Normansrule/seedforge/docs/modules/README.md

# Modules

| module | name | phase | status |
|---|---|---|---|
| [M1](M1-feed-tension.md) | Feed + tension | 1 | core - designed, CAD-checked, not built |
| [M2](M2-winding.md) | Synchronized winding | 1 | core - designed, CAD-checked; firmware compile-tested + unit-tested |
| [M3](M3-clamp-cut-demold.md) | Clamp + cut + demold | 2 | core - sequence SOFTWARE-TESTED (host tests + simulator); mounting to the core cell open |
| [M4](M4-tail-forming.md) | Auxiliary tail forming | 3 | experimental - R3 fixture parts, not built |
| [M5](M5-free-drying.md) | Free drying | 4 | experimental |
| [M6](M6-assembly.md) | Seed + tip + three-tail assembly | 5 | experimental development tooling |
| [M7](M7-vision-qa.md) | Computer-vision QA | 6 | core camera in Phase 1; software tested on synthetic images only |
| [M8](M8-output.md) | Output storage | 5 | experimental |
| [M9](M9-xy-transfer.md) | XY transfer (optional) | 7 | upcoming - start manually |
| [M10](M10-drone-cassette.md) | Drone cassette (optional, downstream) | 8 | concept only - not flight-validated |
