Normansrule/seedforge/archive/seedforge-r3-package/cad/paper_reference/reference_manifest.csv

name | bbox_mm | step | stl | 3mf
MR01_0p8mm_x100mm_FORMING_MANDREL_REFERENCE | 0.80 x 0.80 x 100.00 | MR01_0p8mm_x100mm_FORMING_MANDREL_REFERENCE.step | MR01_0p8mm_x100mm_FORMING_MANDREL_REFERENCE.stl | MR01_0p8mm_x100mm_FORMING_MANDREL_REFERENCE.3mf
MR02_0p8mm_to_5mm_split_collet_INSERT | 5.00 x 5.00 x 12.00 | MR02_0p8mm_to_5mm_split_collet_INSERT.step | MR02_0p8mm_to_5mm_split_collet_INSERT.stl | MR02_0p8mm_to_5mm_split_collet_INSERT.3mf
MR03_mandrel_depth_stop_M2 | 8.00 x 8.00 x 5.00 | MR03_mandrel_depth_stop_M2.step | MR03_mandrel_depth_stop_M2.stl | MR03_mandrel_depth_stop_M2.3mf
MR04_0p8mm_guide_bushing | 8.00 x 8.00 x 10.00 | MR04_0p8mm_guide_bushing.step | MR04_0p8mm_guide_bushing.stl | MR04_0p8mm_guide_bushing.3mf
MR05_3mm_x140mm_LARGE_PINE_MANDREL_REFERENCE | 3.00 x 3.00 x 140.00 | MR05_3mm_x140mm_LARGE_PINE_MANDREL_REFERENCE.step | MR05_3mm_x140mm_LARGE_PINE_MANDREL_REFERENCE.stl | MR05_3mm_x140mm_LARGE_PINE_MANDREL_REFERENCE.3mf
MR06_COMPLETE_0p8mm_MANDREL_SUBASSEMBLY_REFERENCE | 12.00 x 12.00 x 124.00 | MR06_COMPLETE_0p8mm_MANDREL_SUBASSEMBLY_REFERENCE.step | MR06_COMPLETE_0p8mm_MANDREL_SUBASSEMBLY_REFERENCE.stl | MR06_COMPLETE_0p8mm_MANDREL_SUBASSEMBLY_REFERENCE.3mf
MR07_0p8mm_MANDREL_WITH_STANDARD_7COIL_BODY_REFERENCE | 2.64 x 2.64 x 100.79 | MR07_0p8mm_MANDREL_WITH_STANDARD_7COIL_BODY_REFERENCE.step | MR07_0p8mm_MANDREL_WITH_STANDARD_7COIL_BODY_REFERENCE.stl | MR07_0p8mm_MANDREL_WITH_STANDARD_7COIL_BODY_REFERENCE.3mf
PR01_standard_7coil_body_2p5x0p5_on_0p8 | 2.64 x 2.64 x 36.58 | PR01_standard_7coil_body_2p5x0p5_on_0p8.step | PR01_standard_7coil_body_2p5x0p5_on_0p8.stl | PR01_standard_7coil_body_2p5x0p5_on_0p8.3mf
PR02_standard_tail1_27mm | 12.18 x 10.48 x 13.21 | PR02_standard_tail1_27mm.step | PR02_standard_tail1_27mm.stl | PR02_standard_tail1_27mm.3mf
PR03_standard_tail2_29p5mm | 14.77 x 11.61 x 13.27 | PR03_standard_tail2_29p5mm.step | PR03_standard_tail2_29p5mm.stl | PR03_standard_tail2_29p5mm.3mf
PR04_standard_tail3_32p5mm | 11.02 x 17.51 x 13.34 | PR04_standard_tail3_32p5mm.step | PR04_standard_tail3_32p5mm.stl | PR04_standard_tail3_32p5mm.3mf
PR05_standard_tip_outer_reference | 5.51 x 5.53 x 14.50 | PR05_standard_tip_outer_reference.step | PR05_standard_tip_outer_reference.stl | PR05_standard_tip_outer_reference.3mf
PR06_standard_seed_payload_envelope | 3.60 x 2.50 x 4.80 | PR06_standard_seed_payload_envelope.step | PR06_standard_seed_payload_envelope.stl | PR06_standard_seed_payload_envelope.3mf
PR07_tip_hair_clearance_envelope | 9.28 x 9.26 x 16.70 | PR07_tip_hair_clearance_envelope.step | PR07_tip_hair_clearance_envelope.stl | PR07_tip_hair_clearance_envelope.3mf
PR08_STANDARD_FINISHED_3TAIL_SEED_CARRIER_1TO1 | 18.67 x 22.02 x 54.48 | PR08_STANDARD_FINISHED_3TAIL_SEED_CARRIER_1TO1.step | PR08_STANDARD_FINISHED_3TAIL_SEED_CARRIER_1TO1.stl | PR08_STANDARD_FINISHED_3TAIL_SEED_CARRIER_1TO1.3mf
PR09_STANDARD_SEED_CARRIER_EXPLODED_1TO1 | 48.28 x 55.10 x 84.48 | PR09_STANDARD_SEED_CARRIER_EXPLODED_1TO1.step | PR09_STANDARD_SEED_CARRIER_EXPLODED_1TO1.stl | PR09_STANDARD_SEED_CARRIER_EXPLODED_1TO1.3mf
PR10_primary_blank_48x2p5x0p5_reference | 48.00 x 2.50 x 0.50 | PR10_primary_blank_48x2p5x0p5_reference.step | PR10_primary_blank_48x2p5x0p5_reference.stl | PR10_primary_blank_48x2p5x0p5_reference.3mf
PR11_aux_tail_blank_29p5x2p5x0p5_reference | 29.50 x 2.50 x 0.50 | PR11_aux_tail_blank_29p5x2p5x0p5_reference.step | PR11_aux_tail_blank_29p5x2p5x0p5_reference.stl | PR11_aux_tail_blank_29p5x2p5x0p5_reference.3mf
PR12_aux_tail_blank_32p5x2p5x0p5_reference | 32.50 x 2.50 x 0.50 | PR12_aux_tail_blank_32p5x2p5x0p5_reference.step | PR12_aux_tail_blank_32p5x2p5x0p5_reference.stl | PR12_aux_tail_blank_32p5x2p5x0p5_reference.3mf
PR20_LARGE_PINE_7COIL_BODY_12x0p8_on_3mm | 9.72 x 9.72 x 93.41 | PR20_LARGE_PINE_7COIL_BODY_12x0p8_on_3mm.step | PR20_LARGE_PINE_7COIL_BODY_12x0p8_on_3mm.stl | PR20_LARGE_PINE_7COIL_BODY_12x0p8_on_3mm.3mf
PR21_whitebark_pine_seed_11mm_ENVELOPE | 9.00 x 5.51 x 11.00 | PR21_whitebark_pine_seed_11mm_ENVELOPE.step | PR21_whitebark_pine_seed_11mm_ENVELOPE.stl | PR21_whitebark_pine_seed_11mm_ENVELOPE.3mf
PR22_large_pine_tip_outer_ENVELOPE | 14.26 x 14.25 x 29.00 | PR22_large_pine_tip_outer_ENVELOPE.step | PR22_large_pine_tip_outer_ENVELOPE.stl | PR22_large_pine_tip_outer_ENVELOPE.3mf
PR23_LARGE_PINE_BODY_TIP_SEED_REFERENCE_NO_TAILS | 14.26 x 14.25 x 117.21 | PR23_LARGE_PINE_BODY_TIP_SEED_REFERENCE_NO_TAILS.step | PR23_LARGE_PINE_BODY_TIP_SEED_REFERENCE_NO_TAILS.stl | PR23_LARGE_PINE_BODY_TIP_SEED_REFERENCE_NO_TAILS.3mf
PR24_STANDARD_FINISHED_CARRIER_3X_DEMO_PRINT | 56.00 x 66.03 x 163.44 | PR24_STANDARD_FINISHED_CARRIER_3X_DEMO_PRINT.step | PR24_STANDARD_FINISHED_CARRIER_3X_DEMO_PRINT.stl | PR24_STANDARD_FINISHED_CARRIER_3X_DEMO_PRINT.3mf
