Normansrule/seedforge/docs/diagrams/B_electronics_hierarchy.png

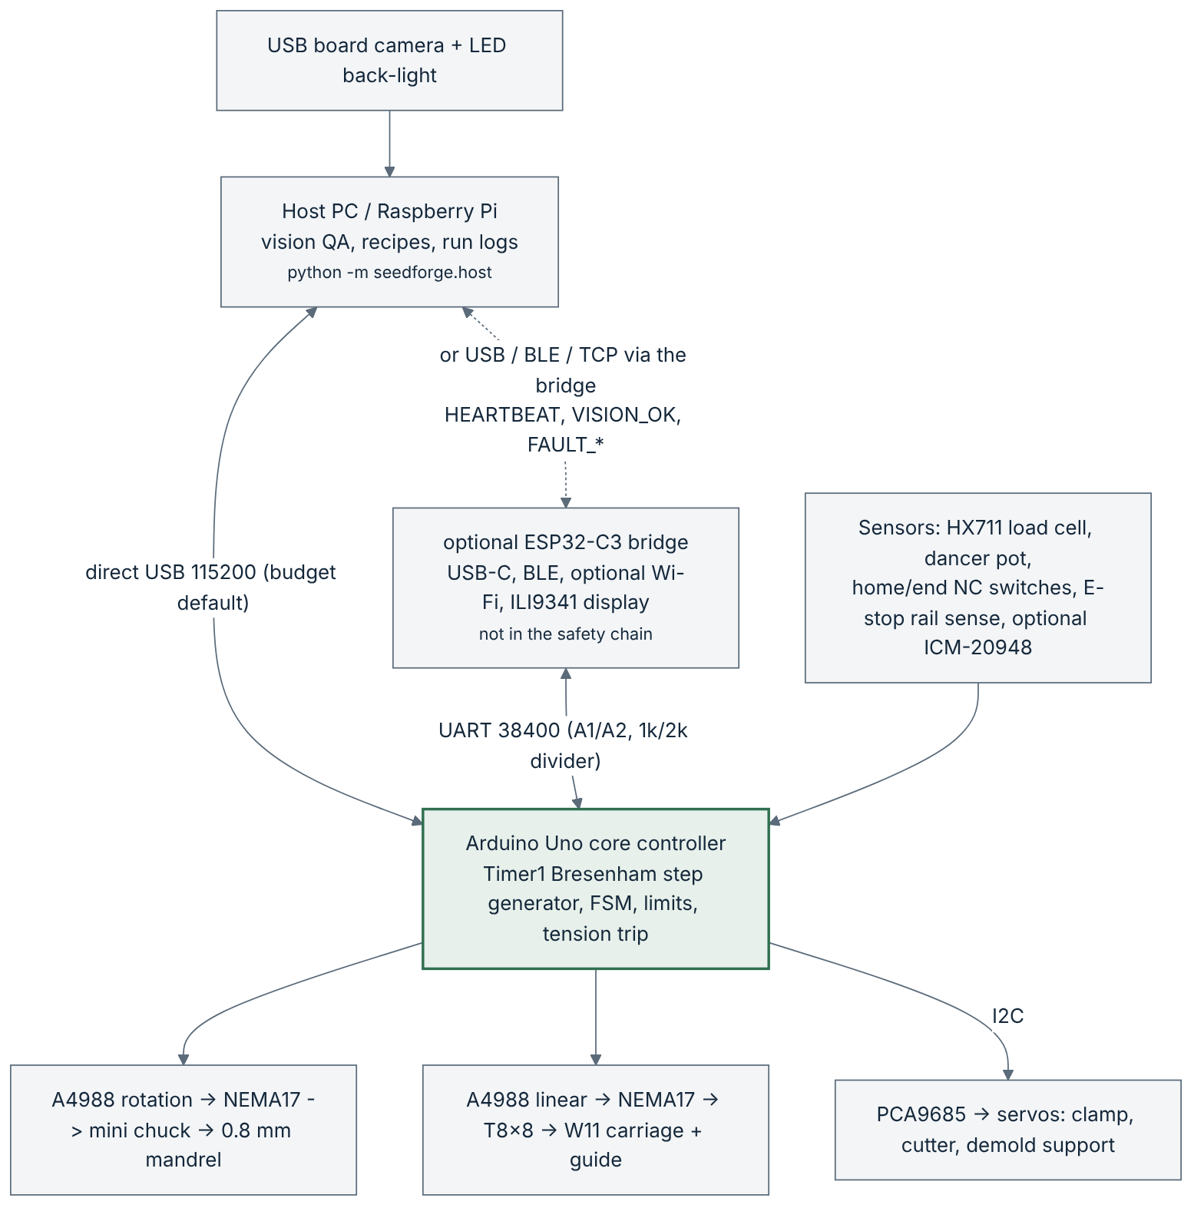
docs/diagrams/B_electronics_hierarchy.png
