Normansrule/seedforge/docs/diagrams/C_power_tree.png

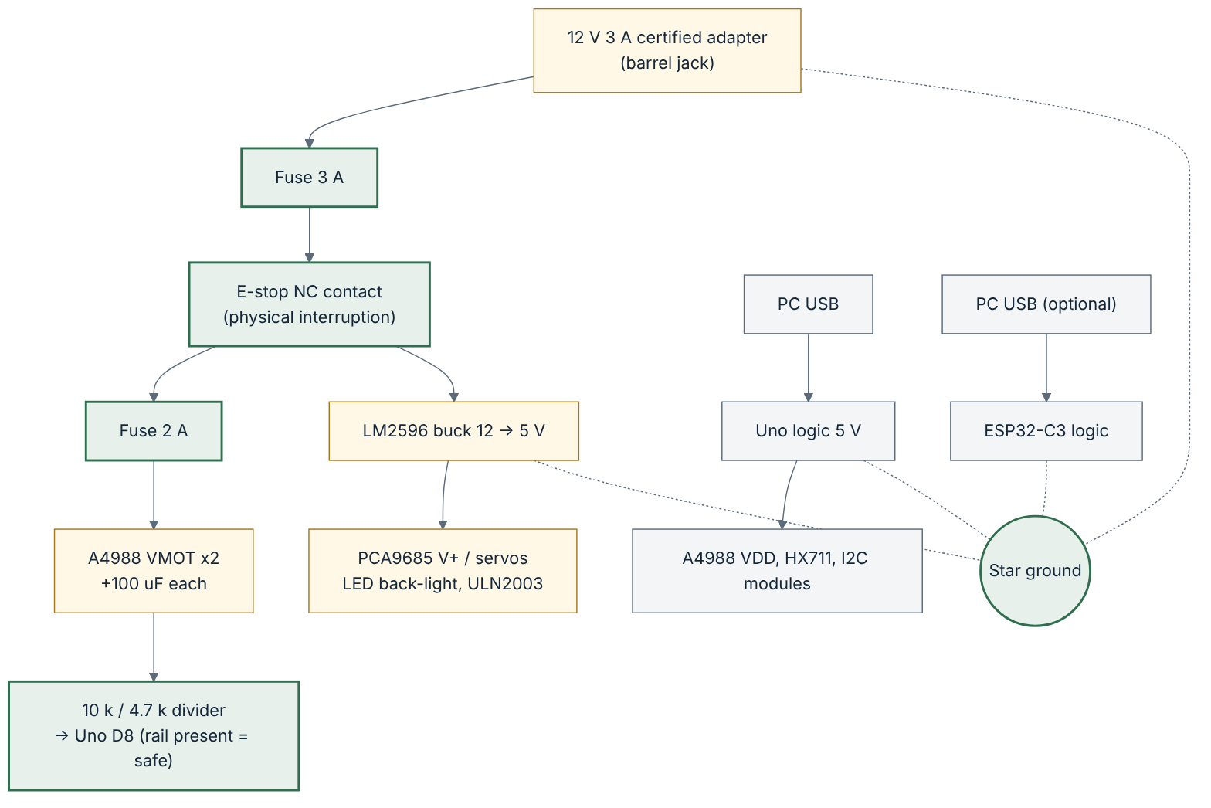
docs/diagrams/C_power_tree.png
