Normansrule/seedforge/docs/diagrams/D_arduino_pin_map.png

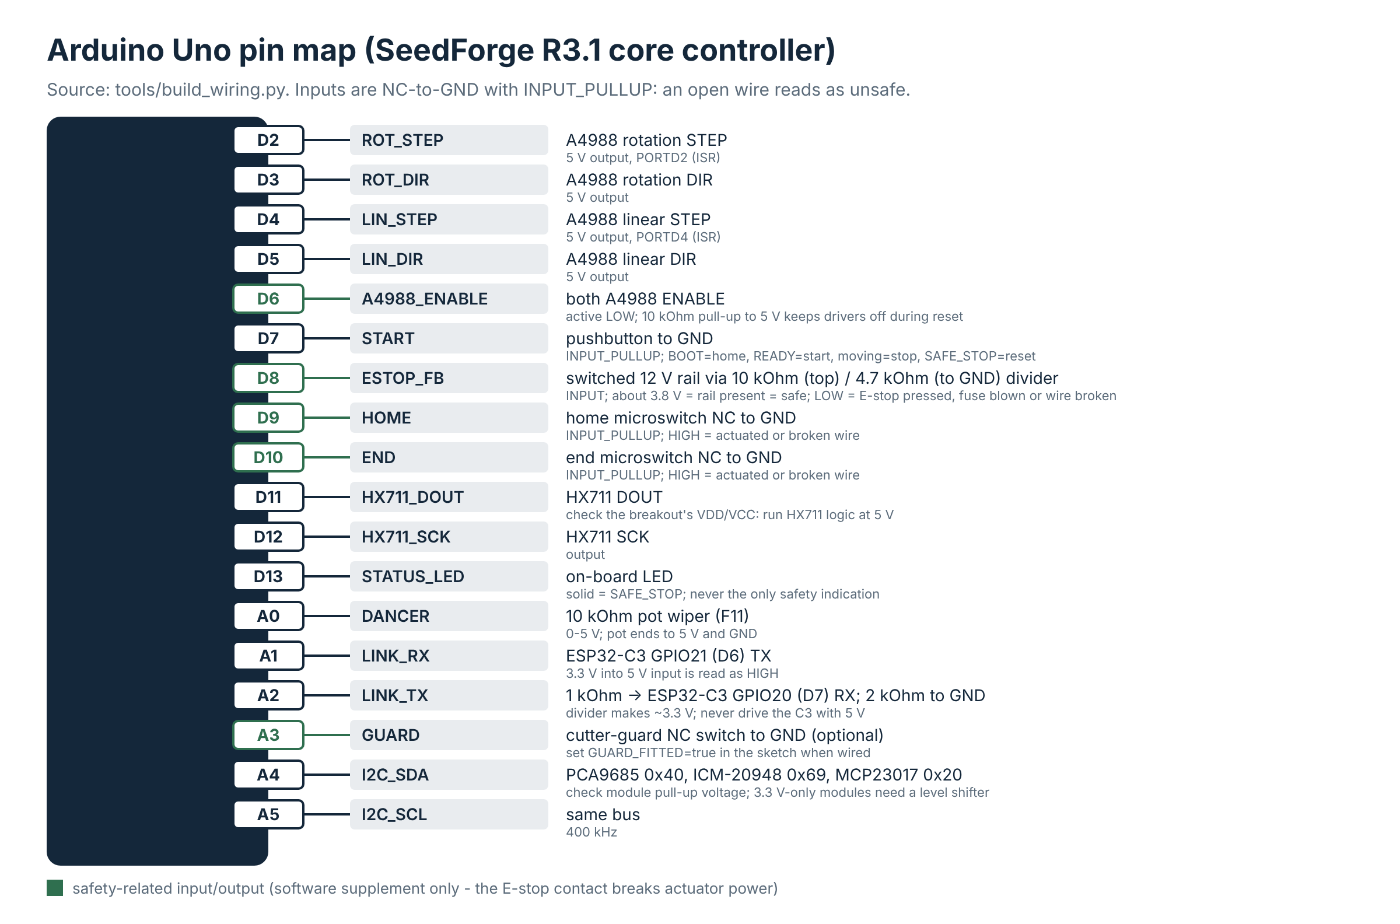
docs/diagrams/D_arduino_pin_map.png
