Normansrule/seedforge/docs/diagrams/E_state_machine.png

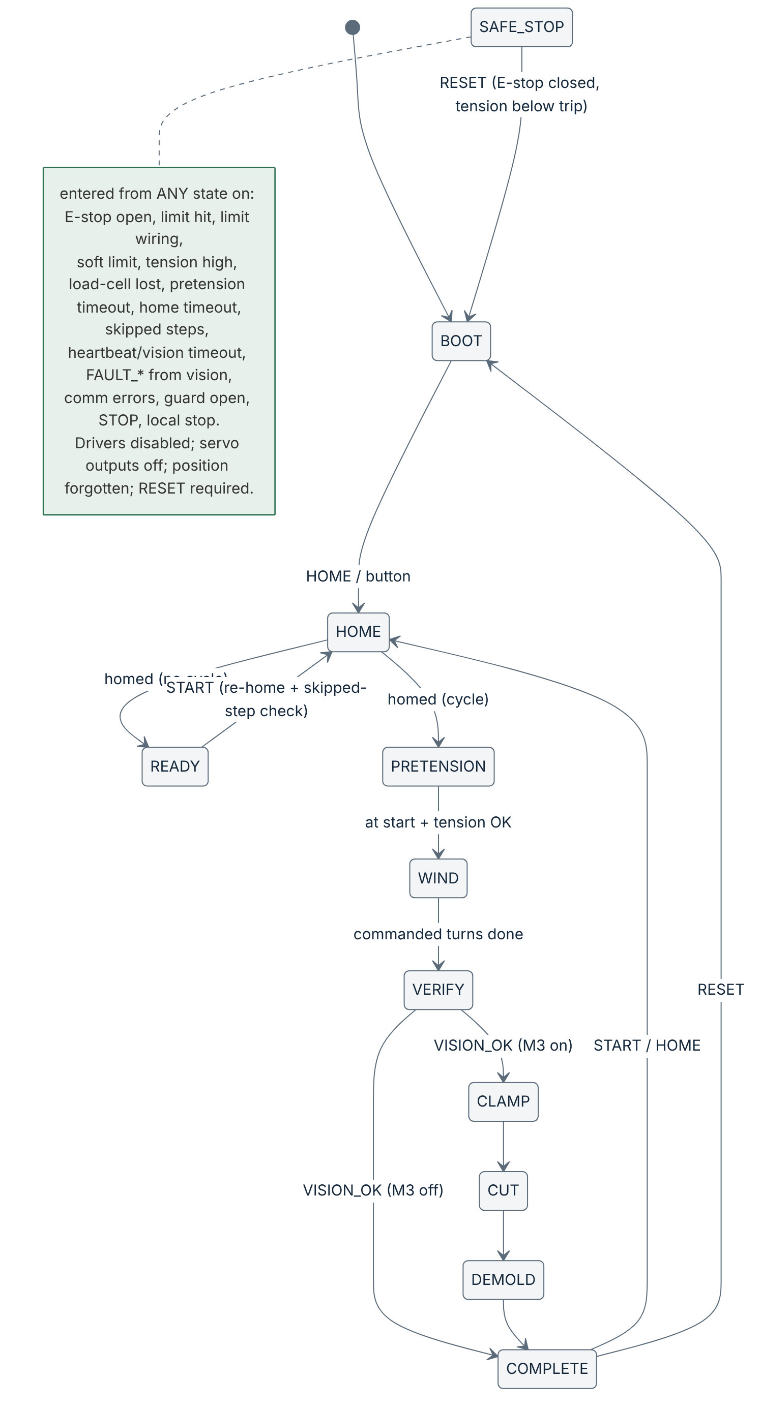
docs/diagrams/E_state_machine.png
