Normansrule/seedforge/docs/diagrams/F_protocol_sequence.png

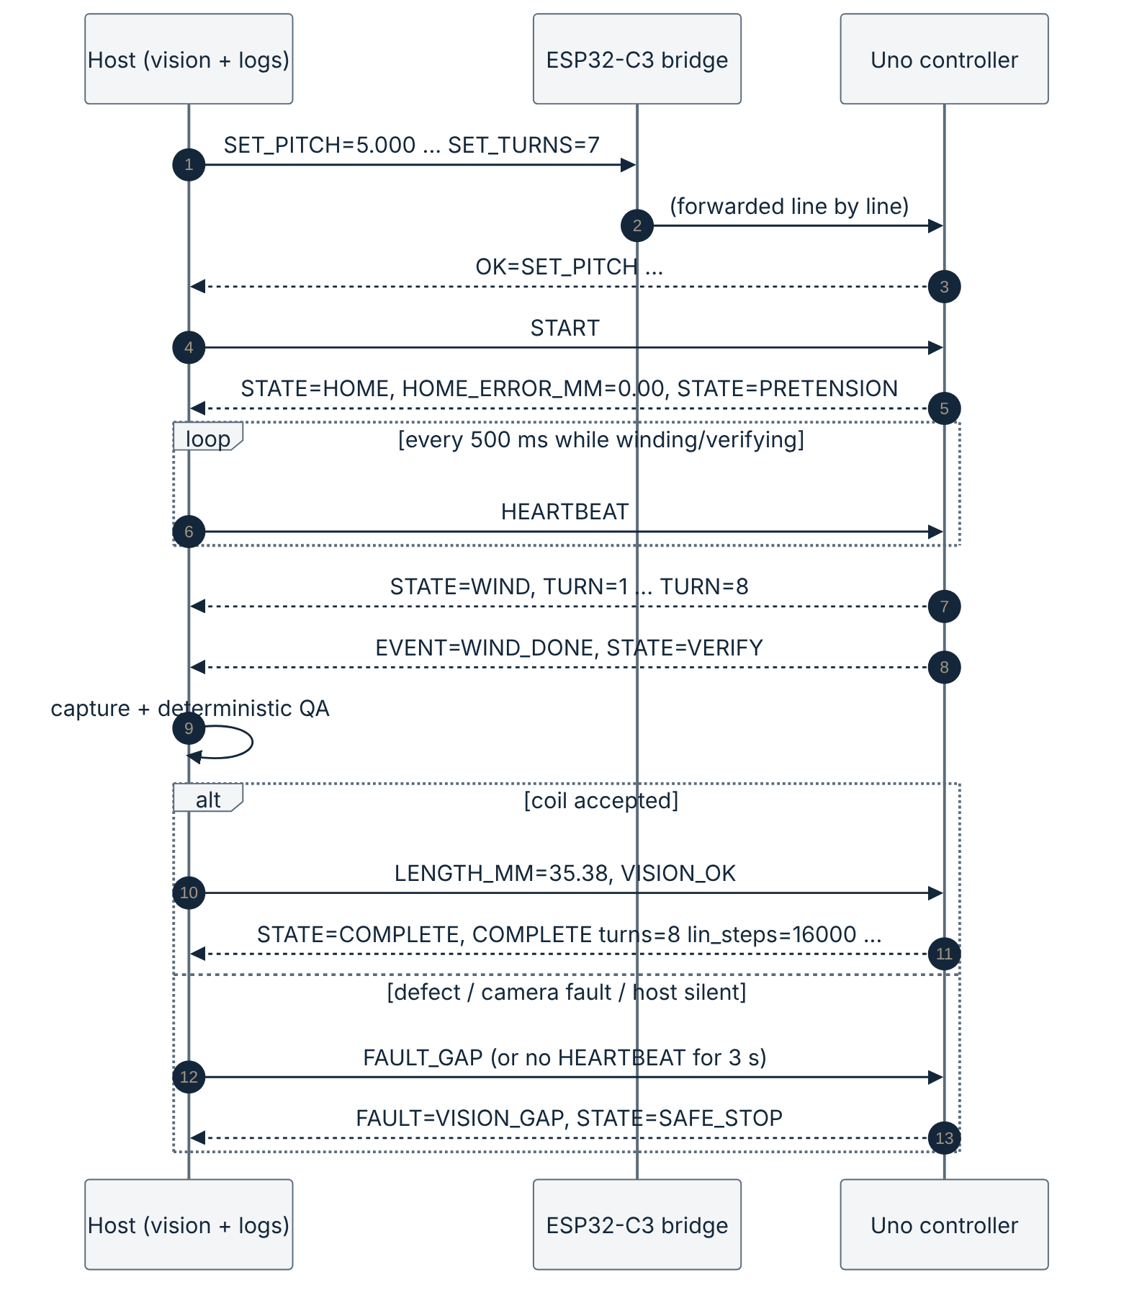
docs/diagrams/F_protocol_sequence.png
