Normansrule/seedforge/docs/diagrams/G_safety_chain.png

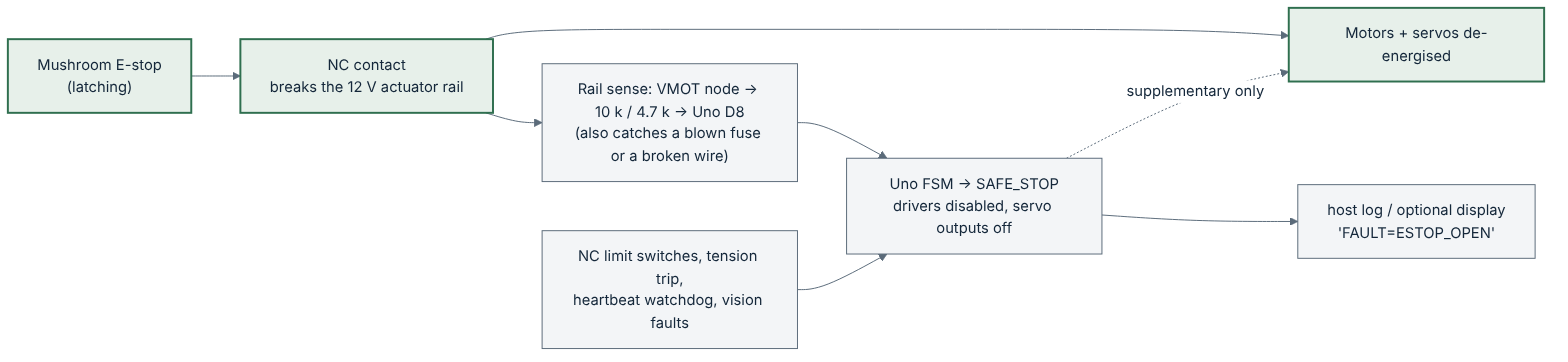
docs/diagrams/G_safety_chain.png
