Normansrule/seedforge/docs/diagrams/H_data_flow.png

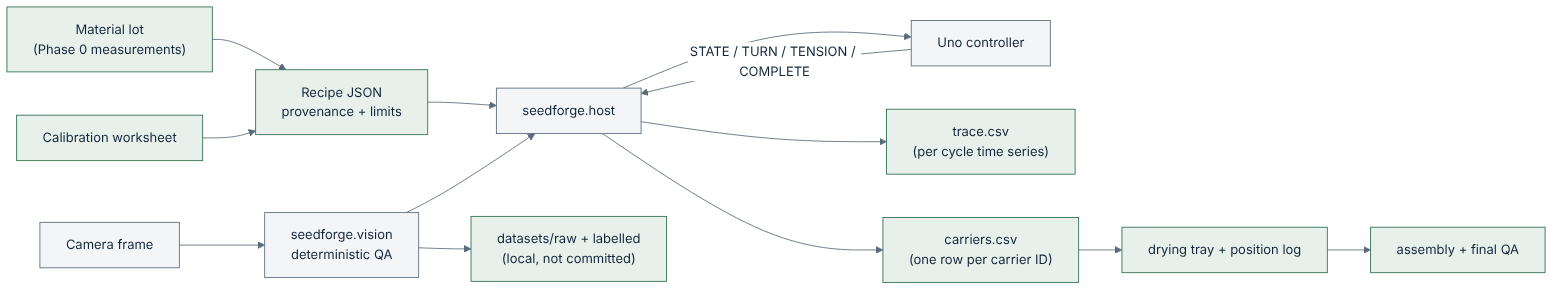
docs/diagrams/H_data_flow.png
