Normansrule/seedforge/docs/diagrams/I_drone_payload.png

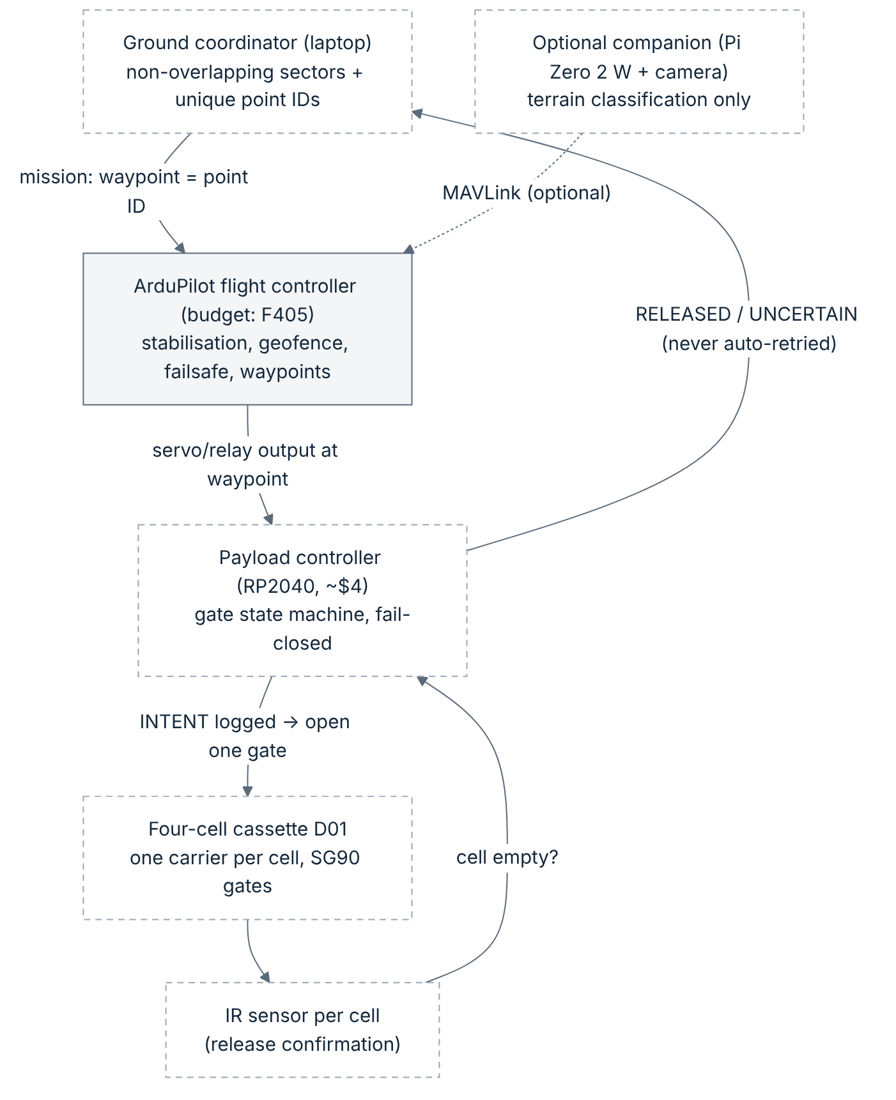
docs/diagrams/I_drone_payload.png
