Normansrule/seedforge/docs/images/mandrel_closeup.png

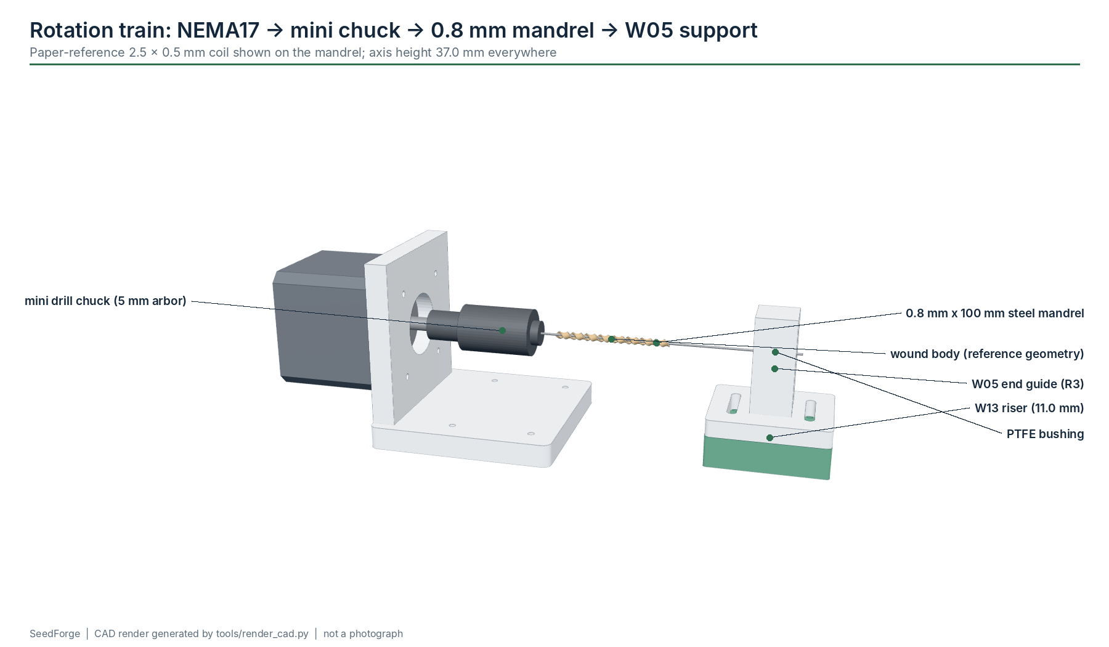
docs/images/mandrel_closeup.png
