Normansrule/seedforge/docs/images/seed_carrier_exploded.png

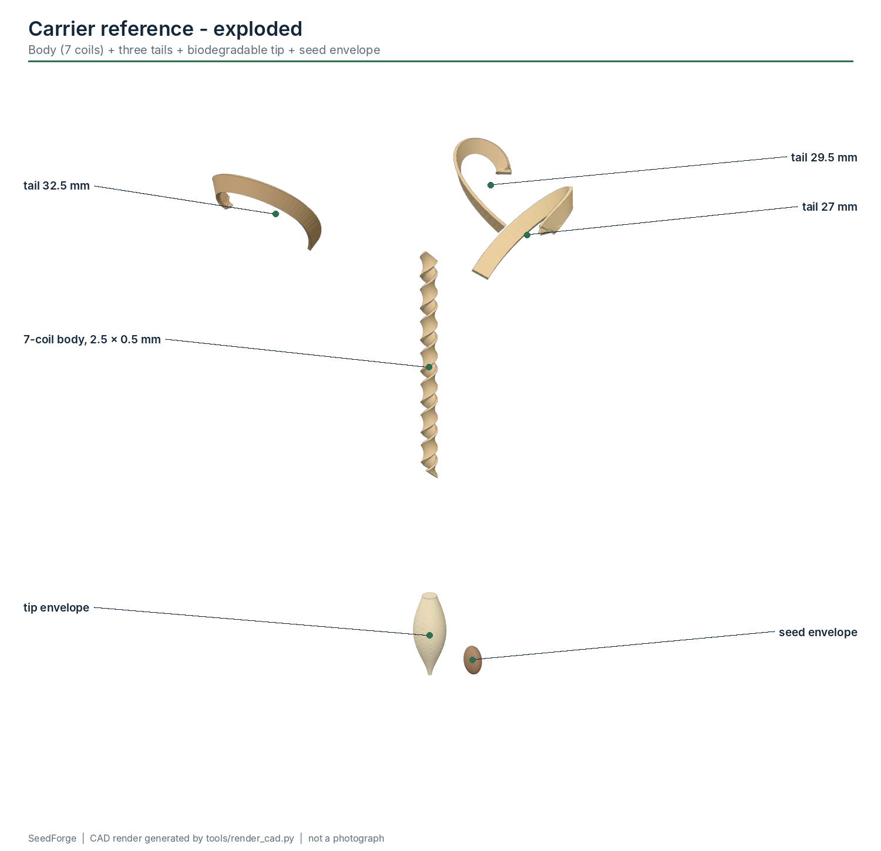
docs/images/seed_carrier_exploded.png
