Normansrule/seedforge/hardware/electronics/seedforge_core_schematic.png

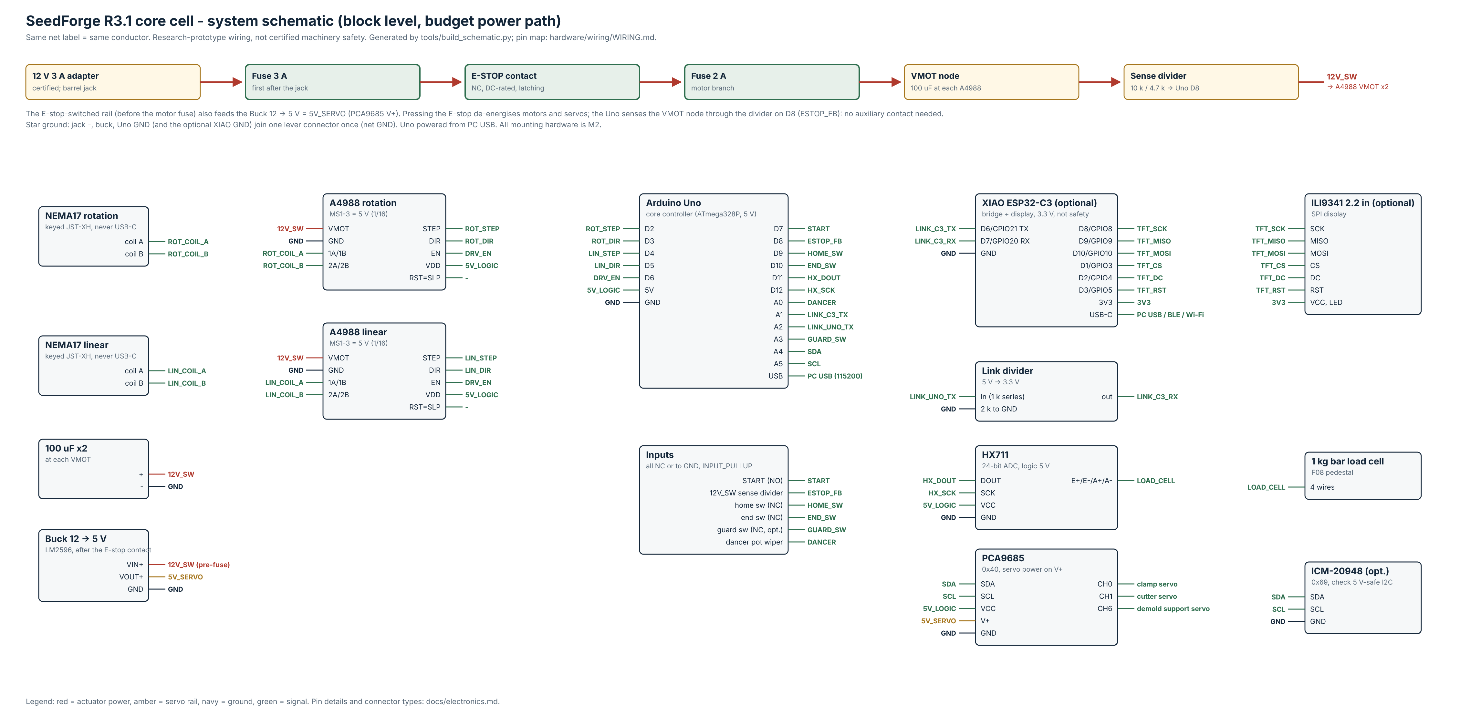
hardware/electronics/seedforge_core_schematic.png
