Normansrule/seedforge/docs/project/r3-inventory.md

# R3 package inventory

Every file in `SeedForge_R3_RealWorld_COMPLETE.zip` (316 files, 80 MB unpacked) and where it went.
Generated once from the supplied archive on 2026-10-11. Nothing was silently overwritten: original documents, BOMs, wiring,
firmware and generator are preserved under `archive/`; meshes are regenerated from the editable sources.

| top-level folder | files |
|---|---|
| (root) | 1 |
| bom | 4 |
| cad | 246 |
| docs | 5 |
| previews | 12 |
| r3_docs | 11 |
| r3_quick_prints | 23 |
| r3_validation | 2 |
| software | 10 |
| wiring | 2 |

| file | bytes | disposition in this repository |
|---|---|---|
| `START_HERE.md` | 5,851 | archive/seedforge-r3-package/START_HERE.md |
| `bom/SeedForge_R1_BOM.csv` | 7,921 | archive/seedforge-r3-package/bom/SeedForge_R1_BOM.csv |
| `bom/SeedForge_R2_BOM.csv` | 8,744 | archive/seedforge-r3-package/bom/SeedForge_R2_BOM.csv |
| `bom/SeedForge_R3_MINIMUM_CORE_BOM.csv` | 2,289 | archive/seedforge-r3-package/bom/SeedForge_R3_MINIMUM_CORE_BOM.csv |
| `bom/SeedForge_R3_PHASED_PURCHASE_PLAN.csv` | 9,613 | archive/seedforge-r3-package/bom/SeedForge_R3_PHASED_PURCHASE_PLAN.csv |
| `cad/3mf/C01_module_base_160x120.3mf` | 61,232 | regenerated from STEP into hardware/cad/stl|3mf/machine/ |
| `cad/3mf/C02_cable_clip_dual.3mf` | 8,263 | regenerated from STEP into hardware/cad/stl|3mf/machine/ |
| `cad/3mf/C03_electronics_box.3mf` | 14,032 | regenerated from STEP into hardware/cad/stl|3mf/machine/ |
| `cad/3mf/C04_electronics_vented_lid.3mf` | 27,159 | regenerated from STEP into hardware/cad/stl|3mf/machine/ |
| `cad/3mf/C05_ili9341_bezel.3mf` | 7,681 | regenerated from STEP into hardware/cad/stl|3mf/machine/ |
| `cad/3mf/D01_four_cell_payload_cassette.3mf` | 4,148 | regenerated from STEP into hardware/cad/stl|3mf/machine/ |
| `cad/3mf/D02_single_drop_door.3mf` | 10,445 | regenerated from STEP into hardware/cad/stl|3mf/machine/ |
| `cad/3mf/D03_payload_servo_mount.3mf` | 13,404 | regenerated from STEP into hardware/cad/stl|3mf/machine/ |
| `cad/3mf/D04_payload_rail_adapter.3mf` | 12,381 | regenerated from STEP into hardware/cad/stl|3mf/machine/ |
| `cad/3mf/D05_pi_zero2w_companion_plate.3mf` | 17,422 | regenerated from STEP into hardware/cad/stl|3mf/machine/ |
| `cad/3mf/D06_downward_camera_mount.3mf` | 8,142 | regenerated from STEP into hardware/cad/stl|3mf/machine/ |
| `cad/3mf/F01_spool_stand_left.3mf` | 12,476 | regenerated from STEP into hardware/cad/stl|3mf/machine/ |
| `cad/3mf/F02_spool_stand_right.3mf` | 15,235 | regenerated from STEP into hardware/cad/stl|3mf/machine/ |
| `cad/3mf/F03_spool_hub.3mf` | 14,946 | regenerated from STEP into hardware/cad/stl|3mf/machine/ |
| `cad/3mf/F04_dancer_arm.3mf` | 10,421 | regenerated from STEP into hardware/cad/stl|3mf/machine/ |
| `cad/3mf/F05_dancer_roller.3mf` | 10,404 | regenerated from STEP into hardware/cad/stl|3mf/machine/ |
| `cad/3mf/F06_veneer_guide_45deg_lower.3mf` | 5,909 | regenerated from STEP into hardware/cad/stl|3mf/machine/ |
| `cad/3mf/F07_veneer_guide_lid.3mf` | 12,566 | regenerated from STEP into hardware/cad/stl|3mf/machine/ |
| `cad/3mf/O01_finished_seedpod_tray_12.3mf` | 3,221 | regenerated from STEP into hardware/cad/stl|3mf/machine/ |
| `cad/3mf/Q01_free_dry_tray.3mf` | 18,586 | regenerated from STEP into hardware/cad/stl|3mf/machine/ |
| `cad/3mf/Q02_120mm_usb_fan_bracket.3mf` | 14,020 | regenerated from STEP into hardware/cad/stl|3mf/machine/ |
| `cad/3mf/Q03_camera_led_ring_plate.3mf` | 17,789 | regenerated from STEP into hardware/cad/stl|3mf/machine/ |
| `cad/3mf/R01_gantry_tool_plate.3mf` | 17,337 | regenerated from STEP into hardware/cad/stl|3mf/machine/ |
| `cad/3mf/R02_sg90_gripper_body.3mf` | 12,502 | regenerated from STEP into hardware/cad/stl|3mf/machine/ |
| `cad/3mf/R03_soft_gripper_finger.3mf` | 7,870 | regenerated from STEP into hardware/cad/stl|3mf/machine/ |
| `cad/3mf/R04_vwheel_or_mgn12_carriage_adapter.3mf` | 17,369 | regenerated from STEP into hardware/cad/stl|3mf/machine/ |
| `cad/3mf/R05_gt2_nema17_corner_mount.3mf` | 15,342 | regenerated from STEP into hardware/cad/stl|3mf/machine/ |
| `cad/3mf/R06_gt2_idler_corner_mount.3mf` | 8,436 | regenerated from STEP into hardware/cad/stl|3mf/machine/ |
| `cad/3mf/R07_xy_tool_carriage.3mf` | 17,464 | regenerated from STEP into hardware/cad/stl|3mf/machine/ |
| `cad/3mf/R08_z_lift_servo_mount.3mf` | 5,892 | regenerated from STEP into hardware/cad/stl|3mf/machine/ |
| `cad/3mf/S01_seed_hopper.3mf` | 8,849 | regenerated from STEP into hardware/cad/stl|3mf/machine/ |
| `cad/3mf/S02_seed_singulator_disk_6mm.3mf` | 32,350 | regenerated from STEP into hardware/cad/stl|3mf/machine/ |
| `cad/3mf/S03_28byj_seed_indexer_mount.3mf` | 12,515 | regenerated from STEP into hardware/cad/stl|3mf/machine/ |
| `cad/3mf/S04_three_tail_assembly_nest.3mf` | 14,213 | regenerated from STEP into hardware/cad/stl|3mf/machine/ |
| `cad/3mf/S05_10ml_syringe_holder.3mf` | 14,150 | regenerated from STEP into hardware/cad/stl|3mf/machine/ |
| `cad/3mf/S06_syringe_plunger_carriage.3mf` | 17,736 | regenerated from STEP into hardware/cad/stl|3mf/machine/ |
| `cad/3mf/S07_tip_mold_half_A.3mf` | 17,829 | regenerated from STEP into hardware/cad/stl|3mf/machine/ |
| `cad/3mf/S08_tip_mold_half_B.3mf` | 17,830 | regenerated from STEP into hardware/cad/stl|3mf/machine/ |
| `cad/3mf/T01_tail_former_left.3mf` | 8,527 | regenerated from STEP into hardware/cad/stl|3mf/machine/ |
| `cad/3mf/T02_tail_former_right.3mf` | 8,493 | regenerated from STEP into hardware/cad/stl|3mf/machine/ |
| `cad/3mf/T03_tail_sweep_shoe.3mf` | 5,686 | regenerated from STEP into hardware/cad/stl|3mf/machine/ |
| `cad/3mf/T04_tail_blank_clamp.3mf` | 13,211 | regenerated from STEP into hardware/cad/stl|3mf/machine/ |
| `cad/3mf/W01_nema17_rotation_mount.3mf` | 26,511 | regenerated from STEP into hardware/cad/stl|3mf/machine/ |
| `cad/3mf/W02_608_mandrel_support.3mf` | 14,161 | regenerated from STEP into hardware/cad/stl|3mf/machine/ |
| `cad/3mf/W03_lm8uu_linear_carriage.3mf` | 7,744 | regenerated from STEP into hardware/cad/stl|3mf/machine/ |
| `cad/3mf/W04_t8_nut_carrier.3mf` | 25,442 | regenerated from STEP into hardware/cad/stl|3mf/machine/ |
| `cad/3mf/W05_mandrel_end_guide.3mf` | 10,248 | regenerated from STEP into hardware/cad/stl|3mf/machine/ |
| `cad/3mf/W06_camera_tilt_mount.3mf` | 15,702 | regenerated from STEP into hardware/cad/stl|3mf/machine/ |
| `cad/3mf/W07_micro_release_clamp_lower.3mf` | 8,818 | regenerated from STEP into hardware/cad/stl|3mf/machine/ |
| `cad/3mf/W08_micro_release_clamp_upper.3mf` | 8,750 | regenerated from STEP into hardware/cad/stl|3mf/machine/ |
| `cad/3mf/X01_sg90_clamp_mount.3mf` | 13,816 | regenerated from STEP into hardware/cad/stl|3mf/machine/ |
| `cad/3mf/X02_soft_clamp_jaw.3mf` | 8,216 | regenerated from STEP into hardware/cad/stl|3mf/machine/ |
| `cad/3mf/X03_guarded_shear_mount.3mf` | 10,037 | regenerated from STEP into hardware/cad/stl|3mf/machine/ |
| `cad/3mf/X04_cutter_guard.3mf` | 8,954 | regenerated from STEP into hardware/cad/stl|3mf/machine/ |
| `cad/3mf/Z01_fit_calibration_coupon.3mf` | 27,580 | regenerated from STEP into hardware/cad/stl|3mf/machine/ |
| `cad/SeedForge_R1_parts_catalog.step` | 4,785,579 | not carried (spaced catalogue of the same parts; regenerable) |
| `cad/paper_reference/3mf/MR01_0p8mm_x100mm_FORMING_MANDREL_REFERENCE.3mf` | 7,381 | regenerated by hardware/cad/source/paper_reference.py |
| `cad/paper_reference/3mf/MR02_0p8mm_to_5mm_split_collet_INSERT.3mf` | 15,152 | regenerated by hardware/cad/source/paper_reference.py |
| `cad/paper_reference/3mf/MR03_mandrel_depth_stop_M2.3mf` | 55,011 | regenerated by hardware/cad/source/paper_reference.py |
| `cad/paper_reference/3mf/MR04_0p8mm_guide_bushing.3mf` | 13,910 | regenerated by hardware/cad/source/paper_reference.py |
| `cad/paper_reference/3mf/MR05_3mm_x140mm_LARGE_PINE_MANDREL_REFERENCE.3mf` | 7,299 | regenerated by hardware/cad/source/paper_reference.py |
| `cad/paper_reference/3mf/MR06_COMPLETE_0p8mm_MANDREL_SUBASSEMBLY_REFERENCE.3mf` | 71,153 | regenerated by hardware/cad/source/paper_reference.py |
| `cad/paper_reference/3mf/MR07_0p8mm_MANDREL_WITH_STANDARD_7COIL_BODY_REFERENCE.3mf` | 1,930,585 | regenerated by hardware/cad/source/paper_reference.py |
| `cad/paper_reference/3mf/PR01_standard_7coil_body_2p5x0p5_on_0p8.3mf` | 1,923,865 | regenerated by hardware/cad/source/paper_reference.py |
| `cad/paper_reference/3mf/PR02_standard_tail1_27mm.3mf` | 800,322 | regenerated by hardware/cad/source/paper_reference.py |
| `cad/paper_reference/3mf/PR03_standard_tail2_29p5mm.3mf` | 695,689 | regenerated by hardware/cad/source/paper_reference.py |
| `cad/paper_reference/3mf/PR04_standard_tail3_32p5mm.3mf` | 667,130 | regenerated by hardware/cad/source/paper_reference.py |
| `cad/paper_reference/3mf/PR05_standard_tip_outer_reference.3mf` | 136,559 | regenerated by hardware/cad/source/paper_reference.py |
| `cad/paper_reference/3mf/PR06_standard_seed_payload_envelope.3mf` | 107,483 | regenerated by hardware/cad/source/paper_reference.py |
| `cad/paper_reference/3mf/PR07_tip_hair_clearance_envelope.3mf` | 111,347 | regenerated by hardware/cad/source/paper_reference.py |
| `cad/paper_reference/3mf/PR08_STANDARD_FINISHED_3TAIL_SEED_CARRIER_1TO1.3mf` | 4,329,578 | regenerated by hardware/cad/source/paper_reference.py |
| `cad/paper_reference/3mf/PR09_STANDARD_SEED_CARRIER_EXPLODED_1TO1.3mf` | 4,208,820 | regenerated by hardware/cad/source/paper_reference.py |
| `cad/paper_reference/3mf/PR10_primary_blank_48x2p5x0p5_reference.3mf` | 1,417 | regenerated by hardware/cad/source/paper_reference.py |
| `cad/paper_reference/3mf/PR11_aux_tail_blank_29p5x2p5x0p5_reference.3mf` | 1,416 | regenerated by hardware/cad/source/paper_reference.py |
| `cad/paper_reference/3mf/PR12_aux_tail_blank_32p5x2p5x0p5_reference.3mf` | 1,418 | regenerated by hardware/cad/source/paper_reference.py |
| `cad/paper_reference/3mf/PR20_LARGE_PINE_7COIL_BODY_12x0p8_on_3mm.3mf` | 3,774,506 | regenerated by hardware/cad/source/paper_reference.py |
| `cad/paper_reference/3mf/PR21_whitebark_pine_seed_11mm_ENVELOPE.3mf` | 121,951 | regenerated by hardware/cad/source/paper_reference.py |
| `cad/paper_reference/3mf/PR22_large_pine_tip_outer_ENVELOPE.3mf` | 464,432 | regenerated by hardware/cad/source/paper_reference.py |
| `cad/paper_reference/3mf/PR23_LARGE_PINE_BODY_TIP_SEED_REFERENCE_NO_TAILS.3mf` | 4,359,686 | regenerated by hardware/cad/source/paper_reference.py |
| `cad/paper_reference/3mf/PR24_STANDARD_FINISHED_CARRIER_3X_DEMO_PRINT.3mf` | 2,255,915 | regenerated by hardware/cad/source/paper_reference.py |
| `cad/paper_reference/QA_reference_models.txt` | 2,354 | archive/seedforge-r3-package/cad/paper_reference/ (superseded by manifest + QA report) |
| `cad/paper_reference/README_PAPER_REFERENCE_MODELS.md` | 2,898 | archive/seedforge-r3-package/cad/paper_reference/ (superseded by manifest + QA report) |
| `cad/paper_reference/paper_reference_parameters.json` | 1,305 | archive/seedforge-r3-package/cad/paper_reference/ (superseded by manifest + QA report) |
| `cad/paper_reference/reference_manifest.csv` | 4,577 | archive/seedforge-r3-package/cad/paper_reference/ (superseded by manifest + QA report) |
| `cad/paper_reference/source/generate_paper_reference_models.py` | 22,594 | refactored -> hardware/cad/source/paper_reference.py; original archived |
| `cad/paper_reference/step/MR01_0p8mm_x100mm_FORMING_MANDREL_REFERENCE.step` | 5,758 | regenerated by hardware/cad/source/paper_reference.py |
| `cad/paper_reference/step/MR02_0p8mm_to_5mm_split_collet_INSERT.step` | 39,871 | regenerated by hardware/cad/source/paper_reference.py |
| `cad/paper_reference/step/MR03_mandrel_depth_stop_M2.step` | 86,720 | regenerated by hardware/cad/source/paper_reference.py |
| `cad/paper_reference/step/MR04_0p8mm_guide_bushing.step` | 9,564 | regenerated by hardware/cad/source/paper_reference.py |
| `cad/paper_reference/step/MR05_3mm_x140mm_LARGE_PINE_MANDREL_REFERENCE.step` | 5,763 | regenerated by hardware/cad/source/paper_reference.py |
| `cad/paper_reference/step/MR06_COMPLETE_0p8mm_MANDREL_SUBASSEMBLY_REFERENCE.step` | 106,100 | regenerated by hardware/cad/source/paper_reference.py |
| `cad/paper_reference/step/MR07_0p8mm_MANDREL_WITH_STANDARD_7COIL_BODY_REFERENCE.step` | 104,083 | regenerated by hardware/cad/source/paper_reference.py |
| `cad/paper_reference/step/PR01_standard_7coil_body_2p5x0p5_on_0p8.step` | 95,446 | regenerated by hardware/cad/source/paper_reference.py |
| `cad/paper_reference/step/PR02_standard_tail1_27mm.step` | 238,272 | regenerated by hardware/cad/source/paper_reference.py |
| `cad/paper_reference/step/PR03_standard_tail2_29p5mm.step` | 221,326 | regenerated by hardware/cad/source/paper_reference.py |
| `cad/paper_reference/step/PR04_standard_tail3_32p5mm.step` | 222,042 | regenerated by hardware/cad/source/paper_reference.py |
| `cad/paper_reference/step/PR05_standard_tip_outer_reference.step` | 15,777 | regenerated by hardware/cad/source/paper_reference.py |
| `cad/paper_reference/step/PR06_standard_seed_payload_envelope.step` | 16,121 | regenerated by hardware/cad/source/paper_reference.py |
| `cad/paper_reference/step/PR07_tip_hair_clearance_envelope.step` | 16,491 | regenerated by hardware/cad/source/paper_reference.py |
| `cad/paper_reference/step/PR08_STANDARD_FINISHED_3TAIL_SEED_CARRIER_1TO1.step` | 821,405 | regenerated by hardware/cad/source/paper_reference.py |
| `cad/paper_reference/step/PR09_STANDARD_SEED_CARRIER_EXPLODED_1TO1.step` | 824,601 | regenerated by hardware/cad/source/paper_reference.py |
| `cad/paper_reference/step/PR10_primary_blank_48x2p5x0p5_reference.step` | 15,462 | regenerated by hardware/cad/source/paper_reference.py |
| `cad/paper_reference/step/PR11_aux_tail_blank_29p5x2p5x0p5_reference.step` | 15,475 | regenerated by hardware/cad/source/paper_reference.py |
| `cad/paper_reference/step/PR12_aux_tail_blank_32p5x2p5x0p5_reference.step` | 15,475 | regenerated by hardware/cad/source/paper_reference.py |
| `cad/paper_reference/step/PR20_LARGE_PINE_7COIL_BODY_12x0p8_on_3mm.step` | 104,128 | regenerated by hardware/cad/source/paper_reference.py |
| `cad/paper_reference/step/PR21_whitebark_pine_seed_11mm_ENVELOPE.step` | 16,488 | regenerated by hardware/cad/source/paper_reference.py |
| `cad/paper_reference/step/PR22_large_pine_tip_outer_ENVELOPE.step` | 16,483 | regenerated by hardware/cad/source/paper_reference.py |
| `cad/paper_reference/step/PR23_LARGE_PINE_BODY_TIP_SEED_REFERENCE_NO_TAILS.step` | 141,195 | regenerated by hardware/cad/source/paper_reference.py |
| `cad/paper_reference/step/PR24_STANDARD_FINISHED_CARRIER_3X_DEMO_PRINT.step` | 821,766 | regenerated by hardware/cad/source/paper_reference.py |
| `cad/paper_reference/stl/MR01_0p8mm_x100mm_FORMING_MANDREL_REFERENCE.stl` | 16,684 | regenerated by hardware/cad/source/paper_reference.py |
| `cad/paper_reference/stl/MR02_0p8mm_to_5mm_split_collet_INSERT.stl` | 35,184 | regenerated by hardware/cad/source/paper_reference.py |
| `cad/paper_reference/stl/MR03_mandrel_depth_stop_M2.stl` | 82,084 | regenerated by hardware/cad/source/paper_reference.py |
| `cad/paper_reference/stl/MR04_0p8mm_guide_bushing.stl` | 33,684 | regenerated by hardware/cad/source/paper_reference.py |
| `cad/paper_reference/stl/MR05_3mm_x140mm_LARGE_PINE_MANDREL_REFERENCE.stl` | 16,684 | regenerated by hardware/cad/source/paper_reference.py |
| `cad/paper_reference/stl/MR06_COMPLETE_0p8mm_MANDREL_SUBASSEMBLY_REFERENCE.stl` | 132,984 | regenerated by hardware/cad/source/paper_reference.py |
| `cad/paper_reference/stl/MR07_0p8mm_MANDREL_WITH_STANDARD_7COIL_BODY_REFERENCE.stl` | 1,248,584 | regenerated by hardware/cad/source/paper_reference.py |
| `cad/paper_reference/stl/PR01_standard_7coil_body_2p5x0p5_on_0p8.stl` | 2,777,984 | regenerated by hardware/cad/source/paper_reference.py |
| `cad/paper_reference/stl/PR02_standard_tail1_27mm.stl` | 1,045,784 | regenerated by hardware/cad/source/paper_reference.py |
| `cad/paper_reference/stl/PR03_standard_tail2_29p5mm.stl` | 901,184 | regenerated by hardware/cad/source/paper_reference.py |
| `cad/paper_reference/stl/PR04_standard_tail3_32p5mm.stl` | 863,684 | regenerated by hardware/cad/source/paper_reference.py |
| `cad/paper_reference/stl/PR05_standard_tip_outer_reference.stl` | 184,684 | regenerated by hardware/cad/source/paper_reference.py |
| `cad/paper_reference/stl/PR06_standard_seed_payload_envelope.stl` | 160,484 | regenerated by hardware/cad/source/paper_reference.py |
| `cad/paper_reference/stl/PR07_tip_hair_clearance_envelope.stl` | 165,784 | regenerated by hardware/cad/source/paper_reference.py |
| `cad/paper_reference/stl/PR08_STANDARD_FINISHED_3TAIL_SEED_CARRIER_1TO1.stl` | 5,933,384 | regenerated by hardware/cad/source/paper_reference.py |
| `cad/paper_reference/stl/PR09_STANDARD_SEED_CARRIER_EXPLODED_1TO1.stl` | 5,799,084 | regenerated by hardware/cad/source/paper_reference.py |
| `cad/paper_reference/stl/PR10_primary_blank_48x2p5x0p5_reference.stl` | 684 | regenerated by hardware/cad/source/paper_reference.py |
| `cad/paper_reference/stl/PR11_aux_tail_blank_29p5x2p5x0p5_reference.stl` | 684 | regenerated by hardware/cad/source/paper_reference.py |
| `cad/paper_reference/stl/PR12_aux_tail_blank_32p5x2p5x0p5_reference.stl` | 684 | regenerated by hardware/cad/source/paper_reference.py |
| `cad/paper_reference/stl/PR20_LARGE_PINE_7COIL_BODY_12x0p8_on_3mm.stl` | 5,351,784 | regenerated by hardware/cad/source/paper_reference.py |
| `cad/paper_reference/stl/PR21_whitebark_pine_seed_11mm_ENVELOPE.stl` | 186,584 | regenerated by hardware/cad/source/paper_reference.py |
| `cad/paper_reference/stl/PR22_large_pine_tip_outer_ENVELOPE.stl` | 553,884 | regenerated by hardware/cad/source/paper_reference.py |
| `cad/paper_reference/stl/PR23_LARGE_PINE_BODY_TIP_SEED_REFERENCE_NO_TAILS.stl` | 6,092,084 | regenerated by hardware/cad/source/paper_reference.py |
| `cad/paper_reference/stl/PR24_STANDARD_FINISHED_CARRIER_3X_DEMO_PRINT.stl` | 3,014,884 | regenerated by hardware/cad/source/paper_reference.py |
| `cad/parameters.json` | 254 | archive/seedforge-r3-package/cad/ (metadata merged into part_catalog.py) |
| `cad/print_manifest.csv` | 9,515 | archive/seedforge-r3-package/cad/ (metadata merged into part_catalog.py) |
| `cad/print_manifest.json` | 19,267 | archive/seedforge-r3-package/cad/ (metadata merged into part_catalog.py) |
| `cad/step/C01_module_base_160x120.step` | 199,214 | hardware/cad/step/machine/ (source of truth) |
| `cad/step/C02_cable_clip_dual.step` | 83,221 | hardware/cad/step/machine/ (source of truth) |
| `cad/step/C03_electronics_box.step` | 96,662 | hardware/cad/step/machine/ (source of truth) |
| `cad/step/C04_electronics_vented_lid.step` | 154,264 | hardware/cad/step/machine/ (source of truth) |
| `cad/step/C05_ili9341_bezel.step` | 79,418 | hardware/cad/step/machine/ (source of truth) |
| `cad/step/D01_four_cell_payload_cassette.step` | 144,098 | hardware/cad/step/machine/ (source of truth) |
| `cad/step/D02_single_drop_door.step` | 46,007 | hardware/cad/step/machine/ (source of truth) |
| `cad/step/D03_payload_servo_mount.step` | 92,720 | hardware/cad/step/machine/ (source of truth) |
| `cad/step/D04_payload_rail_adapter.step` | 99,411 | hardware/cad/step/machine/ (source of truth) |
| `cad/step/D05_pi_zero2w_companion_plate.step` | 85,086 | hardware/cad/step/machine/ (source of truth) |
| `cad/step/D06_downward_camera_mount.step` | 67,076 | hardware/cad/step/machine/ (source of truth) |
| `cad/step/F01_spool_stand_left.step` | 64,592 | hardware/cad/step/machine/ (source of truth) |
| `cad/step/F02_spool_stand_right.step` | 69,527 | hardware/cad/step/machine/ (source of truth) |
| `cad/step/F03_spool_hub.step` | 28,583 | hardware/cad/step/machine/ (source of truth) |
| `cad/step/F04_dancer_arm.step` | 57,786 | hardware/cad/step/machine/ (source of truth) |
| `cad/step/F05_dancer_roller.step` | 19,587 | hardware/cad/step/machine/ (source of truth) |
| `cad/step/F06_veneer_guide_45deg_lower.step` | 90,768 | hardware/cad/step/machine/ (source of truth) |
| `cad/step/F07_veneer_guide_lid.step` | 50,995 | hardware/cad/step/machine/ (source of truth) |
| `cad/step/O01_finished_seedpod_tray_12.step` | 45,541 | hardware/cad/step/machine/ (source of truth) |
| `cad/step/Q01_free_dry_tray.step` | 159,439 | hardware/cad/step/machine/ (source of truth) |
| `cad/step/Q02_120mm_usb_fan_bracket.step` | 103,479 | hardware/cad/step/machine/ (source of truth) |
| `cad/step/Q03_camera_led_ring_plate.step` | 72,599 | hardware/cad/step/machine/ (source of truth) |
| `cad/step/R01_gantry_tool_plate.step` | 85,104 | hardware/cad/step/machine/ (source of truth) |
| `cad/step/R02_sg90_gripper_body.step` | 63,995 | hardware/cad/step/machine/ (source of truth) |
| `cad/step/R03_soft_gripper_finger.step` | 54,892 | hardware/cad/step/machine/ (source of truth) |
| `cad/step/R04_vwheel_or_mgn12_carriage_adapter.step` | 85,106 | hardware/cad/step/machine/ (source of truth) |
| `cad/step/R05_gt2_nema17_corner_mount.step` | 70,297 | hardware/cad/step/machine/ (source of truth) |
| `cad/step/R06_gt2_idler_corner_mount.step` | 67,233 | hardware/cad/step/machine/ (source of truth) |
| `cad/step/R07_xy_tool_carriage.step` | 85,114 | hardware/cad/step/machine/ (source of truth) |
| `cad/step/R08_z_lift_servo_mount.step` | 76,575 | hardware/cad/step/machine/ (source of truth) |
| `cad/step/S01_seed_hopper.step` | 56,079 | hardware/cad/step/machine/ (source of truth) |
| `cad/step/S02_seed_singulator_disk_6mm.step` | 59,577 | hardware/cad/step/machine/ (source of truth) |
| `cad/step/S03_28byj_seed_indexer_mount.step` | 64,215 | hardware/cad/step/machine/ (source of truth) |
| `cad/step/S04_three_tail_assembly_nest.step` | 92,784 | hardware/cad/step/machine/ (source of truth) |
| `cad/step/S05_10ml_syringe_holder.step` | 133,916 | hardware/cad/step/machine/ (source of truth) |
| `cad/step/S06_syringe_plunger_carriage.step` | 82,791 | hardware/cad/step/machine/ (source of truth) |
| `cad/step/S07_tip_mold_half_A.step` | 58,705 | hardware/cad/step/machine/ (source of truth) |
| `cad/step/S08_tip_mold_half_B.step` | 58,705 | hardware/cad/step/machine/ (source of truth) |
| `cad/step/T01_tail_former_left.step` | 49,965 | hardware/cad/step/machine/ (source of truth) |
| `cad/step/T02_tail_former_right.step` | 50,292 | hardware/cad/step/machine/ (source of truth) |
| `cad/step/T03_tail_sweep_shoe.step` | 39,260 | hardware/cad/step/machine/ (source of truth) |
| `cad/step/T04_tail_blank_clamp.step` | 90,422 | hardware/cad/step/machine/ (source of truth) |
| `cad/step/W01_nema17_rotation_mount.step` | 89,880 | hardware/cad/step/machine/ (source of truth) |
| `cad/step/W02_608_mandrel_support.step` | 80,041 | hardware/cad/step/machine/ (source of truth) |
| `cad/step/W03_lm8uu_linear_carriage.step` | 79,179 | hardware/cad/step/machine/ (source of truth) |
| `cad/step/W04_t8_nut_carrier.step` | 91,434 | hardware/cad/step/machine/ (source of truth) |
| `cad/step/W05_mandrel_end_guide.step` | 84,493 | hardware/cad/step/machine/ (source of truth) |
| `cad/step/W06_camera_tilt_mount.step` | 84,803 | hardware/cad/step/machine/ (source of truth) |
| `cad/step/W07_micro_release_clamp_lower.step` | 57,757 | hardware/cad/step/machine/ (source of truth) |
| `cad/step/W08_micro_release_clamp_upper.step` | 58,344 | hardware/cad/step/machine/ (source of truth) |
| `cad/step/X01_sg90_clamp_mount.step` | 122,856 | hardware/cad/step/machine/ (source of truth) |
| `cad/step/X02_soft_clamp_jaw.step` | 62,907 | hardware/cad/step/machine/ (source of truth) |
| `cad/step/X03_guarded_shear_mount.step` | 96,886 | hardware/cad/step/machine/ (source of truth) |
| `cad/step/X04_cutter_guard.step` | 84,508 | hardware/cad/step/machine/ (source of truth) |
| `cad/step/Z01_fit_calibration_coupon.step` | 147,510 | hardware/cad/step/machine/ (source of truth) |
| `cad/stl/C01_module_base_160x120.stl` | 323,084 | regenerated from STEP into hardware/cad/stl|3mf/machine/ |
| `cad/stl/C02_cable_clip_dual.stl` | 41,484 | regenerated from STEP into hardware/cad/stl|3mf/machine/ |
| `cad/stl/C03_electronics_box.stl` | 73,484 | regenerated from STEP into hardware/cad/stl|3mf/machine/ |
| `cad/stl/C04_electronics_vented_lid.stl` | 145,084 | regenerated from STEP into hardware/cad/stl|3mf/machine/ |
| `cad/stl/C05_ili9341_bezel.stl` | 41,284 | regenerated from STEP into hardware/cad/stl|3mf/machine/ |
| `cad/stl/D01_four_cell_payload_cassette.stl` | 20,684 | regenerated from STEP into hardware/cad/stl|3mf/machine/ |
| `cad/stl/D02_single_drop_door.stl` | 51,884 | regenerated from STEP into hardware/cad/stl|3mf/machine/ |
| `cad/stl/D03_payload_servo_mount.stl` | 66,884 | regenerated from STEP into hardware/cad/stl|3mf/machine/ |
| `cad/stl/D04_payload_rail_adapter.stl` | 67,084 | regenerated from STEP into hardware/cad/stl|3mf/machine/ |
| `cad/stl/D05_pi_zero2w_companion_plate.stl` | 91,484 | regenerated from STEP into hardware/cad/stl|3mf/machine/ |
| `cad/stl/D06_downward_camera_mount.stl` | 40,484 | regenerated from STEP into hardware/cad/stl|3mf/machine/ |
| `cad/stl/F01_spool_stand_left.stl` | 65,084 | regenerated from STEP into hardware/cad/stl|3mf/machine/ |
| `cad/stl/F02_spool_stand_right.stl` | 77,884 | regenerated from STEP into hardware/cad/stl|3mf/machine/ |
| `cad/stl/F03_spool_hub.stl` | 75,684 | regenerated from STEP into hardware/cad/stl|3mf/machine/ |
| `cad/stl/F04_dancer_arm.stl` | 52,484 | regenerated from STEP into hardware/cad/stl|3mf/machine/ |
| `cad/stl/F05_dancer_roller.stl` | 50,484 | regenerated from STEP into hardware/cad/stl|3mf/machine/ |
| `cad/stl/F06_veneer_guide_45deg_lower.stl` | 29,084 | regenerated from STEP into hardware/cad/stl|3mf/machine/ |
| `cad/stl/F07_veneer_guide_lid.stl` | 64,684 | regenerated from STEP into hardware/cad/stl|3mf/machine/ |
| `cad/stl/O01_finished_seedpod_tray_12.stl` | 14,284 | regenerated from STEP into hardware/cad/stl|3mf/machine/ |
| `cad/stl/Q01_free_dry_tray.stl` | 106,684 | regenerated from STEP into hardware/cad/stl|3mf/machine/ |
| `cad/stl/Q02_120mm_usb_fan_bracket.stl` | 67,484 | regenerated from STEP into hardware/cad/stl|3mf/machine/ |
| `cad/stl/Q03_camera_led_ring_plate.stl` | 90,884 | regenerated from STEP into hardware/cad/stl|3mf/machine/ |
| `cad/stl/R01_gantry_tool_plate.stl` | 91,484 | regenerated from STEP into hardware/cad/stl|3mf/machine/ |
| `cad/stl/R02_sg90_gripper_body.stl` | 64,684 | regenerated from STEP into hardware/cad/stl|3mf/machine/ |
| `cad/stl/R03_soft_gripper_finger.stl` | 39,884 | regenerated from STEP into hardware/cad/stl|3mf/machine/ |
| `cad/stl/R04_vwheel_or_mgn12_carriage_adapter.stl` | 91,484 | regenerated from STEP into hardware/cad/stl|3mf/machine/ |
| `cad/stl/R05_gt2_nema17_corner_mount.stl` | 78,284 | regenerated from STEP into hardware/cad/stl|3mf/machine/ |
| `cad/stl/R06_gt2_idler_corner_mount.stl` | 40,484 | regenerated from STEP into hardware/cad/stl|3mf/machine/ |
| `cad/stl/R07_xy_tool_carriage.stl` | 91,484 | regenerated from STEP into hardware/cad/stl|3mf/machine/ |
| `cad/stl/R08_z_lift_servo_mount.stl` | 28,484 | regenerated from STEP into hardware/cad/stl|3mf/machine/ |
| `cad/stl/S01_seed_hopper.stl` | 42,584 | regenerated from STEP into hardware/cad/stl|3mf/machine/ |
| `cad/stl/S02_seed_singulator_disk_6mm.stl` | 153,284 | regenerated from STEP into hardware/cad/stl|3mf/machine/ |
| `cad/stl/S03_28byj_seed_indexer_mount.stl` | 65,084 | regenerated from STEP into hardware/cad/stl|3mf/machine/ |
| `cad/stl/S04_three_tail_assembly_nest.stl` | 67,584 | regenerated from STEP into hardware/cad/stl|3mf/machine/ |
| `cad/stl/S05_10ml_syringe_holder.stl` | 67,484 | regenerated from STEP into hardware/cad/stl|3mf/machine/ |
| `cad/stl/S06_syringe_plunger_carriage.stl` | 88,484 | regenerated from STEP into hardware/cad/stl|3mf/machine/ |
| `cad/stl/S07_tip_mold_half_A.stl` | 90,084 | regenerated from STEP into hardware/cad/stl|3mf/machine/ |
| `cad/stl/S08_tip_mold_half_B.stl` | 90,084 | regenerated from STEP into hardware/cad/stl|3mf/machine/ |
| `cad/stl/T01_tail_former_left.stl` | 38,484 | regenerated from STEP into hardware/cad/stl|3mf/machine/ |
| `cad/stl/T02_tail_former_right.stl` | 38,484 | regenerated from STEP into hardware/cad/stl|3mf/machine/ |
| `cad/stl/T03_tail_sweep_shoe.stl` | 25,084 | regenerated from STEP into hardware/cad/stl|3mf/machine/ |
| `cad/stl/T04_tail_blank_clamp.stl` | 66,884 | regenerated from STEP into hardware/cad/stl|3mf/machine/ |
| `cad/stl/W01_nema17_rotation_mount.stl` | 129,484 | regenerated from STEP into hardware/cad/stl|3mf/machine/ |
| `cad/stl/W02_608_mandrel_support.stl` | 73,684 | regenerated from STEP into hardware/cad/stl|3mf/machine/ |
| `cad/stl/W03_lm8uu_linear_carriage.stl` | 41,084 | regenerated from STEP into hardware/cad/stl|3mf/machine/ |
| `cad/stl/W04_t8_nut_carrier.stl` | 129,484 | regenerated from STEP into hardware/cad/stl|3mf/machine/ |
| `cad/stl/W05_mandrel_end_guide.stl` | 53,884 | regenerated from STEP into hardware/cad/stl|3mf/machine/ |
| `cad/stl/W06_camera_tilt_mount.stl` | 78,884 | regenerated from STEP into hardware/cad/stl|3mf/machine/ |
| `cad/stl/W07_micro_release_clamp_lower.stl` | 40,184 | regenerated from STEP into hardware/cad/stl|3mf/machine/ |
| `cad/stl/W08_micro_release_clamp_upper.stl` | 40,184 | regenerated from STEP into hardware/cad/stl|3mf/machine/ |
| `cad/stl/X01_sg90_clamp_mount.stl` | 68,684 | regenerated from STEP into hardware/cad/stl|3mf/machine/ |
| `cad/stl/X02_soft_clamp_jaw.stl` | 40,184 | regenerated from STEP into hardware/cad/stl|3mf/machine/ |
| `cad/stl/X03_guarded_shear_mount.stl` | 54,484 | regenerated from STEP into hardware/cad/stl|3mf/machine/ |
| `cad/stl/X04_cutter_guard.stl` | 41,484 | regenerated from STEP into hardware/cad/stl|3mf/machine/ |
| `cad/stl/Z01_fit_calibration_coupon.stl` | 129,484 | regenerated from STEP into hardware/cad/stl|3mf/machine/ |
| `docs/BUILD_GUIDE.md` | 10,909 | archive/seedforge-r3-package/docs/BUILD_GUIDE.md |
| `docs/C01_plywood_drilling_template.svg` | 2,339 | hardware/drawings/ |
| `docs/PRINTABLE_PARTS_CHECKLIST.md` | 9,458 | archive/seedforge-r3-package/docs/PRINTABLE_PARTS_CHECKLIST.md |
| `docs/QA.txt` | 97 | archive/seedforge-r3-package/docs/QA.txt |
| `docs/summary.json` | 221 | archive/seedforge-r3-package/docs/summary.json |
| `previews/ALL_PRINTED_PARTS_actual_CAD.png` | 1,579,492 | archive/seedforge-r3-package/previews/ALL_PRINTED_PARTS_actual_CAD.png |
| `previews/DRONE_PAYLOAD_WIRING.png` | 213,757 | archive/seedforge-r3-package/previews/DRONE_PAYLOAD_WIRING.png |
| `previews/ELECTRONICS_ARCHITECTURE.png` | 175,804 | archive/seedforge-r3-package/previews/ELECTRONICS_ARCHITECTURE.png |
| `previews/FACTORY_PIN_WIRING.png` | 323,438 | archive/seedforge-r3-package/previews/FACTORY_PIN_WIRING.png |
| `previews/LARGE_PINE_BODY_REFERENCE_ACTUAL_CAD.png` | 73,102 | archive/seedforge-r3-package/previews/LARGE_PINE_BODY_REFERENCE_ACTUAL_CAD.png |
| `previews/LOW_COST_BENCH_LAYOUT.png` | 132,153 | archive/seedforge-r3-package/previews/LOW_COST_BENCH_LAYOUT.png |
| `previews/MANDREL_SUBASSEMBLY_ACTUAL_CAD.png` | 38,594 | archive/seedforge-r3-package/previews/MANDREL_SUBASSEMBLY_ACTUAL_CAD.png |
| `previews/MANDREL_WITH_COIL_ACTUAL_CAD.png` | 33,401 | archive/seedforge-r3-package/previews/MANDREL_WITH_COIL_ACTUAL_CAD.png |
| `previews/MANDREL_WITH_COIL_RENDER.png` | 21,408 | archive/seedforge-r3-package/previews/MANDREL_WITH_COIL_RENDER.png |
| `previews/PAPER_STANDARD_EXPLODED_ACTUAL_CAD.png` | 48,773 | archive/seedforge-r3-package/previews/PAPER_STANDARD_EXPLODED_ACTUAL_CAD.png |
| `previews/PAPER_STANDARD_FINISHED_SEED_ACTUAL_CAD.png` | 63,716 | archive/seedforge-r3-package/previews/PAPER_STANDARD_FINISHED_SEED_ACTUAL_CAD.png |
| `previews/PAPER_STANDARD_FINISHED_SEED_RENDER.png` | 70,291 | archive/seedforge-r3-package/previews/PAPER_STANDARD_FINISHED_SEED_RENDER.png |
| `r3_docs/R3_BUILD_PLAN.md` | 6,286 | archive/seedforge-r3-package/r3_docs/R3_BUILD_PLAN.md |
| `r3_docs/R3_CORE_PIN_MAP.csv` | 1,546 | archive/seedforge-r3-package/r3_docs/R3_CORE_PIN_MAP.csv |
| `r3_docs/R3_CORE_WIRING.png` | 516,497 | archive/seedforge-r3-package/r3_docs/R3_CORE_WIRING.png |
| `r3_docs/R3_CORE_WIRING.svg` | 5,424 | archive/seedforge-r3-package/r3_docs/R3_CORE_WIRING.svg |
| `r3_docs/R3_FILE_MAP.md` | 2,699 | archive/seedforge-r3-package/r3_docs/R3_FILE_MAP.md |
| `r3_docs/R3_MODULE_MAP.csv` | 2,602 | archive/seedforge-r3-package/r3_docs/R3_MODULE_MAP.csv |
| `r3_docs/R3_REAL_WORLD_FEASIBILITY.md` | 4,741 | archive/seedforge-r3-package/r3_docs/R3_REAL_WORLD_FEASIBILITY.md |
| `r3_docs/R3_SOURCES.md` | 1,178 | archive/seedforge-r3-package/r3_docs/R3_SOURCES.md |
| `r3_docs/R3_SYSTEM_ARCHITECTURE.png` | 463,186 | archive/seedforge-r3-package/r3_docs/R3_SYSTEM_ARCHITECTURE.png |
| `r3_docs/R3_SYSTEM_ARCHITECTURE.svg` | 5,081 | archive/seedforge-r3-package/r3_docs/R3_SYSTEM_ARCHITECTURE.svg |
| `r3_docs/R3_WIRING_QUICK_REFERENCE.md` | 3,102 | archive/seedforge-r3-package/r3_docs/R3_WIRING_QUICK_REFERENCE.md |
| `r3_quick_prints/phase1_core/F01_spool_stand_left.3mf` | 12,476 | not carried (duplicate of cad/3mf; release script builds the Phase-1 pack) |
| `r3_quick_prints/phase1_core/F02_spool_stand_right.3mf` | 15,235 | not carried (duplicate of cad/3mf; release script builds the Phase-1 pack) |
| `r3_quick_prints/phase1_core/F03_spool_hub.3mf` | 14,946 | not carried (duplicate of cad/3mf; release script builds the Phase-1 pack) |
| `r3_quick_prints/phase1_core/F04_dancer_arm.3mf` | 10,421 | not carried (duplicate of cad/3mf; release script builds the Phase-1 pack) |
| `r3_quick_prints/phase1_core/F05_dancer_roller.3mf` | 10,404 | not carried (duplicate of cad/3mf; release script builds the Phase-1 pack) |
| `r3_quick_prints/phase1_core/F06_veneer_guide_45deg_lower.3mf` | 5,909 | not carried (duplicate of cad/3mf; release script builds the Phase-1 pack) |
| `r3_quick_prints/phase1_core/F07_veneer_guide_lid.3mf` | 12,566 | not carried (duplicate of cad/3mf; release script builds the Phase-1 pack) |
| `r3_quick_prints/phase1_core/MR03_mandrel_depth_stop_M2.3mf` | 55,011 | not carried (duplicate of cad/3mf; release script builds the Phase-1 pack) |
| `r3_quick_prints/phase1_core/MR04_0p8mm_guide_bushing.3mf` | 13,910 | not carried (duplicate of cad/3mf; release script builds the Phase-1 pack) |
| `r3_quick_prints/phase1_core/PRINT_ORDER.txt` | 467 | not carried (duplicate of cad/3mf; release script builds the Phase-1 pack) |
| `r3_quick_prints/phase1_core/W01_nema17_rotation_mount.3mf` | 26,511 | not carried (duplicate of cad/3mf; release script builds the Phase-1 pack) |
| `r3_quick_prints/phase1_core/W02_608_mandrel_support.3mf` | 14,161 | not carried (duplicate of cad/3mf; release script builds the Phase-1 pack) |
| `r3_quick_prints/phase1_core/W03_lm8uu_linear_carriage.3mf` | 7,744 | not carried (duplicate of cad/3mf; release script builds the Phase-1 pack) |
| `r3_quick_prints/phase1_core/W04_t8_nut_carrier.3mf` | 25,442 | not carried (duplicate of cad/3mf; release script builds the Phase-1 pack) |
| `r3_quick_prints/phase1_core/W05_mandrel_end_guide.3mf` | 10,248 | not carried (duplicate of cad/3mf; release script builds the Phase-1 pack) |
| `r3_quick_prints/phase1_core/W06_camera_tilt_mount.3mf` | 15,702 | not carried (duplicate of cad/3mf; release script builds the Phase-1 pack) |
| `r3_quick_prints/phase1_core/W07_micro_release_clamp_lower.3mf` | 8,818 | not carried (duplicate of cad/3mf; release script builds the Phase-1 pack) |
| `r3_quick_prints/phase1_core/W08_micro_release_clamp_upper.3mf` | 8,750 | not carried (duplicate of cad/3mf; release script builds the Phase-1 pack) |
| `r3_quick_prints/phase1_core/X01_sg90_clamp_mount.3mf` | 13,816 | not carried (duplicate of cad/3mf; release script builds the Phase-1 pack) |
| `r3_quick_prints/phase1_core/X02_soft_clamp_jaw.3mf` | 8,216 | not carried (duplicate of cad/3mf; release script builds the Phase-1 pack) |
| `r3_quick_prints/phase1_core/X03_guarded_shear_mount.3mf` | 10,037 | not carried (duplicate of cad/3mf; release script builds the Phase-1 pack) |
| `r3_quick_prints/phase1_core/X04_cutter_guard.3mf` | 8,954 | not carried (duplicate of cad/3mf; release script builds the Phase-1 pack) |
| `r3_quick_prints/phase1_core/Z01_fit_calibration_coupon.3mf` | 27,580 | not carried (duplicate of cad/3mf; release script builds the Phase-1 pack) |
| `r3_validation/CALIBRATION_WORKSHEET.csv` | 804 | archive/seedforge-r3-package/r3_validation/CALIBRATION_WORKSHEET.csv |
| `r3_validation/RUN_LOG_TEMPLATE.csv` | 135 | archive/seedforge-r3-package/r3_validation/RUN_LOG_TEMPLATE.csv |
| `software/original_eecs149_repo/README.md` | 194 | archive/eecs149-original/ |
| `software/original_eecs149_repo/Stepper.ino` | 536 | archive/eecs149-original/ |
| `software/original_eecs149_repo/ble_uart_connection_script.py` | 2,126 | archive/eecs149-original/ |
| `software/original_eecs149_repo/esp32_bluetooth_low_energy.ino` | 6,014 | archive/eecs149-original/ |
| `software/original_eecs149_repo/ultrasonic.ino` | 423 | archive/eecs149-original/ |
| `software/original_eecs149_repo/winder_automation.ino` | 13,897 | archive/eecs149-original/ |
| `software/r3_controller/PROTOCOL.md` | 1,896 | archive/seedforge-r3-package/software/ (superseded by firmware/ and software/) |
| `software/r3_controller/__pycache__/host_command_example.cpython-313.pyc` | 2,005 | dropped (compiled Python cache) |
| `software/r3_controller/host_command_example.py` | 1,348 | archive/seedforge-r3-package/software/ (superseded by firmware/ and software/) |
| `software/r3_controller/seedforge_r3_core_controller.ino` | 9,635 | archive/seedforge-r3-package/software/ (superseded by firmware/ and software/) |
| `wiring/connection_table.csv` | 7,843 | archive/seedforge-r3-package/wiring/connection_table.csv |
| `wiring/pin_map.csv` | 576 | archive/seedforge-r3-package/wiring/pin_map.csv |
