Normansrule/seedforge/hardware/bom/printed_parts.csv

part_id | file_stem | module | status | qty | material | bbox_x_mm | bbox_y_mm | bbox_z_mm | volume_cm3 | solid_mass_petg_g | cad_valid | source | notes
C01 | C01_module_base_160x120 | C | optional | 7 | PETG | 160.0 | 120.0 | 6.0 | 112.391 | 142.7 | True | R3 STEP + M2 conversion | Seven removable station tiles. Screwing parts straight to plywood is cheaper; use the drilling template. Its M5 slots take an M2 screw with an M2 washer. Common 25 mm M3 grid and four M5 slots. Bolt modules to plywood or 2020 rails.
C02 | C02_cable_clip_dual | C | core | 10 | PETG | 28.0 | 16.0 | 12.0 | 4.29 | 5.4 | True | R3 STEP + M2 conversion | Two small cable channels; use zip ties for strain relief.
C03 | C03_electronics_box | C | core | 1 | PETG | 170.0 | 110.0 | 42.0 | 149.664 | 190.1 | True | R3 STEP + M2 conversion | Holds Uno, ESP32 bridge, A4988s, DC modules, terminal blocks. Keep motor power and logic wiring separated.
C04 | C04_electronics_vented_lid | C | core | 1 | PETG | 170.0 | 110.0 | 3.0 | 52.195 | 66.3 | True | R3 STEP + M2 conversion | Ventilated lid; use M3 screws.
C05 | C05_ili9341_bezel | C | core | 1 | PETG | 84.0 | 64.0 | 5.0 | 14.358 | 18.2 | True | R3 STEP + M2 conversion | Generic 2.2 inch ILI9341 bezel. Verify your PCB outline before final print.
D01 | D01_four_cell_payload_cassette | M10 | upcoming | 1 | PETG | 150.0 | 150.0 | 78.0 | 276.893 | 351.7 | True | R3 STEP + M2 conversion | Four isolated cells prevent tail entanglement. Payload only: use a purchased, flight-tested quadcopter frame.
D02 | D02_single_drop_door | M10 | upcoming | 4 | PETG | 66.0 | 66.0 | 5.0 | 21.64 | 27.5 | True | R3 STEP + M2 conversion | One door per cell. Use 3 mm metal hinge pin and retained metal servo linkage; bench-test fail-closed latch.
D03 | D03_payload_servo_mount | M10 | upcoming | 4 | PETG | 44.0 | 32.0 | 32.0 | 14.679 | 18.6 | True | R3 STEP + M2 conversion | SG90/MG90S mount outside cassette walls.
D04 | D04_payload_rail_adapter | M10 | upcoming | 1 | PETG prototype | 150.0 | 100.0 | 4.0 | 53.693 | 68.2 | True | R3 STEP + M2 conversion | Universal slotted payload plate. Do not use as motor/arm structure. Verify CG and landing gear clearance.
D05 | D05_pi_zero2w_companion_plate | M10 | upcoming | 1 | PETG | 80.0 | 52.0 | 3.0 | 11.962 | 15.2 | True | R3 STEP + M2 conversion | Pi Zero 2 W / small companion plate. Use Pi 5 only if heavier onboard vision is needed.
D06 | D06_downward_camera_mount | M10 | upcoming | 1 | PETG | 52.0 | 40.0 | 32.0 | 19.381 | 24.6 | True | R3 STEP + M2 conversion | Downward camera mount with lens opening; angle/height must be calibrated to ground sampling distance.
F01 | F01_spool_stand_left | M1 | superseded | 1 | PETG | 70.0 | 36.0 | 86.0 | 46.071 | 58.5 | True | R3 STEP + M2 conversion | No 608 bearing bore in the R3 file (its partner F02 has one at z = 65 mm). Use F09. Pair supports a 5 mm axle with 608 bearings; 120 mm maximum spool diameter.
F02 | F02_spool_stand_right | M1 | core | 1 | PETG | 70.0 | 36.0 | 86.0 | 41.43 | 52.6 | True | R3 STEP + M2 conversion | Pair supports a 5 mm axle with 608 bearings; 120 mm maximum spool diameter.
F03 | F03_spool_hub | M1 | superseded | 2 | PETG | 62.0 | 62.0 | 18.0 | 28.774 | 36.5 | True | R3 STEP + M2 conversion | 5.2 mm bore cannot run in 608ZZ bearings (8 mm bore). Use F10 on an 8 mm axle. Two hubs clamp the veneer reel on 5 mm axle. Add felt washers for passive drag.
F04 | F04_dancer_arm | M1 | core | 1 | PETG | 82.0 | 14.0 | 6.0 | 6.03 | 7.7 | True | R3 STEP + M2 conversion | Spring-loaded dancer arm; potentiometer or hall sensor may track position.
F05 | F05_dancer_roller | M1 | core | 2 | PETG | 30.0 | 30.0 | 10.0 | 5.237 | 6.7 | True | R3 STEP + M2 conversion | Use M3 shoulder screw or smooth axle; optionally sleeve with silicone tube.
F06 | F06_veneer_guide_45deg_lower | M1 | core | 1 | PETG+PTFE | 55.0 | 28.0 | 8.0 | 11.263 | 14.3 | True | R3 STEP + M2 conversion | 4.6 x 1.2 mm smooth guide channel. Rotate entire bracket to calibrated winding angle.
F07 | F07_veneer_guide_lid | M1 | core | 1 | PETG | 55.0 | 28.0 | 2.5 | 3.8 | 4.8 | True | R3 STEP + M2 conversion | Light lid for F06; M2 screws, do not pinch strip.
F08 | F08_load_cell_mount | M1 | core | 1 | PETG | 50.0 | 44.0 | 24.4 | 21.366 | 27.1 | True | R3.1 core_cell.py | Channel cradle for the fixed end of a 1 kg bar load cell; clamped by F13 with 4 x M2.
F09 | F09_spool_stand_left_608_bore | M1 | core | 1 | PETG | 70.0 | 36.0 | 86.0 | 42.744 | 54.3 | True | derived from R3 STEP in core_cell.py | Supersedes R3 F01 (which had no bearing bore). Derived from the R3 F01 STEP.
F10 | F10_spool_hub_8mm_bore | M1 | core | 2 | PETG | 62.0 | 62.0 | 18.0 | 28.584 | 36.3 | True | derived from R3 STEP in core_cell.py | Supersedes R3 F03 (5.2 mm bore) for an 8 mm axle in 608ZZ bearings. Derived from the R3 F03 STEP.
F11 | F11_dancer_pivot_post | M1 | core | 1 | PETG | 50.0 | 40.0 | 70.0 | 15.7 | 19.9 | True | R3.1 core_cell.py | Pivot post for F04: 10k pot bushing is the pivot (A0 dancer angle). MEASURE pot bushing.
F12 | F12_sensing_roller_yoke | M1 | core | 1 | PETG | 14.0 | 19.0 | 28.7 | 3.18 | 4.0 | True | R3.1 core_cell.py | Slides over the load-cell free end; 2 x MR62ZZ on an M2 axle form the tension-sensing roller.
F13 | F13_load_cell_clamp_cap | M1 | core | 1 | PETG | 30.0 | 24.0 | 4.0 | 2.804 | 3.6 | True | R3.1 core_cell.py | Cap that clamps the load cell into F08 (0.3 mm preload) with 4 x M2.
O01 | O01_finished_seedpod_tray_12 | M8 | upcoming | 2 | PETG | 160.0 | 120.0 | 14.0 | 120.191 | 152.6 | True | R3 STEP + M2 conversion | Twelve isolated finished-carrier nests. Increase pocket diameter after measuring dry carrier envelope.
Q01 | Q01_free_dry_tray | M5 | upcoming | 4 | PETG+PTFE liner | 160.0 | 120.0 | 10.0 | 88.211 | 112.0 | True | R3 STEP + M2 conversion | Free-dry tray: no clamps on wet wood. Use PTFE/silicone mesh liner and room-temperature airflow.
Q02 | Q02_120mm_usb_fan_bracket | M5 | upcoming | 1 | PETG | 130.0 | 28.0 | 30.0 | 35.524 | 45.1 | True | R3 STEP + M2 conversion | Holds a standard 120 mm USB fan above/beside trays. No heater required for R1.
Q03 | Q03_camera_led_ring_plate | M7 | superseded | 1 | PETG | 78.0 | 62.0 | 6.0 | 19.108 | 24.3 | True | R3 STEP + M2 conversion | LED ring plate; silhouette QA uses the back-light under the mandrel instead. Camera/LED ring plate for consistent defect-imaging illumination. Adapt center aperture to camera lens.
R01 | R01_gantry_tool_plate | M9 | upcoming | 1 | PETG | 80.0 | 60.0 | 6.0 | 27.696 | 35.2 | True | R3 STEP + M2 conversion | Universal plate for low-cost XY gantry or recycled 3D-printer carriage.
R02 | R02_sg90_gripper_body | M9 | upcoming | 1 | PETG | 64.0 | 42.0 | 24.0 | 57.521 | 73.1 | True | R3 STEP + M2 conversion | SG90/MG90S body for transfer gripper. Grip only inactive tab/fixture, never squeeze active coil.
R03 | R03_soft_gripper_finger | M9 | upcoming | 2 | PETG+silicone | 58.0 | 12.0 | 18.0 | 6.914 | 8.8 | True | R3 STEP + M2 conversion | Pair of padded fingers for inactive handling tab or transfer fixture.
R04 | R04_vwheel_or_mgn12_carriage_adapter | M9 | upcoming | 1 | PETG | 72.0 | 56.0 | 8.0 | 30.383 | 38.6 | True | R3 STEP + M2 conversion | Generic adapter to a recycled Ender-style V-wheel carriage or MGN12 block.
R05 | R05_gt2_nema17_corner_mount | M9 | upcoming | 2 | PETG | 70.0 | 46.0 | 64.0 | 39.538 | 50.2 | True | R3 STEP + M2 conversion | Corner motor mount for optional XY transfer gantry. Use 2020 extrusion and GT2 belt; two motors if no donor printer.
R06 | R06_gt2_idler_corner_mount | M9 | upcoming | 2 | PETG | 58.0 | 44.0 | 38.0 | 29.938 | 38.0 | True | R3 STEP + M2 conversion | Adjustable idler mount for 5 mm bore GT2 idler. Tighten only enough to remove belt slack.
R07 | R07_xy_tool_carriage | M9 | upcoming | 1 | PETG | 86.0 | 64.0 | 8.0 | 42.342 | 53.8 | True | R3 STEP + M2 conversion | Tool carriage accepts R01. Adapt to V-wheel or MGN12 donor hardware.
R08 | R08_z_lift_servo_mount | M9 | upcoming | 1 | PETG | 54.0 | 36.0 | 40.0 | 24.222 | 30.8 | True | R3 STEP + M2 conversion | SG90/MG90S Z-lift mount for approximately 15-20 mm pickup travel. Keep end effector light.
S01 | S01_seed_hopper | M6 | needs repair | 1 | PETG | 95.0 | 95.0 | 98.0 | 180.159 | 228.8 | True | R3 STEP + M2 conversion | R3 STEP has two disconnected bodies (funnel not fused to the housing): repair in CAD before printing. Species-specific low-cost gravity hopper. Use only dry seeds; pocket disk below throat meters one seed.
S02 | S02_seed_singulator_disk_6mm | M6 | upcoming | 1 | PETG | 72.0 | 72.0 | 5.0 | 19.023 | 24.2 | True | R3 STEP + M2 conversion | Six 6.8 mm pockets over 180 degrees for a 28BYJ-48 indexing mechanism. Regenerate pocket size per seed species.
S03 | S03_28byj_seed_indexer_mount | M6 | upcoming | 1 | PETG | 68.0 | 56.0 | 42.0 | 42.482 | 54.0 | True | R3 STEP + M2 conversion | Mounts 28BYJ-48 below singulator disk; use metal M3 standoffs if needed.
S04 | S04_three_tail_assembly_nest | M6 | upcoming | 1 | PETG+silicone | 116.0 | 116.0 | 8.0 | 80.576 | 102.3 | True | R3 STEP + M2 conversion | Three 120 degree tail channels around central tip cavity. Use soft inserts where body contacts fixture.
S05 | S05_10ml_syringe_holder | M6 | upcoming | 1 | PETG | 72.0 | 52.0 | 28.0 | 76.471 | 97.1 | True | R3 STEP + M2 conversion | Nominal 20-21 mm syringe barrel. Measure syringe before final print.
S06 | S06_syringe_plunger_carriage | M6 | upcoming | 1 | PETG | 48.0 | 30.0 | 16.0 | 20.714 | 26.3 | True | R3 STEP + M2 conversion | M5 threaded-rod plunger carriage driven by 28BYJ-48. Add current/time limit to prevent overpressure.
S07 | S07_tip_mold_half_A | M6 | experimental | 2 | PETG mold master / silicone working insert | 72.0 | 48.0 | 14.0 | 43.651 | 55.4 | True | R3 STEP + M2 conversion | Mold MASTER for a compliant working insert; validate paste, release and seed viability. Two identical mold masters; clamp face-to-face around the seed/tail junction. Validate paste, release and seed viability; do not heat live seed.
S08 | S08_tip_mold_half_B | M6 | experimental | 2 | PETG mold master / silicone working insert | 72.0 | 48.0 | 14.0 | 43.651 | 55.4 | True | R3 STEP + M2 conversion | Mold MASTER for a compliant working insert. Two identical mold masters; clamp face-to-face around the seed/tail junction. Validate paste, release and seed viability; do not heat live seed.
T01 | T01_tail_former_left | M4 | upcoming | 2 | PETG | 23.8 | 44.0 | 8.8 | 4.253 | 5.4 | True | R3 STEP + M2 conversion | Split wet-forming mandrel, 14 mm radius, 4.8 mm channel. Experimental geometry.
T02 | T02_tail_former_right | M4 | upcoming | 2 | PETG | 23.8 | 44.0 | 8.8 | 4.253 | 5.4 | True | R3 STEP + M2 conversion | Mate with T01. Split enables wet release without dragging over an undercut.
T03 | T03_tail_sweep_shoe | M4 | needs repair | 1 | PETG+PTFE | 43.59 | 31.0 | 5.0 | 2.657 | 3.4 | True | R3 STEP + M2 conversion | R3 STEP has two disconnected bodies (servo tab 2 mm away from the arc shoe): add a bridge before printing. Servo-driven smooth sweep shoe. Line strip-contact surface with PTFE tape.
T04 | T04_tail_blank_clamp | M4 | upcoming | 2 | PETG+silicone | 46.0 | 22.0 | 24.0 | 9.279 | 11.8 | True | R3 STEP + M2 conversion | Light clamp for auxiliary tail blank during forming.
W01 | W01_nema17_rotation_mount | M2 | core | 1 | PETG | 66.0 | 66.0 | 66.0 | 58.088 | 73.8 | True | R3 STEP + M2 conversion | NEMA17 face mount; use purchased flexible coupler + small collet/pin vise for 0.8 mm mandrel.
W02 | W02_608_mandrel_support | M2 | optional | 1 | PETG | 56.0 | 32.0 | 42.0 | 32.698 | 41.5 | True | R3 STEP + M2 conversion | 608 bore at 25.0 mm vs the 37.0 mm W01 axis: needs a 12 mm riser. Not used in the R3.1 core cell (mini chuck mounts on the motor shaft). 608 bearing support for driven chuck/shaft; mandrel itself is metal, not printed.
W03 | W03_lm8uu_linear_carriage | M2 | superseded | 1 | PETG | 90.0 | 70.0 | 30.0 | 75.803 | 96.3 | True | R3 STEP + M2 conversion | R3 note says two LM8UU bores 56 mm apart, but the solid has none. Use W11. Two 15.4 mm LM8UU bores, 56 mm apart. Clamp bearings with zip ties through slots.
W04 | W04_t8_nut_carrier | M2 | superseded | 1 | PETG | 50.0 | 42.0 | 28.0 | 29.138 | 37.0 | True | R3 STEP + M2 conversion | T8 flange-nut mount is integrated in W11. Kept for reference. Fits common flange T8 anti-backlash nut. Confirm your nut hole pattern; ream if needed.
W05 | W05_mandrel_end_guide | M2 | core | 1 | PETG | 42.0 | 36.0 | 40.0 | 15.828 | 20.1 | True | R3 STEP + M2 conversion | 2.2 mm bore accepts a short brass/PTFE guide tube around the steel mandrel.
W06 | W06_camera_tilt_mount | M7 | superseded | 1 | PETG | 58.0 | 42.0 | 40.0 | 25.926 | 32.9 | True | R3 STEP + M2 conversion | Camera tilt mount for the R3 camera; the budget USB board camera mounts on W18. Adjustable RealSense/USB camera adapter mount; add camera-specific plate with M3 slots.
W07 | W07_micro_release_clamp_lower | M3 | experimental | 1 | PETG+silicone | 34.0 | 12.0 | 26.0 | 5.046 | 6.4 | True | R3 STEP + M2 conversion | Split demold support. Pocket axis at 17 mm: needs a 20 mm riser or a carriage mount (Phase 2). Split demold collar. Tune the silicone-lined opening to the measured wet coil OD; closes lightly while mandrel retracts.
W08 | W08_micro_release_clamp_upper | M3 | experimental | 1 | PETG+silicone | 34.0 | 12.0 | 26.0 | 5.046 | 6.4 | True | R3 STEP + M2 conversion | Mate of W07 (Phase 2). Mate W07. This is a fit-test mechanism; wet demolding must be validated before unattended operation.
W09 | W09_linear_motor_end_block | M2 | core | 1 | PETG | 28.0 | 78.0 | 48.0 | 56.82 | 72.2 | True | R3.1 core_cell.py | Rod sockets + NEMA17 boss register for the traverse axis (motor held by W16). Print on its base, 40% infill, 4 walls.
W10 | W10_linear_idler_end_block | M2 | core | 1 | PETG | 28.0 | 78.0 | 48.0 | 59.645 | 75.7 | True | R3.1 core_cell.py | Rod sockets + 608ZZ pocket supporting the free end of the T8x8 screw.
W11 | W11_lm8uu_traverse_carriage | M2 | core | 1 | PETG | 40.0 | 77.2 | 22.6 | 51.529 | 65.4 | True | R3.1 core_cell.py | Two LM8UU bores (15.2 mm, tune with Z01) + T8 flange-nut mount (16 mm PCD). Print standing on the -x face.
W12 | W12_angle_adjustable_guide_arm | M1/M2 | core | 1 | PETG | 157.13 | 76.6 | 14.25 | 30.17 | 38.3 | True | R3.1 core_cell.py | Carries F06/F07. Concentric arc slots centred on the mandrel contact point give +/-60 deg of guide angle with 5 deg index marks.
W13 | W13_w05_axis_riser_11mm | M2 | core | 1 | PETG | 42.0 | 36.0 | 11.0 | 16.225 | 20.6 | True | R3.1 core_cell.py | Lifts retained W05 end guide to the 37.0 mm mandrel axis.
W14 | W14_limit_switch_rod_clamp | M2 | core | 2 | PETG | 10.0 | 40.5 | 21.5 | 3.549 | 4.5 | True | R3.1 core_cell.py | Home and end microswitch clamp on the outer 8 mm rod; slide to set trip points (home: carriage x 45 mm).
W15 | W15_nema17_body_clamp_rotation | M2 | core | 1 | PETG | 28.0 | 70.6 | 69.3 | 41.941 | 53.3 | True | R3.1 core_cell.py | Split collar holding the rotation NEMA17 body (axis 37 mm); 2 x M2 pinch, 4 x M2 wood screws. Print on the -x face, 4 walls.
W16 | W16_nema17_body_clamp_linear | M2 | core | 1 | PETG | 28.0 | 70.6 | 54.3 | 20.689 | 26.3 | True | R3.1 core_cell.py | Split collar holding the traverse NEMA17 body (axis 22 mm, 0.7 mm floor rests on the plywood). Print on the -x face, 4 walls.
W17 | W17_camera_mast_foot | M7 | core | 1 | PETG | 40.0 | 24.0 | 40.0 | 9.451 | 12.0 | True | R3.1 core_cell.py | Foot bracket for the 30 x 18 mm plywood camera mast; M2 wood screws.
W18 | W18_camera_arm | M7 | core | 1 | PETG | 42.0 | 83.0 | 62.0 | 19.836 | 25.2 | True | R3.1 core_cell.py | Arm from the mast top holding a 38 x 38 mm USB board camera (4 x M2, 34 mm pattern - MEASURE) over the coil. Print on the mast-side face.
X01 | X01_sg90_clamp_mount | M3 | core | 1 | PETG | 68.0 | 44.0 | 32.0 | 32.705 | 41.5 | True | R3 STEP + M2 conversion | SG90/MG90S-class clamp bracket; verify exact servo body dimensions.
X02 | X02_soft_clamp_jaw | M3 | core | 2 | PETG+silicone | 34.0 | 13.0 | 12.0 | 3.781 | 4.8 | True | R3 STEP + M2 conversion | Bond 1 mm silicone pad to jaw. Clamp sacrificial tail/handling tab, not active coils.
X03 | X03_guarded_shear_mount | M3 | core | 1 | PETG | 88.0 | 58.0 | 41.0 | 53.168 | 67.5 | True | R3 STEP + M2 conversion | Universal mount for purchased spring-return micro shear. Do not print the blade.
X04 | X04_cutter_guard | M3 | core | 1 | PETG prototype / polycarbonate final | 96.0 | 66.0 | 44.0 | 73.921 | 93.9 | True | R3 STEP + M2 conversion | Bench guard shell. Production guard should be transparent impact-rated polycarbonate with interlock.
Z01 | Z01_fit_calibration_coupon | Z | core | 1 | PETG | 110.0 | 55.0 | 5.0 | 28.142 | 35.7 | True | R3 STEP + M2 conversion | Hole sizes for M2/M3/M4/M5, 8 mm rod and LM8UU; channel widths for wet veneer. Print before the rest of the system.
