Normansrule/seedforge/validation/CALIBRATION_WORKSHEET.csv

section | id | quantity | unit | target_or_expected | measured_1 | measured_2 | measured_3 | pass | date | operator | commit | notes
header | H1 | machine_id
header | H2 | firmware_version |  | 0.3.0-alpha
header | H3 | material_lot
printer | C1 | Z01 M3 clearance hole fit |  | M3 screw passes freely
printer | C1 | Z01 8 mm rod socket fit |  | light press
printer | C1 | Z01 LM8UU bore fit |  | slip fit
printer | C1 | Z01 608 pocket fit |  | press fit
drivers | C2 | A4988 rotation Rs | ohm | read resistor
drivers | C2 | A4988 rotation Vref | V | I x 8 x Rs
drivers | C2 | A4988 linear Rs | ohm | read resistor
drivers | C2 | A4988 linear Vref | V | I x 8 x Rs
motion | C3 | rotation direction correct |  | yes |  |  |  |  |  |  |  | SET_DIR bit 0 if inverted
motion | C3 | linear direction correct (JOG + moves away from home) |  | yes |  |  |  |  |  |  |  | SET_DIR bit 1 if inverted
motion | C4 | home repeatability spread (10 homes) | mm | <= 0.05
motion | C5 | translation JOG=50 forward | mm | 50.00 +- 0.05
motion | C5 | translation JOG=-50 return | mm | 0.00 +- 0.05
motion | C6 | rotation 10-turn count | turns | 10 exactly
motion | C6 | rotation stop angle error | deg | < 2
motion | C6 | rotation at 2x recipe rate | turns | 10 exactly
mandrel | C7 | mandrel diameter | mm | 0.80
mandrel | C7 | mandrel straightness (roll on glass) |  | no visible gap
mandrel | C7 | runout at free end | mm | record
mandrel | C7 | deflection at winding position 10 g | mm | record
mandrel | C7 | deflection at winding position 25 g | mm | record
mandrel | C7 | deflection at winding position 50 g | mm | record
tension | C8 | calibration mass 1 | g
tension | C8 | reading with mass 1 | N | mass x 9.81e-3
tension | C8 | reading with mass 2 | N | mass x 9.81e-3
tension | C8 | reading with mass 3 | N | mass x 9.81e-3
tension | C8 | tare/cal repeatability (3 cycles) | % | < 5
tension | C9 | spool drag setting |  | record
tension | C9 | dancer raw at working tension | counts | record
guide | C10 | W12 scale vs protractor at 0 deg | deg | +-1
guide | C10 | W12 scale vs protractor at 45 deg | deg | +-1
guide | C10 | W12 scale vs protractor at 50.8 deg | deg | +-1
camera | C11 | px_per_mm centre | px/mm | >= 40
camera | C11 | px_per_mm left vs right difference | % | < 1
camera | C12 | background level / threshold separation |  | clean Otsu split
material | P0 | wet width | mm
material | P0 | wet thickness | mm
material | P0 | dry width | mm
material | P0 | dry thickness | mm
material | P0 | damage tension | N |  |  |  |  |  |  |  |  | first visible crack/split/permanent set
material | P0 | break tension | N
material | P0 | chosen SET_TENSION_MAX | N | well below damage tension
material | P0 | chosen SET_TENSION_MIN | N
pitch | C13 | commanded pitch | mm/rev
pitch | C13 | guide angle set | deg
pitch | C13 | measured pitch (coil length / turns) | mm/rev | within recipe tolerance
pitch | C13 | measured max gap | mm
pitch | C13 | measured max overlap | mm
vibration | C14 | RMS at 10 rev/min | mg | record
vibration | C14 | RMS at 30 rev/min | mg | record
vibration | C14 | RMS at 60 rev/min | mg | record
