Normansrule/seedforge/hardware/cad/manifest.csv

part_id | file_stem | family | module | status | source | qty | material | bbox_x_mm | bbox_y_mm | bbox_z_mm | volume_cm3 | watertight | winding_consistent | bodies | fits_a1_mini | solid_mass_petg_g | step | stl | 3mf | cad_valid | print_successful | physically_fits | mechanism_works | process_validated | notes
C01 | C01_module_base_160x120 | machine | C | optional | R3 STEP + M2 conversion | 7 | PETG | 160.0 | 120.0 | 6.0 | 112.391 | True | True | 1 | True | 142.7 | step/machine/C01_module_base_160x120.step | stl/machine/C01_module_base_160x120.stl | 3mf/machine/C01_module_base_160x120.3mf | True | not recorded | not tested | not tested | no | Seven removable station tiles. Screwing parts straight to plywood is cheaper; use the drilling template. Its M5 slots take an M2 screw with an M2 washer. Common 25 mm M3 grid and four M5 slots. Bolt modules to plywood or 2020 rails.
C02 | C02_cable_clip_dual | machine | C | core | R3 STEP + M2 conversion | 10 | PETG | 28.0 | 16.0 | 12.0 | 4.29 | True | True | 1 | True | 5.4 | step/machine/C02_cable_clip_dual.step | stl/machine/C02_cable_clip_dual.stl | 3mf/machine/C02_cable_clip_dual.3mf | True | not recorded | not tested | not tested | no | Two small cable channels; use zip ties for strain relief.
C03 | C03_electronics_box | machine | C | core | R3 STEP + M2 conversion | 1 | PETG | 170.0 | 110.0 | 42.0 | 149.664 | True | True | 1 | True | 190.1 | step/machine/C03_electronics_box.step | stl/machine/C03_electronics_box.stl | 3mf/machine/C03_electronics_box.3mf | True | not recorded | not tested | not tested | no | Holds Uno, ESP32 bridge, A4988s, DC modules, terminal blocks. Keep motor power and logic wiring separated.
C04 | C04_electronics_vented_lid | machine | C | core | R3 STEP + M2 conversion | 1 | PETG | 170.0 | 110.0 | 3.0 | 52.195 | True | True | 1 | True | 66.3 | step/machine/C04_electronics_vented_lid.step | stl/machine/C04_electronics_vented_lid.stl | 3mf/machine/C04_electronics_vented_lid.3mf | True | not recorded | not tested | not tested | no | Ventilated lid; use M3 screws.
C05 | C05_ili9341_bezel | machine | C | core | R3 STEP + M2 conversion | 1 | PETG | 84.0 | 64.0 | 5.0 | 14.358 | True | True | 1 | True | 18.2 | step/machine/C05_ili9341_bezel.step | stl/machine/C05_ili9341_bezel.stl | 3mf/machine/C05_ili9341_bezel.3mf | True | not recorded | not tested | not tested | no | Generic 2.2 inch ILI9341 bezel. Verify your PCB outline before final print.
D01 | D01_four_cell_payload_cassette | machine | M10 | upcoming | R3 STEP + M2 conversion | 1 | PETG | 150.0 | 150.0 | 78.0 | 276.893 | True | True | 1 | True | 351.7 | step/machine/D01_four_cell_payload_cassette.step | stl/machine/D01_four_cell_payload_cassette.stl | 3mf/machine/D01_four_cell_payload_cassette.3mf | True | not recorded | not tested | not tested | no | Four isolated cells prevent tail entanglement. Payload only: use a purchased, flight-tested quadcopter frame.
D02 | D02_single_drop_door | machine | M10 | upcoming | R3 STEP + M2 conversion | 4 | PETG | 66.0 | 66.0 | 5.0 | 21.64 | True | True | 1 | True | 27.5 | step/machine/D02_single_drop_door.step | stl/machine/D02_single_drop_door.stl | 3mf/machine/D02_single_drop_door.3mf | True | not recorded | not tested | not tested | no | One door per cell. Use 3 mm metal hinge pin and retained metal servo linkage; bench-test fail-closed latch.
D03 | D03_payload_servo_mount | machine | M10 | upcoming | R3 STEP + M2 conversion | 4 | PETG | 44.0 | 32.0 | 32.0 | 14.679 | True | True | 1 | True | 18.6 | step/machine/D03_payload_servo_mount.step | stl/machine/D03_payload_servo_mount.stl | 3mf/machine/D03_payload_servo_mount.3mf | True | not recorded | not tested | not tested | no | SG90/MG90S mount outside cassette walls.
D04 | D04_payload_rail_adapter | machine | M10 | upcoming | R3 STEP + M2 conversion | 1 | PETG prototype | 150.0 | 100.0 | 4.0 | 53.693 | True | True | 1 | True | 68.2 | step/machine/D04_payload_rail_adapter.step | stl/machine/D04_payload_rail_adapter.stl | 3mf/machine/D04_payload_rail_adapter.3mf | True | not recorded | not tested | not tested | no | Universal slotted payload plate. Do not use as motor/arm structure. Verify CG and landing gear clearance.
D05 | D05_pi_zero2w_companion_plate | machine | M10 | upcoming | R3 STEP + M2 conversion | 1 | PETG | 80.0 | 52.0 | 3.0 | 11.962 | True | True | 1 | True | 15.2 | step/machine/D05_pi_zero2w_companion_plate.step | stl/machine/D05_pi_zero2w_companion_plate.stl | 3mf/machine/D05_pi_zero2w_companion_plate.3mf | True | not recorded | not tested | not tested | no | Pi Zero 2 W / small companion plate. Use Pi 5 only if heavier onboard vision is needed.
D06 | D06_downward_camera_mount | machine | M10 | upcoming | R3 STEP + M2 conversion | 1 | PETG | 52.0 | 40.0 | 32.0 | 19.381 | True | True | 1 | True | 24.6 | step/machine/D06_downward_camera_mount.step | stl/machine/D06_downward_camera_mount.stl | 3mf/machine/D06_downward_camera_mount.3mf | True | not recorded | not tested | not tested | no | Downward camera mount with lens opening; angle/height must be calibrated to ground sampling distance.
F01 | F01_spool_stand_left | machine | M1 | superseded | R3 STEP + M2 conversion | 1 | PETG | 70.0 | 36.0 | 86.0 | 46.071 | True | True | 1 | True | 58.5 | step/machine/F01_spool_stand_left.step | stl/machine/F01_spool_stand_left.stl | 3mf/machine/F01_spool_stand_left.3mf | True | not recorded | not tested | not tested | no | No 608 bearing bore in the R3 file (its partner F02 has one at z = 65 mm). Use F09. Pair supports a 5 mm axle with 608 bearings; 120 mm maximum spool diameter.
F02 | F02_spool_stand_right | machine | M1 | core | R3 STEP + M2 conversion | 1 | PETG | 70.0 | 36.0 | 86.0 | 41.43 | True | True | 1 | True | 52.6 | step/machine/F02_spool_stand_right.step | stl/machine/F02_spool_stand_right.stl | 3mf/machine/F02_spool_stand_right.3mf | True | not recorded | not tested | not tested | no | Pair supports a 5 mm axle with 608 bearings; 120 mm maximum spool diameter.
F03 | F03_spool_hub | machine | M1 | superseded | R3 STEP + M2 conversion | 2 | PETG | 62.0 | 62.0 | 18.0 | 28.774 | True | True | 1 | True | 36.5 | step/machine/F03_spool_hub.step | stl/machine/F03_spool_hub.stl | 3mf/machine/F03_spool_hub.3mf | True | not recorded | not tested | not tested | no | 5.2 mm bore cannot run in 608ZZ bearings (8 mm bore). Use F10 on an 8 mm axle. Two hubs clamp the veneer reel on 5 mm axle. Add felt washers for passive drag.
F04 | F04_dancer_arm | machine | M1 | core | R3 STEP + M2 conversion | 1 | PETG | 82.0 | 14.0 | 6.0 | 6.03 | True | True | 1 | True | 7.7 | step/machine/F04_dancer_arm.step | stl/machine/F04_dancer_arm.stl | 3mf/machine/F04_dancer_arm.3mf | True | not recorded | not tested | not tested | no | Spring-loaded dancer arm; potentiometer or hall sensor may track position.
F05 | F05_dancer_roller | machine | M1 | core | R3 STEP + M2 conversion | 2 | PETG | 30.0 | 30.0 | 10.0 | 5.237 | True | True | 1 | True | 6.7 | step/machine/F05_dancer_roller.step | stl/machine/F05_dancer_roller.stl | 3mf/machine/F05_dancer_roller.3mf | True | not recorded | not tested | not tested | no | Use M3 shoulder screw or smooth axle; optionally sleeve with silicone tube.
F06 | F06_veneer_guide_45deg_lower | machine | M1 | core | R3 STEP + M2 conversion | 1 | PETG+PTFE | 55.0 | 28.0 | 8.0 | 11.263 | True | True | 1 | True | 14.3 | step/machine/F06_veneer_guide_45deg_lower.step | stl/machine/F06_veneer_guide_45deg_lower.stl | 3mf/machine/F06_veneer_guide_45deg_lower.3mf | True | not recorded | not tested | not tested | no | 4.6 x 1.2 mm smooth guide channel. Rotate entire bracket to calibrated winding angle.
F07 | F07_veneer_guide_lid | machine | M1 | core | R3 STEP + M2 conversion | 1 | PETG | 55.0 | 28.0 | 2.5 | 3.8 | True | True | 1 | True | 4.8 | step/machine/F07_veneer_guide_lid.step | stl/machine/F07_veneer_guide_lid.stl | 3mf/machine/F07_veneer_guide_lid.3mf | True | not recorded | not tested | not tested | no | Light lid for F06; M2 screws, do not pinch strip.
F08 | F08_load_cell_mount | machine | M1 | core | R3.1 core_cell.py | 1 | PETG | 50.0 | 44.0 | 24.4 | 21.366 | True | True | 1 | True | 27.1 | step/machine/F08_load_cell_mount.step | stl/machine/F08_load_cell_mount.stl | 3mf/machine/F08_load_cell_mount.3mf | True | not recorded | not tested | not tested | no | Channel cradle for the fixed end of a 1 kg bar load cell; clamped by F13 with 4 x M2.
F09 | F09_spool_stand_left_608_bore | machine | M1 | core | derived from R3 STEP in core_cell.py | 1 | PETG | 70.0 | 36.0 | 86.0 | 42.744 | True | True | 1 | True | 54.3 | step/machine/F09_spool_stand_left_608_bore.step | stl/machine/F09_spool_stand_left_608_bore.stl | 3mf/machine/F09_spool_stand_left_608_bore.3mf | True | not recorded | not tested | not tested | no | Supersedes R3 F01 (which had no bearing bore). Derived from the R3 F01 STEP.
F10 | F10_spool_hub_8mm_bore | machine | M1 | core | derived from R3 STEP in core_cell.py | 2 | PETG | 62.0 | 62.0 | 18.0 | 28.584 | True | True | 1 | True | 36.3 | step/machine/F10_spool_hub_8mm_bore.step | stl/machine/F10_spool_hub_8mm_bore.stl | 3mf/machine/F10_spool_hub_8mm_bore.3mf | True | not recorded | not tested | not tested | no | Supersedes R3 F03 (5.2 mm bore) for an 8 mm axle in 608ZZ bearings. Derived from the R3 F03 STEP.
F11 | F11_dancer_pivot_post | machine | M1 | core | R3.1 core_cell.py | 1 | PETG | 50.0 | 40.0 | 70.0 | 15.7 | True | True | 1 | True | 19.9 | step/machine/F11_dancer_pivot_post.step | stl/machine/F11_dancer_pivot_post.stl | 3mf/machine/F11_dancer_pivot_post.3mf | True | not recorded | not tested | not tested | no | Pivot post for F04: 10k pot bushing is the pivot (A0 dancer angle). MEASURE pot bushing.
F12 | F12_sensing_roller_yoke | machine | M1 | core | R3.1 core_cell.py | 1 | PETG | 14.0 | 19.0 | 28.7 | 3.18 | True | True | 1 | True | 4.0 | step/machine/F12_sensing_roller_yoke.step | stl/machine/F12_sensing_roller_yoke.stl | 3mf/machine/F12_sensing_roller_yoke.3mf | True | not recorded | not tested | not tested | no | Slides over the load-cell free end; 2 x MR62ZZ on an M2 axle form the tension-sensing roller.
F13 | F13_load_cell_clamp_cap | machine | M1 | core | R3.1 core_cell.py | 1 | PETG | 30.0 | 24.0 | 4.0 | 2.804 | True | True | 1 | True | 3.6 | step/machine/F13_load_cell_clamp_cap.step | stl/machine/F13_load_cell_clamp_cap.stl | 3mf/machine/F13_load_cell_clamp_cap.3mf | True | not recorded | not tested | not tested | no | Cap that clamps the load cell into F08 (0.3 mm preload) with 4 x M2.
O01 | O01_finished_seedpod_tray_12 | machine | M8 | upcoming | R3 STEP + M2 conversion | 2 | PETG | 160.0 | 120.0 | 14.0 | 120.191 | True | True | 1 | True | 152.6 | step/machine/O01_finished_seedpod_tray_12.step | stl/machine/O01_finished_seedpod_tray_12.stl | 3mf/machine/O01_finished_seedpod_tray_12.3mf | True | not recorded | not tested | not tested | no | Twelve isolated finished-carrier nests. Increase pocket diameter after measuring dry carrier envelope.
Q01 | Q01_free_dry_tray | machine | M5 | upcoming | R3 STEP + M2 conversion | 4 | PETG+PTFE liner | 160.0 | 120.0 | 10.0 | 88.211 | True | True | 1 | True | 112.0 | step/machine/Q01_free_dry_tray.step | stl/machine/Q01_free_dry_tray.stl | 3mf/machine/Q01_free_dry_tray.3mf | True | not recorded | not tested | not tested | no | Free-dry tray: no clamps on wet wood. Use PTFE/silicone mesh liner and room-temperature airflow.
Q02 | Q02_120mm_usb_fan_bracket | machine | M5 | upcoming | R3 STEP + M2 conversion | 1 | PETG | 130.0 | 28.0 | 30.0 | 35.524 | True | True | 1 | True | 45.1 | step/machine/Q02_120mm_usb_fan_bracket.step | stl/machine/Q02_120mm_usb_fan_bracket.stl | 3mf/machine/Q02_120mm_usb_fan_bracket.3mf | True | not recorded | not tested | not tested | no | Holds a standard 120 mm USB fan above/beside trays. No heater required for R1.
Q03 | Q03_camera_led_ring_plate | machine | M7 | superseded | R3 STEP + M2 conversion | 1 | PETG | 78.0 | 62.0 | 6.0 | 19.108 | True | True | 1 | True | 24.3 | step/machine/Q03_camera_led_ring_plate.step | stl/machine/Q03_camera_led_ring_plate.stl | 3mf/machine/Q03_camera_led_ring_plate.3mf | True | not recorded | not tested | not tested | no | LED ring plate; silhouette QA uses the back-light under the mandrel instead. Camera/LED ring plate for consistent defect-imaging illumination. Adapt center aperture to camera lens.
R01 | R01_gantry_tool_plate | machine | M9 | upcoming | R3 STEP + M2 conversion | 1 | PETG | 80.0 | 60.0 | 6.0 | 27.696 | True | True | 1 | True | 35.2 | step/machine/R01_gantry_tool_plate.step | stl/machine/R01_gantry_tool_plate.stl | 3mf/machine/R01_gantry_tool_plate.3mf | True | not recorded | not tested | not tested | no | Universal plate for low-cost XY gantry or recycled 3D-printer carriage.
R02 | R02_sg90_gripper_body | machine | M9 | upcoming | R3 STEP + M2 conversion | 1 | PETG | 64.0 | 42.0 | 24.0 | 57.521 | True | True | 1 | True | 73.1 | step/machine/R02_sg90_gripper_body.step | stl/machine/R02_sg90_gripper_body.stl | 3mf/machine/R02_sg90_gripper_body.3mf | True | not recorded | not tested | not tested | no | SG90/MG90S body for transfer gripper. Grip only inactive tab/fixture, never squeeze active coil.
R03 | R03_soft_gripper_finger | machine | M9 | upcoming | R3 STEP + M2 conversion | 2 | PETG+silicone | 58.0 | 12.0 | 18.0 | 6.914 | True | True | 1 | True | 8.8 | step/machine/R03_soft_gripper_finger.step | stl/machine/R03_soft_gripper_finger.stl | 3mf/machine/R03_soft_gripper_finger.3mf | True | not recorded | not tested | not tested | no | Pair of padded fingers for inactive handling tab or transfer fixture.
R04 | R04_vwheel_or_mgn12_carriage_adapter | machine | M9 | upcoming | R3 STEP + M2 conversion | 1 | PETG | 72.0 | 56.0 | 8.0 | 30.383 | True | True | 1 | True | 38.6 | step/machine/R04_vwheel_or_mgn12_carriage_adapter.step | stl/machine/R04_vwheel_or_mgn12_carriage_adapter.stl | 3mf/machine/R04_vwheel_or_mgn12_carriage_adapter.3mf | True | not recorded | not tested | not tested | no | Generic adapter to a recycled Ender-style V-wheel carriage or MGN12 block.
R05 | R05_gt2_nema17_corner_mount | machine | M9 | upcoming | R3 STEP + M2 conversion | 2 | PETG | 70.0 | 46.0 | 64.0 | 39.538 | True | True | 1 | True | 50.2 | step/machine/R05_gt2_nema17_corner_mount.step | stl/machine/R05_gt2_nema17_corner_mount.stl | 3mf/machine/R05_gt2_nema17_corner_mount.3mf | True | not recorded | not tested | not tested | no | Corner motor mount for optional XY transfer gantry. Use 2020 extrusion and GT2 belt; two motors if no donor printer.
R06 | R06_gt2_idler_corner_mount | machine | M9 | upcoming | R3 STEP + M2 conversion | 2 | PETG | 58.0 | 44.0 | 38.0 | 29.938 | True | True | 1 | True | 38.0 | step/machine/R06_gt2_idler_corner_mount.step | stl/machine/R06_gt2_idler_corner_mount.stl | 3mf/machine/R06_gt2_idler_corner_mount.3mf | True | not recorded | not tested | not tested | no | Adjustable idler mount for 5 mm bore GT2 idler. Tighten only enough to remove belt slack.
R07 | R07_xy_tool_carriage | machine | M9 | upcoming | R3 STEP + M2 conversion | 1 | PETG | 86.0 | 64.0 | 8.0 | 42.342 | True | True | 1 | True | 53.8 | step/machine/R07_xy_tool_carriage.step | stl/machine/R07_xy_tool_carriage.stl | 3mf/machine/R07_xy_tool_carriage.3mf | True | not recorded | not tested | not tested | no | Tool carriage accepts R01. Adapt to V-wheel or MGN12 donor hardware.
R08 | R08_z_lift_servo_mount | machine | M9 | upcoming | R3 STEP + M2 conversion | 1 | PETG | 54.0 | 36.0 | 40.0 | 24.222 | True | True | 1 | True | 30.8 | step/machine/R08_z_lift_servo_mount.step | stl/machine/R08_z_lift_servo_mount.stl | 3mf/machine/R08_z_lift_servo_mount.3mf | True | not recorded | not tested | not tested | no | SG90/MG90S Z-lift mount for approximately 15-20 mm pickup travel. Keep end effector light.
S01 | S01_seed_hopper | machine | M6 | needs repair | R3 STEP + M2 conversion | 1 | PETG | 95.0 | 95.0 | 98.0 | 180.159 | True | True | 2 | True | 228.8 | step/machine/S01_seed_hopper.step | stl/machine/S01_seed_hopper.stl | 3mf/machine/S01_seed_hopper.3mf | True | not recorded | not tested | not tested | no | R3 STEP has two disconnected bodies (funnel not fused to the housing): repair in CAD before printing. Species-specific low-cost gravity hopper. Use only dry seeds; pocket disk below throat meters one seed.
S02 | S02_seed_singulator_disk_6mm | machine | M6 | upcoming | R3 STEP + M2 conversion | 1 | PETG | 72.0 | 72.0 | 5.0 | 19.023 | True | True | 1 | True | 24.2 | step/machine/S02_seed_singulator_disk_6mm.step | stl/machine/S02_seed_singulator_disk_6mm.stl | 3mf/machine/S02_seed_singulator_disk_6mm.3mf | True | not recorded | not tested | not tested | no | Six 6.8 mm pockets over 180 degrees for a 28BYJ-48 indexing mechanism. Regenerate pocket size per seed species.
S03 | S03_28byj_seed_indexer_mount | machine | M6 | upcoming | R3 STEP + M2 conversion | 1 | PETG | 68.0 | 56.0 | 42.0 | 42.482 | True | True | 1 | True | 54.0 | step/machine/S03_28byj_seed_indexer_mount.step | stl/machine/S03_28byj_seed_indexer_mount.stl | 3mf/machine/S03_28byj_seed_indexer_mount.3mf | True | not recorded | not tested | not tested | no | Mounts 28BYJ-48 below singulator disk; use metal M3 standoffs if needed.
S04 | S04_three_tail_assembly_nest | machine | M6 | upcoming | R3 STEP + M2 conversion | 1 | PETG+silicone | 116.0 | 116.0 | 8.0 | 80.576 | True | True | 1 | True | 102.3 | step/machine/S04_three_tail_assembly_nest.step | stl/machine/S04_three_tail_assembly_nest.stl | 3mf/machine/S04_three_tail_assembly_nest.3mf | True | not recorded | not tested | not tested | no | Three 120 degree tail channels around central tip cavity. Use soft inserts where body contacts fixture.
S05 | S05_10ml_syringe_holder | machine | M6 | upcoming | R3 STEP + M2 conversion | 1 | PETG | 72.0 | 52.0 | 28.0 | 76.471 | True | True | 1 | True | 97.1 | step/machine/S05_10ml_syringe_holder.step | stl/machine/S05_10ml_syringe_holder.stl | 3mf/machine/S05_10ml_syringe_holder.3mf | True | not recorded | not tested | not tested | no | Nominal 20-21 mm syringe barrel. Measure syringe before final print.
S06 | S06_syringe_plunger_carriage | machine | M6 | upcoming | R3 STEP + M2 conversion | 1 | PETG | 48.0 | 30.0 | 16.0 | 20.714 | True | True | 1 | True | 26.3 | step/machine/S06_syringe_plunger_carriage.step | stl/machine/S06_syringe_plunger_carriage.stl | 3mf/machine/S06_syringe_plunger_carriage.3mf | True | not recorded | not tested | not tested | no | M5 threaded-rod plunger carriage driven by 28BYJ-48. Add current/time limit to prevent overpressure.
S07 | S07_tip_mold_half_A | machine | M6 | experimental | R3 STEP + M2 conversion | 2 | PETG mold master / silicone working insert | 72.0 | 48.0 | 14.0 | 43.651 | True | True | 1 | True | 55.4 | step/machine/S07_tip_mold_half_A.step | stl/machine/S07_tip_mold_half_A.stl | 3mf/machine/S07_tip_mold_half_A.3mf | True | not recorded | not tested | not tested | no | Mold MASTER for a compliant working insert; validate paste, release and seed viability. Two identical mold masters; clamp face-to-face around the seed/tail junction. Validate paste, release and seed viability; do not heat live seed.
S08 | S08_tip_mold_half_B | machine | M6 | experimental | R3 STEP + M2 conversion | 2 | PETG mold master / silicone working insert | 72.0 | 48.0 | 14.0 | 43.651 | True | True | 1 | True | 55.4 | step/machine/S08_tip_mold_half_B.step | stl/machine/S08_tip_mold_half_B.stl | 3mf/machine/S08_tip_mold_half_B.3mf | True | not recorded | not tested | not tested | no | Mold MASTER for a compliant working insert. Two identical mold masters; clamp face-to-face around the seed/tail junction. Validate paste, release and seed viability; do not heat live seed.
T01 | T01_tail_former_left | machine | M4 | upcoming | R3 STEP + M2 conversion | 2 | PETG | 23.8 | 44.0 | 8.8 | 4.253 | True | True | 1 | True | 5.4 | step/machine/T01_tail_former_left.step | stl/machine/T01_tail_former_left.stl | 3mf/machine/T01_tail_former_left.3mf | True | not recorded | not tested | not tested | no | Split wet-forming mandrel, 14 mm radius, 4.8 mm channel. Experimental geometry.
T02 | T02_tail_former_right | machine | M4 | upcoming | R3 STEP + M2 conversion | 2 | PETG | 23.8 | 44.0 | 8.8 | 4.253 | True | True | 1 | True | 5.4 | step/machine/T02_tail_former_right.step | stl/machine/T02_tail_former_right.stl | 3mf/machine/T02_tail_former_right.3mf | True | not recorded | not tested | not tested | no | Mate with T01. Split enables wet release without dragging over an undercut.
T03 | T03_tail_sweep_shoe | machine | M4 | needs repair | R3 STEP + M2 conversion | 1 | PETG+PTFE | 43.59 | 31.0 | 5.0 | 2.657 | True | True | 2 | True | 3.4 | step/machine/T03_tail_sweep_shoe.step | stl/machine/T03_tail_sweep_shoe.stl | 3mf/machine/T03_tail_sweep_shoe.3mf | True | not recorded | not tested | not tested | no | R3 STEP has two disconnected bodies (servo tab 2 mm away from the arc shoe): add a bridge before printing. Servo-driven smooth sweep shoe. Line strip-contact surface with PTFE tape.
T04 | T04_tail_blank_clamp | machine | M4 | upcoming | R3 STEP + M2 conversion | 2 | PETG+silicone | 46.0 | 22.0 | 24.0 | 9.279 | True | True | 1 | True | 11.8 | step/machine/T04_tail_blank_clamp.step | stl/machine/T04_tail_blank_clamp.stl | 3mf/machine/T04_tail_blank_clamp.3mf | True | not recorded | not tested | not tested | no | Light clamp for auxiliary tail blank during forming.
W01 | W01_nema17_rotation_mount | machine | M2 | core | R3 STEP + M2 conversion | 1 | PETG | 66.0 | 66.0 | 66.0 | 58.088 | True | True | 1 | True | 73.8 | step/machine/W01_nema17_rotation_mount.step | stl/machine/W01_nema17_rotation_mount.stl | 3mf/machine/W01_nema17_rotation_mount.3mf | True | not recorded | not tested | not tested | no | NEMA17 face mount; use purchased flexible coupler + small collet/pin vise for 0.8 mm mandrel.
W02 | W02_608_mandrel_support | machine | M2 | optional | R3 STEP + M2 conversion | 1 | PETG | 56.0 | 32.0 | 42.0 | 32.698 | True | True | 1 | True | 41.5 | step/machine/W02_608_mandrel_support.step | stl/machine/W02_608_mandrel_support.stl | 3mf/machine/W02_608_mandrel_support.3mf | True | not recorded | not tested | not tested | no | 608 bore at 25.0 mm vs the 37.0 mm W01 axis: needs a 12 mm riser. Not used in the R3.1 core cell (mini chuck mounts on the motor shaft). 608 bearing support for driven chuck/shaft; mandrel itself is metal, not printed.
W03 | W03_lm8uu_linear_carriage | machine | M2 | superseded | R3 STEP + M2 conversion | 1 | PETG | 90.0 | 70.0 | 30.0 | 75.803 | True | True | 1 | True | 96.3 | step/machine/W03_lm8uu_linear_carriage.step | stl/machine/W03_lm8uu_linear_carriage.stl | 3mf/machine/W03_lm8uu_linear_carriage.3mf | True | not recorded | not tested | not tested | no | R3 note says two LM8UU bores 56 mm apart, but the solid has none. Use W11. Two 15.4 mm LM8UU bores, 56 mm apart. Clamp bearings with zip ties through slots.
W04 | W04_t8_nut_carrier | machine | M2 | superseded | R3 STEP + M2 conversion | 1 | PETG | 50.0 | 42.0 | 28.0 | 29.138 | True | True | 1 | True | 37.0 | step/machine/W04_t8_nut_carrier.step | stl/machine/W04_t8_nut_carrier.stl | 3mf/machine/W04_t8_nut_carrier.3mf | True | not recorded | not tested | not tested | no | T8 flange-nut mount is integrated in W11. Kept for reference. Fits common flange T8 anti-backlash nut. Confirm your nut hole pattern; ream if needed.
W05 | W05_mandrel_end_guide | machine | M2 | core | R3 STEP + M2 conversion | 1 | PETG | 42.0 | 36.0 | 40.0 | 15.828 | True | True | 1 | True | 20.1 | step/machine/W05_mandrel_end_guide.step | stl/machine/W05_mandrel_end_guide.stl | 3mf/machine/W05_mandrel_end_guide.3mf | True | not recorded | not tested | not tested | no | 2.2 mm bore accepts a short brass/PTFE guide tube around the steel mandrel.
W06 | W06_camera_tilt_mount | machine | M7 | superseded | R3 STEP + M2 conversion | 1 | PETG | 58.0 | 42.0 | 40.0 | 25.926 | True | True | 1 | True | 32.9 | step/machine/W06_camera_tilt_mount.step | stl/machine/W06_camera_tilt_mount.stl | 3mf/machine/W06_camera_tilt_mount.3mf | True | not recorded | not tested | not tested | no | Camera tilt mount for the R3 camera; the budget USB board camera mounts on W18. Adjustable RealSense/USB camera adapter mount; add camera-specific plate with M3 slots.
W07 | W07_micro_release_clamp_lower | machine | M3 | experimental | R3 STEP + M2 conversion | 1 | PETG+silicone | 34.0 | 12.0 | 26.0 | 5.046 | True | True | 1 | True | 6.4 | step/machine/W07_micro_release_clamp_lower.step | stl/machine/W07_micro_release_clamp_lower.stl | 3mf/machine/W07_micro_release_clamp_lower.3mf | True | not recorded | not tested | not tested | no | Split demold support. Pocket axis at 17 mm: needs a 20 mm riser or a carriage mount (Phase 2). Split demold collar. Tune the silicone-lined opening to the measured wet coil OD; closes lightly while mandrel retracts.
W08 | W08_micro_release_clamp_upper | machine | M3 | experimental | R3 STEP + M2 conversion | 1 | PETG+silicone | 34.0 | 12.0 | 26.0 | 5.046 | True | True | 1 | True | 6.4 | step/machine/W08_micro_release_clamp_upper.step | stl/machine/W08_micro_release_clamp_upper.stl | 3mf/machine/W08_micro_release_clamp_upper.3mf | True | not recorded | not tested | not tested | no | Mate of W07 (Phase 2). Mate W07. This is a fit-test mechanism; wet demolding must be validated before unattended operation.
W09 | W09_linear_motor_end_block | machine | M2 | core | R3.1 core_cell.py | 1 | PETG | 28.0 | 78.0 | 48.0 | 56.82 | True | True | 1 | True | 72.2 | step/machine/W09_linear_motor_end_block.step | stl/machine/W09_linear_motor_end_block.stl | 3mf/machine/W09_linear_motor_end_block.3mf | True | not recorded | not tested | not tested | no | Rod sockets + NEMA17 boss register for the traverse axis (motor held by W16). Print on its base, 40% infill, 4 walls.
W10 | W10_linear_idler_end_block | machine | M2 | core | R3.1 core_cell.py | 1 | PETG | 28.0 | 78.0 | 48.0 | 59.645 | True | True | 1 | True | 75.7 | step/machine/W10_linear_idler_end_block.step | stl/machine/W10_linear_idler_end_block.stl | 3mf/machine/W10_linear_idler_end_block.3mf | True | not recorded | not tested | not tested | no | Rod sockets + 608ZZ pocket supporting the free end of the T8x8 screw.
W11 | W11_lm8uu_traverse_carriage | machine | M2 | core | R3.1 core_cell.py | 1 | PETG | 40.0 | 77.2 | 22.6 | 51.529 | True | True | 1 | True | 65.4 | step/machine/W11_lm8uu_traverse_carriage.step | stl/machine/W11_lm8uu_traverse_carriage.stl | 3mf/machine/W11_lm8uu_traverse_carriage.3mf | True | not recorded | not tested | not tested | no | Two LM8UU bores (15.2 mm, tune with Z01) + T8 flange-nut mount (16 mm PCD). Print standing on the -x face.
W12 | W12_angle_adjustable_guide_arm | machine | M1/M2 | core | R3.1 core_cell.py | 1 | PETG | 157.13 | 76.6 | 14.25 | 30.17 | True | True | 1 | True | 38.3 | step/machine/W12_angle_adjustable_guide_arm.step | stl/machine/W12_angle_adjustable_guide_arm.stl | 3mf/machine/W12_angle_adjustable_guide_arm.3mf | True | not recorded | not tested | not tested | no | Carries F06/F07. Concentric arc slots centred on the mandrel contact point give +/-60 deg of guide angle with 5 deg index marks.
W13 | W13_w05_axis_riser_11mm | machine | M2 | core | R3.1 core_cell.py | 1 | PETG | 42.0 | 36.0 | 11.0 | 16.225 | True | True | 1 | True | 20.6 | step/machine/W13_w05_axis_riser_11mm.step | stl/machine/W13_w05_axis_riser_11mm.stl | 3mf/machine/W13_w05_axis_riser_11mm.3mf | True | not recorded | not tested | not tested | no | Lifts retained W05 end guide to the 37.0 mm mandrel axis.
W14 | W14_limit_switch_rod_clamp | machine | M2 | core | R3.1 core_cell.py | 2 | PETG | 10.0 | 40.5 | 21.5 | 3.549 | True | True | 1 | True | 4.5 | step/machine/W14_limit_switch_rod_clamp.step | stl/machine/W14_limit_switch_rod_clamp.stl | 3mf/machine/W14_limit_switch_rod_clamp.3mf | True | not recorded | not tested | not tested | no | Home and end microswitch clamp on the outer 8 mm rod; slide to set trip points (home: carriage x 45 mm).
W15 | W15_nema17_body_clamp_rotation | machine | M2 | core | R3.1 core_cell.py | 1 | PETG | 28.0 | 70.6 | 69.3 | 41.941 | True | True | 1 | True | 53.3 | step/machine/W15_nema17_body_clamp_rotation.step | stl/machine/W15_nema17_body_clamp_rotation.stl | 3mf/machine/W15_nema17_body_clamp_rotation.3mf | True | not recorded | not tested | not tested | no | Split collar holding the rotation NEMA17 body (axis 37 mm); 2 x M2 pinch, 4 x M2 wood screws. Print on the -x face, 4 walls.
W16 | W16_nema17_body_clamp_linear | machine | M2 | core | R3.1 core_cell.py | 1 | PETG | 28.0 | 70.6 | 54.3 | 20.689 | True | True | 1 | True | 26.3 | step/machine/W16_nema17_body_clamp_linear.step | stl/machine/W16_nema17_body_clamp_linear.stl | 3mf/machine/W16_nema17_body_clamp_linear.3mf | True | not recorded | not tested | not tested | no | Split collar holding the traverse NEMA17 body (axis 22 mm, 0.7 mm floor rests on the plywood). Print on the -x face, 4 walls.
W17 | W17_camera_mast_foot | machine | M7 | core | R3.1 core_cell.py | 1 | PETG | 40.0 | 24.0 | 40.0 | 9.451 | True | True | 1 | True | 12.0 | step/machine/W17_camera_mast_foot.step | stl/machine/W17_camera_mast_foot.stl | 3mf/machine/W17_camera_mast_foot.3mf | True | not recorded | not tested | not tested | no | Foot bracket for the 30 x 18 mm plywood camera mast; M2 wood screws.
W18 | W18_camera_arm | machine | M7 | core | R3.1 core_cell.py | 1 | PETG | 42.0 | 83.0 | 62.0 | 19.836 | True | True | 1 | True | 25.2 | step/machine/W18_camera_arm.step | stl/machine/W18_camera_arm.stl | 3mf/machine/W18_camera_arm.3mf | True | not recorded | not tested | not tested | no | Arm from the mast top holding a 38 x 38 mm USB board camera (4 x M2, 34 mm pattern - MEASURE) over the coil. Print on the mast-side face.
X01 | X01_sg90_clamp_mount | machine | M3 | core | R3 STEP + M2 conversion | 1 | PETG | 68.0 | 44.0 | 32.0 | 32.705 | True | True | 1 | True | 41.5 | step/machine/X01_sg90_clamp_mount.step | stl/machine/X01_sg90_clamp_mount.stl | 3mf/machine/X01_sg90_clamp_mount.3mf | True | not recorded | not tested | not tested | no | SG90/MG90S-class clamp bracket; verify exact servo body dimensions.
X02 | X02_soft_clamp_jaw | machine | M3 | core | R3 STEP + M2 conversion | 2 | PETG+silicone | 34.0 | 13.0 | 12.0 | 3.781 | True | True | 1 | True | 4.8 | step/machine/X02_soft_clamp_jaw.step | stl/machine/X02_soft_clamp_jaw.stl | 3mf/machine/X02_soft_clamp_jaw.3mf | True | not recorded | not tested | not tested | no | Bond 1 mm silicone pad to jaw. Clamp sacrificial tail/handling tab, not active coils.
X03 | X03_guarded_shear_mount | machine | M3 | core | R3 STEP + M2 conversion | 1 | PETG | 88.0 | 58.0 | 41.0 | 53.168 | True | True | 1 | True | 67.5 | step/machine/X03_guarded_shear_mount.step | stl/machine/X03_guarded_shear_mount.stl | 3mf/machine/X03_guarded_shear_mount.3mf | True | not recorded | not tested | not tested | no | Universal mount for purchased spring-return micro shear. Do not print the blade.
X04 | X04_cutter_guard | machine | M3 | core | R3 STEP + M2 conversion | 1 | PETG prototype / polycarbonate final | 96.0 | 66.0 | 44.0 | 73.921 | True | True | 1 | True | 93.9 | step/machine/X04_cutter_guard.step | stl/machine/X04_cutter_guard.stl | 3mf/machine/X04_cutter_guard.3mf | True | not recorded | not tested | not tested | no | Bench guard shell. Production guard should be transparent impact-rated polycarbonate with interlock.
Z01 | Z01_fit_calibration_coupon | machine | Z | core | R3 STEP + M2 conversion | 1 | PETG | 110.0 | 55.0 | 5.0 | 28.142 | True | True | 1 | True | 35.7 | step/machine/Z01_fit_calibration_coupon.step | stl/machine/Z01_fit_calibration_coupon.stl | 3mf/machine/Z01_fit_calibration_coupon.3mf | True | not recorded | not tested | not tested | no | Hole sizes for M2/M3/M4/M5, 8 mm rod and LM8UU; channel widths for wet veneer. Print before the rest of the system.
MR01 | MR01_0p8mm_x100mm_FORMING_MANDREL_REFERENCE | reference | reference | reference | paper_reference.py |  | metal (buy) | 0.8 | 0.8 | 100.0 | 0.05 | True | True | 1 | True | 0.1 | step/reference/MR01_0p8mm_x100mm_FORMING_MANDREL_REFERENCE.step | stl/reference/MR01_0p8mm_x100mm_FORMING_MANDREL_REFERENCE.stl | 3mf/reference/MR01_0p8mm_x100mm_FORMING_MANDREL_REFERENCE.3mf | True | not recorded | not tested | not tested | no | Fixture/fit reference.
MR02 | MR02_0p8mm_to_5mm_split_collet_INSERT | reference | reference | experimental print | paper_reference.py |  |  | 5.0 | 5.0 | 12.0 | 0.219 | True | True | 1 | True | 0.3 | step/reference/MR02_0p8mm_to_5mm_split_collet_INSERT.step | stl/reference/MR02_0p8mm_to_5mm_split_collet_INSERT.stl | 3mf/reference/MR02_0p8mm_to_5mm_split_collet_INSERT.3mf | True | not recorded | not tested | not tested | no | Fixture/fit reference.
MR03 | MR03_mandrel_depth_stop_M2 | reference | reference | reference | paper_reference.py |  |  | 8.0 | 8.0 | 5.0 | 0.219 | True | True | 1 | True | 0.3 | step/reference/MR03_mandrel_depth_stop_M2.step | stl/reference/MR03_mandrel_depth_stop_M2.stl | 3mf/reference/MR03_mandrel_depth_stop_M2.3mf | True | not recorded | not tested | not tested | no | Fixture/fit reference.
MR04 | MR04_0p8mm_guide_bushing | reference | reference | reference | paper_reference.py |  |  | 8.0 | 8.0 | 10.0 | 0.494 | True | True | 1 | True | 0.6 | step/reference/MR04_0p8mm_guide_bushing.step | stl/reference/MR04_0p8mm_guide_bushing.stl | 3mf/reference/MR04_0p8mm_guide_bushing.3mf | True | not recorded | not tested | not tested | no | Fixture/fit reference.
MR05 | MR05_3mm_x140mm_LARGE_PINE_MANDREL_REFERENCE | reference | reference | reference | paper_reference.py |  | metal (buy) | 3.0 | 3.0 | 140.0 | 0.989 | True | True | 1 | True | 1.3 | step/reference/MR05_3mm_x140mm_LARGE_PINE_MANDREL_REFERENCE.step | stl/reference/MR05_3mm_x140mm_LARGE_PINE_MANDREL_REFERENCE.stl | 3mf/reference/MR05_3mm_x140mm_LARGE_PINE_MANDREL_REFERENCE.3mf | True | not recorded | not tested | not tested | no | Fixture/fit reference.
MR06 | MR06_COMPLETE_0p8mm_MANDREL_SUBASSEMBLY_REFERENCE | reference | reference | reference | paper_reference.py |  |  | 12.0 | 12.0 | 124.0 | 2.529 | True | True | 3 | True | 3.2 | step/reference/MR06_COMPLETE_0p8mm_MANDREL_SUBASSEMBLY_REFERENCE.step | stl/reference/MR06_COMPLETE_0p8mm_MANDREL_SUBASSEMBLY_REFERENCE.stl | 3mf/reference/MR06_COMPLETE_0p8mm_MANDREL_SUBASSEMBLY_REFERENCE.3mf | True | not recorded | not tested | not tested | no | Fixture/fit reference.
MR07 | MR07_0p8mm_MANDREL_WITH_STANDARD_7COIL_BODY_REFERENCE | reference | reference | reference | paper_reference.py |  |  | 2.64 | 2.64 | 100.79 | 0.107 | True | True | 2 | True | 0.1 | step/reference/MR07_0p8mm_MANDREL_WITH_STANDARD_7COIL_BODY_REFERENCE.step | stl/reference/MR07_0p8mm_MANDREL_WITH_STANDARD_7COIL_BODY_REFERENCE.stl | 3mf/reference/MR07_0p8mm_MANDREL_WITH_STANDARD_7COIL_BODY_REFERENCE.3mf | True | not recorded | not tested | not tested | no | Fixture/fit reference.
PR01 | PR01_standard_7coil_body_2p5x0p5_on_0p8 | reference | reference | reference | paper_reference.py |  |  | 2.64 | 2.64 | 36.58 | 0.056 | True | True | 1 | True | 0.1 | step/reference/PR01_standard_7coil_body_2p5x0p5_on_0p8.step | stl/reference/PR01_standard_7coil_body_2p5x0p5_on_0p8.stl | 3mf/reference/PR01_standard_7coil_body_2p5x0p5_on_0p8.3mf | True | not recorded | not tested | not tested | no | Reference/clearance geometry, not a functional carrier.
PR02 | PR02_standard_tail1_27mm | reference | reference | reference | paper_reference.py |  |  | 12.18 | 10.48 | 13.21 | 0.034 | True | True | 1 | True | 0.0 | step/reference/PR02_standard_tail1_27mm.step | stl/reference/PR02_standard_tail1_27mm.stl | 3mf/reference/PR02_standard_tail1_27mm.3mf | True | not recorded | not tested | not tested | no | Reference/clearance geometry, not a functional carrier.
PR03 | PR03_standard_tail2_29p5mm | reference | reference | reference | paper_reference.py |  |  | 14.77 | 11.61 | 13.27 | 0.037 | True | True | 1 | True | 0.0 | step/reference/PR03_standard_tail2_29p5mm.step | stl/reference/PR03_standard_tail2_29p5mm.stl | 3mf/reference/PR03_standard_tail2_29p5mm.3mf | True | not recorded | not tested | not tested | no | Reference/clearance geometry, not a functional carrier.
PR04 | PR04_standard_tail3_32p5mm | reference | reference | reference | paper_reference.py |  |  | 11.02 | 17.51 | 13.34 | 0.04 | True | True | 1 | True | 0.1 | step/reference/PR04_standard_tail3_32p5mm.step | stl/reference/PR04_standard_tail3_32p5mm.stl | 3mf/reference/PR04_standard_tail3_32p5mm.3mf | True | not recorded | not tested | not tested | no | Reference/clearance geometry, not a functional carrier.
PR05 | PR05_standard_tip_outer_reference | reference | reference | reference | paper_reference.py |  |  | 5.51 | 5.53 | 14.5 | 0.191 | True | True | 1 | True | 0.2 | step/reference/PR05_standard_tip_outer_reference.step | stl/reference/PR05_standard_tip_outer_reference.stl | 3mf/reference/PR05_standard_tip_outer_reference.3mf | True | not recorded | not tested | not tested | no | Reference/clearance geometry, not a functional carrier.
PR06 | PR06_standard_seed_payload_envelope | reference | reference | reference | paper_reference.py |  |  | 3.6 | 2.5 | 4.8 | 0.022 | True | True | 1 | True | 0.0 | step/reference/PR06_standard_seed_payload_envelope.step | stl/reference/PR06_standard_seed_payload_envelope.stl | 3mf/reference/PR06_standard_seed_payload_envelope.3mf | True | not recorded | not tested | not tested | no | Reference/clearance geometry, not a functional carrier.
PR07 | PR07_tip_hair_clearance_envelope | reference | reference | reference | paper_reference.py |  |  | 9.28 | 9.26 | 16.7 | 0.557 | True | True | 1 | True | 0.7 | step/reference/PR07_tip_hair_clearance_envelope.step | stl/reference/PR07_tip_hair_clearance_envelope.stl | 3mf/reference/PR07_tip_hair_clearance_envelope.3mf | True | not recorded | not tested | not tested | no | Reference/clearance geometry, not a functional carrier.
PR08 | PR08_STANDARD_FINISHED_3TAIL_SEED_CARRIER_1TO1 | reference | reference | reference | paper_reference.py |  |  | 18.67 | 22.02 | 54.48 | 0.38 | True | True | 6 | True | 0.5 | step/reference/PR08_STANDARD_FINISHED_3TAIL_SEED_CARRIER_1TO1.step | stl/reference/PR08_STANDARD_FINISHED_3TAIL_SEED_CARRIER_1TO1.stl | 3mf/reference/PR08_STANDARD_FINISHED_3TAIL_SEED_CARRIER_1TO1.3mf | True | not recorded | not tested | not tested | no | Reference/clearance geometry, not a functional carrier.
PR09 | PR09_STANDARD_SEED_CARRIER_EXPLODED_1TO1 | reference | reference | reference | paper_reference.py |  |  | 48.28 | 55.1 | 84.48 | 0.38 | True | True | 6 | True | 0.5 | step/reference/PR09_STANDARD_SEED_CARRIER_EXPLODED_1TO1.step | stl/reference/PR09_STANDARD_SEED_CARRIER_EXPLODED_1TO1.stl | 3mf/reference/PR09_STANDARD_SEED_CARRIER_EXPLODED_1TO1.3mf | True | not recorded | not tested | not tested | no | Reference/clearance geometry, not a functional carrier.
PR10 | PR10_primary_blank_48x2p5x0p5_reference | reference | reference | reference | paper_reference.py |  |  | 48.0 | 2.5 | 0.5 | 0.06 | True | True | 1 | True | 0.1 | step/reference/PR10_primary_blank_48x2p5x0p5_reference.step | stl/reference/PR10_primary_blank_48x2p5x0p5_reference.stl | 3mf/reference/PR10_primary_blank_48x2p5x0p5_reference.3mf | True | not recorded | not tested | not tested | no | Reference/clearance geometry, not a functional carrier.
PR11 | PR11_aux_tail_blank_29p5x2p5x0p5_reference | reference | reference | reference | paper_reference.py |  |  | 29.5 | 2.5 | 0.5 | 0.037 | True | True | 1 | True | 0.0 | step/reference/PR11_aux_tail_blank_29p5x2p5x0p5_reference.step | stl/reference/PR11_aux_tail_blank_29p5x2p5x0p5_reference.stl | 3mf/reference/PR11_aux_tail_blank_29p5x2p5x0p5_reference.3mf | True | not recorded | not tested | not tested | no | Reference/clearance geometry, not a functional carrier.
PR12 | PR12_aux_tail_blank_32p5x2p5x0p5_reference | reference | reference | reference | paper_reference.py |  |  | 32.5 | 2.5 | 0.5 | 0.041 | True | True | 1 | True | 0.1 | step/reference/PR12_aux_tail_blank_32p5x2p5x0p5_reference.step | stl/reference/PR12_aux_tail_blank_32p5x2p5x0p5_reference.stl | 3mf/reference/PR12_aux_tail_blank_32p5x2p5x0p5_reference.3mf | True | not recorded | not tested | not tested | no | Reference/clearance geometry, not a functional carrier.
PR20 | PR20_LARGE_PINE_7COIL_BODY_12x0p8_on_3mm | reference | reference | reference | paper_reference.py |  |  | 9.72 | 9.72 | 93.41 | 1.143 | True | True | 1 | True | 1.5 | step/reference/PR20_LARGE_PINE_7COIL_BODY_12x0p8_on_3mm.step | stl/reference/PR20_LARGE_PINE_7COIL_BODY_12x0p8_on_3mm.stl | 3mf/reference/PR20_LARGE_PINE_7COIL_BODY_12x0p8_on_3mm.3mf | True | not recorded | not tested | not tested | no | Reference/clearance geometry, not a functional carrier.
PR21 | PR21_whitebark_pine_seed_11mm_ENVELOPE | reference | reference | reference | paper_reference.py |  |  | 9.0 | 5.51 | 11.0 | 0.288 | True | True | 1 | True | 0.4 | step/reference/PR21_whitebark_pine_seed_11mm_ENVELOPE.step | stl/reference/PR21_whitebark_pine_seed_11mm_ENVELOPE.stl | 3mf/reference/PR21_whitebark_pine_seed_11mm_ENVELOPE.3mf | True | not recorded | not tested | not tested | no | Reference/clearance geometry, not a functional carrier.
PR22 | PR22_large_pine_tip_outer_ENVELOPE | reference | reference | reference | paper_reference.py |  |  | 14.26 | 14.25 | 29.0 | 2.165 | False | True | 2 | True | 2.8 | step/reference/PR22_large_pine_tip_outer_ENVELOPE.step | stl/reference/PR22_large_pine_tip_outer_ENVELOPE.stl | 3mf/reference/PR22_large_pine_tip_outer_ENVELOPE.3mf | False | not recorded | not tested | not tested | no | Reference/clearance geometry, not a functional carrier.
PR23 | PR23_LARGE_PINE_BODY_TIP_SEED_REFERENCE_NO_TAILS | reference | reference | reference | paper_reference.py |  |  | 14.26 | 14.25 | 117.21 | 3.597 | False | True | 4 | True | 4.6 | step/reference/PR23_LARGE_PINE_BODY_TIP_SEED_REFERENCE_NO_TAILS.step | stl/reference/PR23_LARGE_PINE_BODY_TIP_SEED_REFERENCE_NO_TAILS.stl | 3mf/reference/PR23_LARGE_PINE_BODY_TIP_SEED_REFERENCE_NO_TAILS.3mf | False | not recorded | not tested | not tested | no | Reference/clearance geometry, not a functional carrier.
PR24 | PR24_STANDARD_FINISHED_CARRIER_3X_DEMO_PRINT | reference | reference | demo print | paper_reference.py |  |  | 56.01 | 66.05 | 163.44 | 10.268 | True | True | 6 | True | 13.0 | step/reference/PR24_STANDARD_FINISHED_CARRIER_3X_DEMO_PRINT.step | stl/reference/PR24_STANDARD_FINISHED_CARRIER_3X_DEMO_PRINT.stl | 3mf/reference/PR24_STANDARD_FINISHED_CARRIER_3X_DEMO_PRINT.3mf | True | not recorded | not tested | not tested | no | Reference/clearance geometry, not a functional carrier.
