Normansrule/seedforge/hardware/cad/step/reference/MR06_COMPLETE_0p8mm_MANDREL_SUBASSEMBLY_REFERENCE.step

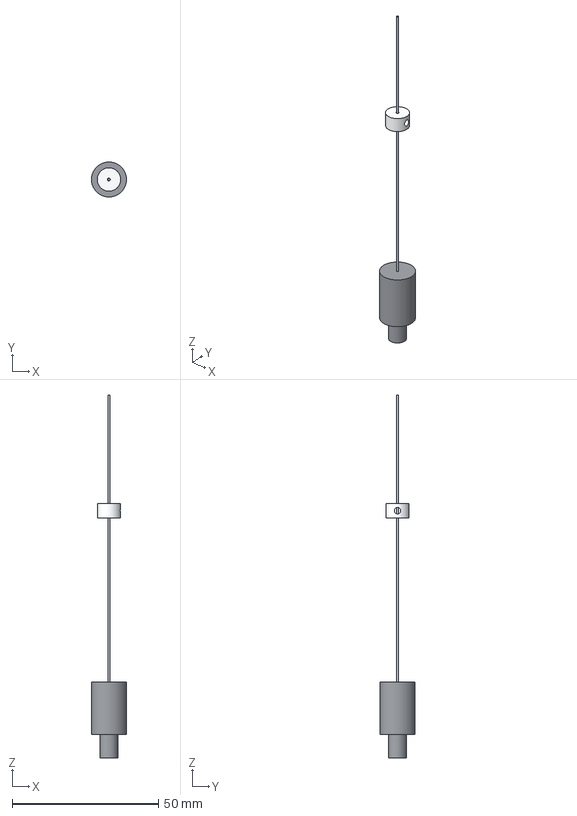
[picture p27: CAD file, 2026-10-11]
hardware/cad/step/reference/MR06_COMPLETE_0p8mm_MANDREL_SUBASSEMBLY_REFERENCE.step
12.0 x 12.0 x 124.0 mm
mandrel
chuck
stop
