Normansrule/seedforge/hardware/cad/source/r3_step/S04_three_tail_assembly_nest.step

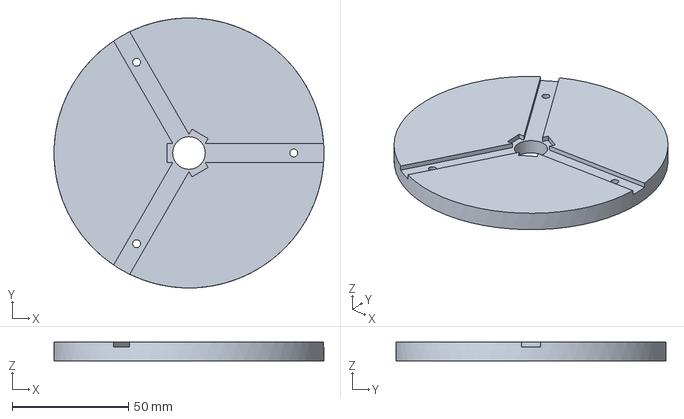
[picture p28: CAD file, 2026-10-11]
hardware/cad/source/r3_step/S04_three_tail_assembly_nest.step
116.0 x 116.0 x 8.00 mm
