Normansrule/seedforge/hardware/cad/source/r3_step/F05_dancer_roller.step

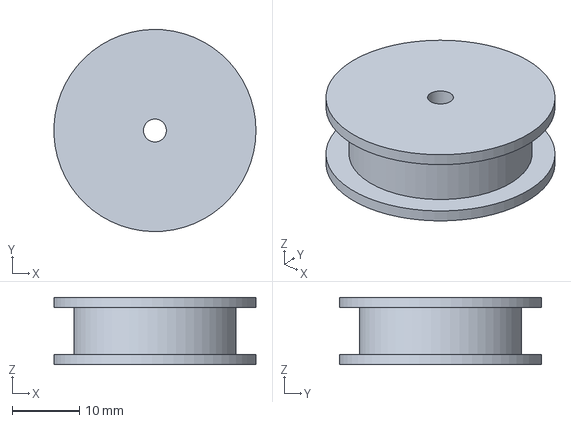
[picture p29: CAD file, 2026-10-11]
hardware/cad/source/r3_step/F05_dancer_roller.step
30.0 x 30.0 x 10.0 mm
