Normansrule/seedforge/hardware/cad/step/machine/D05_pi_zero2w_companion_plate.step

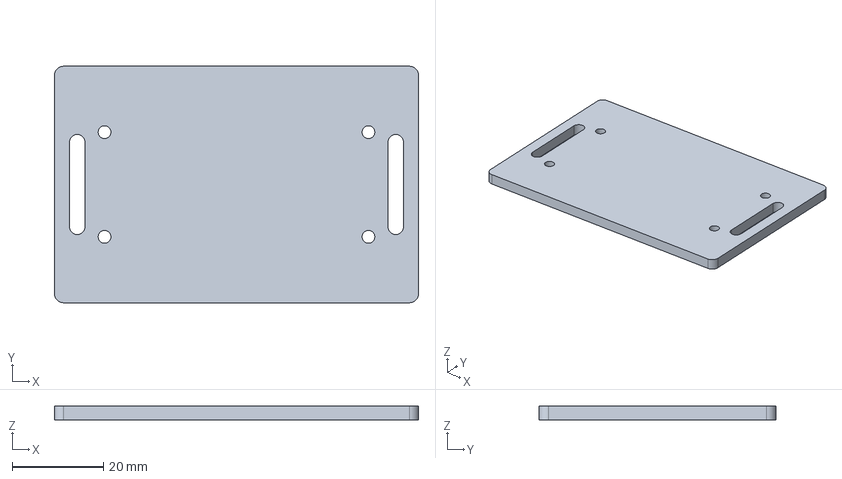
[picture p30: CAD file, 2026-10-11]
hardware/cad/step/machine/D05_pi_zero2w_companion_plate.step
80.0 x 52.0 x 3.00 mm
