Normansrule/seedforge/hardware/cad/step/reference/MR07_0p8mm_MANDREL_WITH_STANDARD_7COIL_BODY_REFERENCE.step

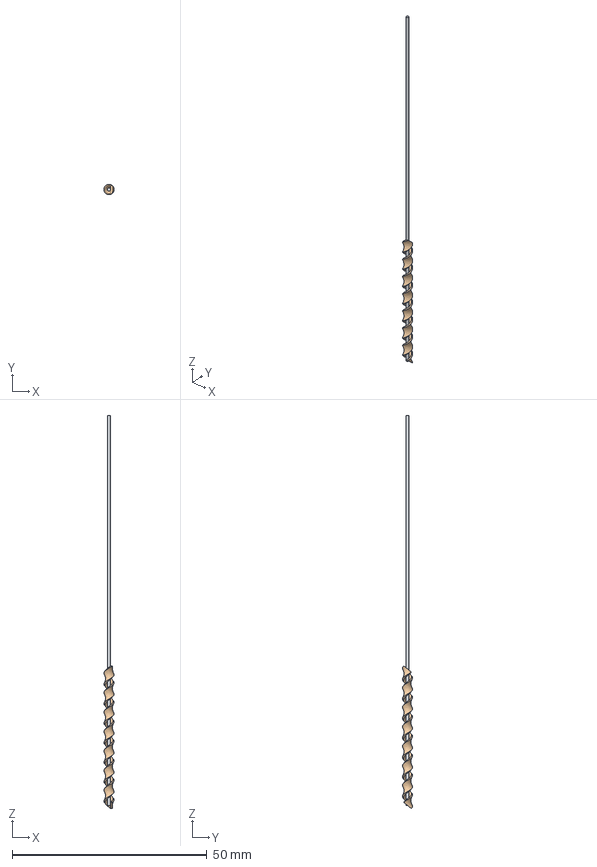
[picture p31: CAD file, 2026-10-11]
hardware/cad/step/reference/MR07_0p8mm_MANDREL_WITH_STANDARD_7COIL_BODY_REFERENCE.step
2.64 x 2.64 x 100.8 mm
mandrel
