Normansrule/seedforge/hardware/cad/source/r3_step/D06_downward_camera_mount.step

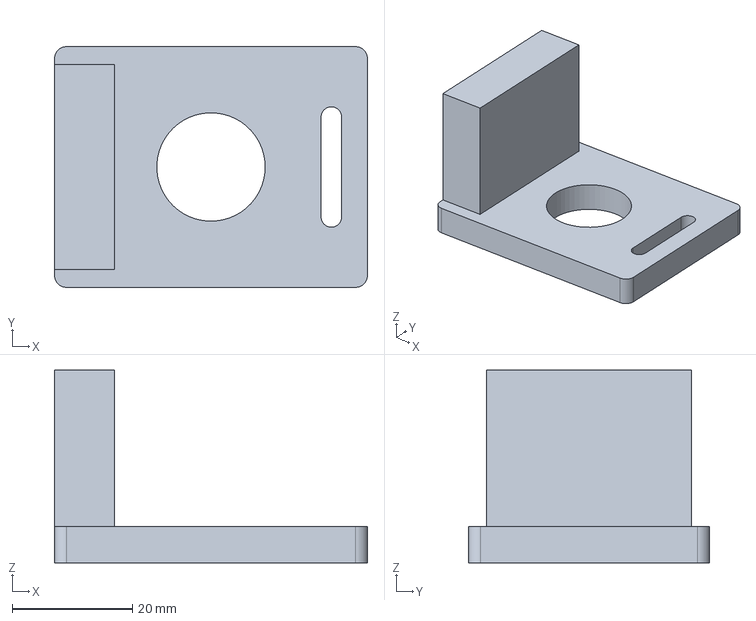
[picture p32: CAD file, 2026-10-11]
hardware/cad/source/r3_step/D06_downward_camera_mount.step
52.0 x 40.0 x 32.0 mm
