Normansrule/seedforge/hardware/cad/step/machine/X01_sg90_clamp_mount.step

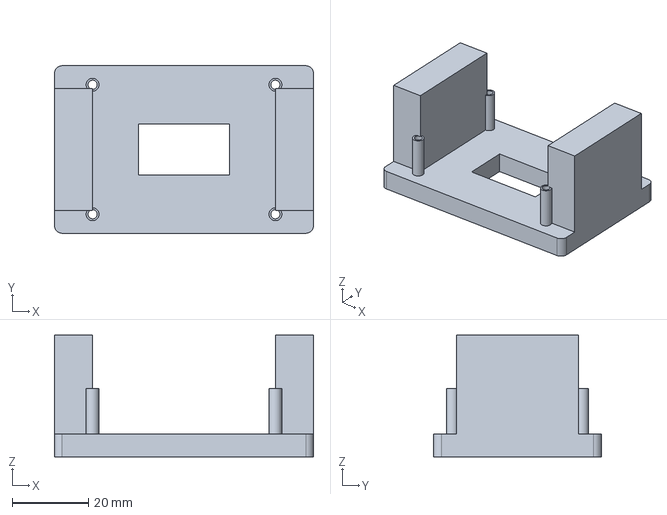
[picture p33: CAD file, 2026-10-11]
hardware/cad/step/machine/X01_sg90_clamp_mount.step
68.0 x 44.0 x 32.0 mm
