Normansrule/seedforge/hardware/cad/step/reference/PR06_standard_seed_payload_envelope.step

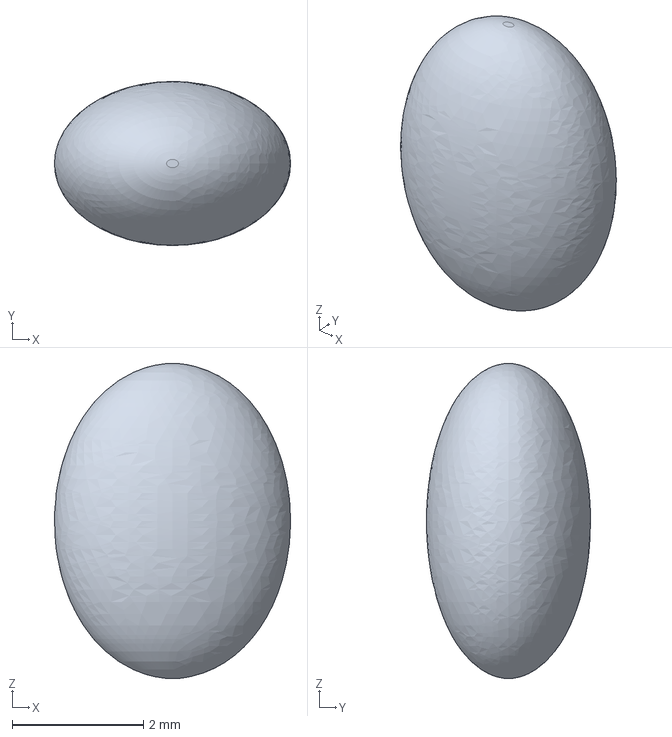
[picture p34: CAD file, 2026-10-11]
hardware/cad/step/reference/PR06_standard_seed_payload_envelope.step
3.60 x 2.50 x 4.80 mm
