Normansrule/seedforge/hardware/cad/source/r3_step/W03_lm8uu_linear_carriage.step

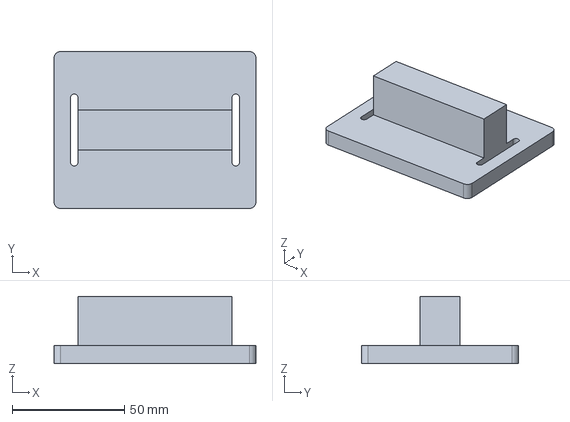
[picture p35: CAD file, 2026-10-11]
hardware/cad/source/r3_step/W03_lm8uu_linear_carriage.step
90.0 x 70.0 x 30.0 mm
