Normansrule/seedforge/hardware/cad/step/machine/W12_angle_adjustable_guide_arm.step

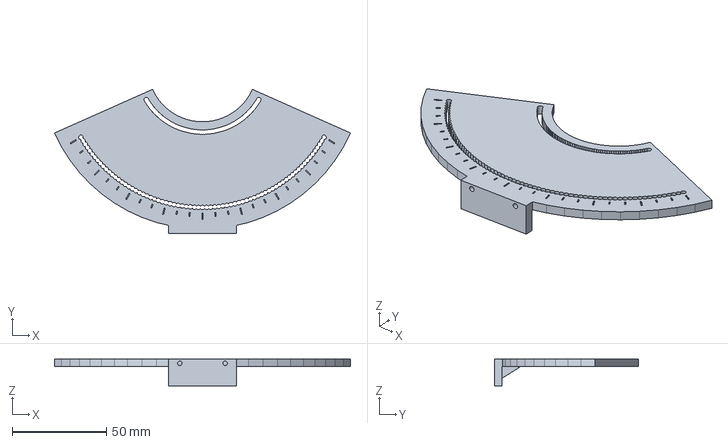
[picture p36: CAD file, 2026-10-11]
hardware/cad/step/machine/W12_angle_adjustable_guide_arm.step
157.1 x 76.6 x 14.2 mm
