Normansrule/seedforge/hardware/cad/step/reference/PR10_primary_blank_48x2p5x0p5_reference.step

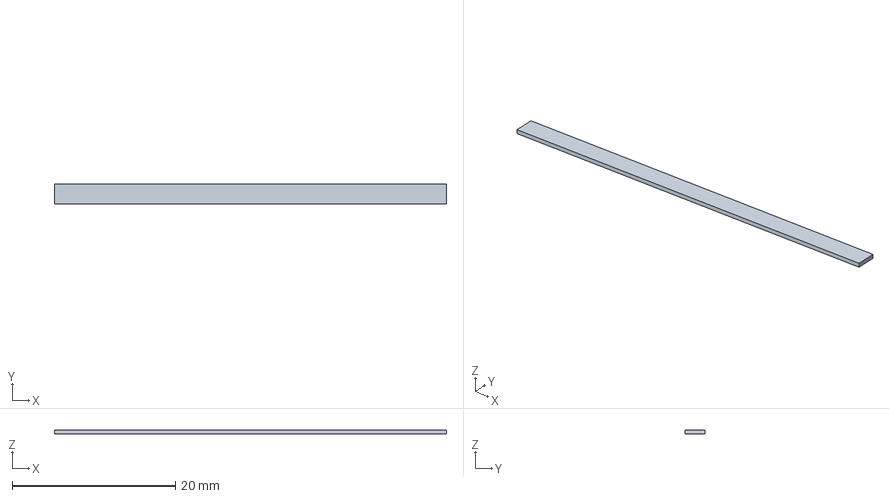
[picture p37: CAD file, 2026-10-11]
hardware/cad/step/reference/PR10_primary_blank_48x2p5x0p5_reference.step
48.0 x 2.50 x 0.5 mm
