Normansrule/seedforge/hardware/cad/source/r3_step/C03_electronics_box.step

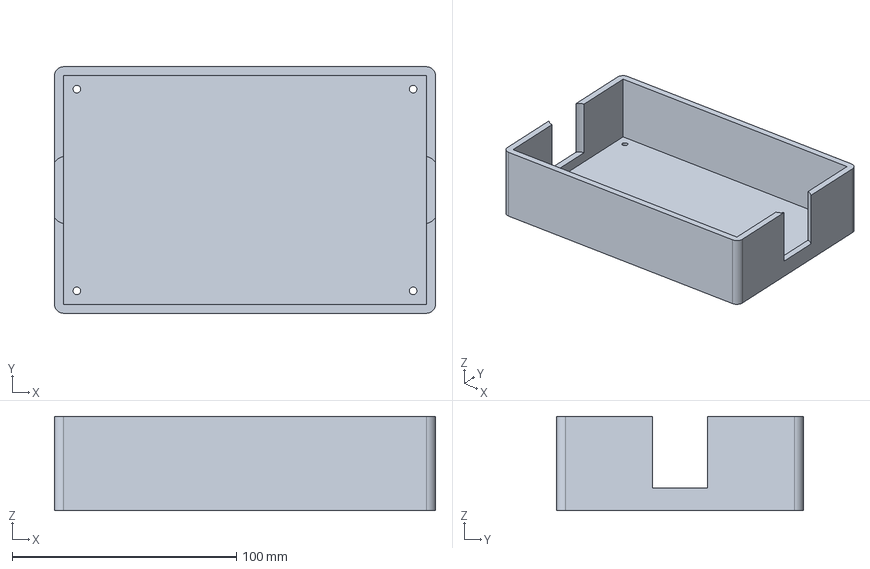
[picture p38: CAD file, 2026-10-11]
hardware/cad/source/r3_step/C03_electronics_box.step
170.0 x 110.0 x 42.0 mm
