Normansrule/seedforge/hardware/cad/step/machine/C05_ili9341_bezel.step

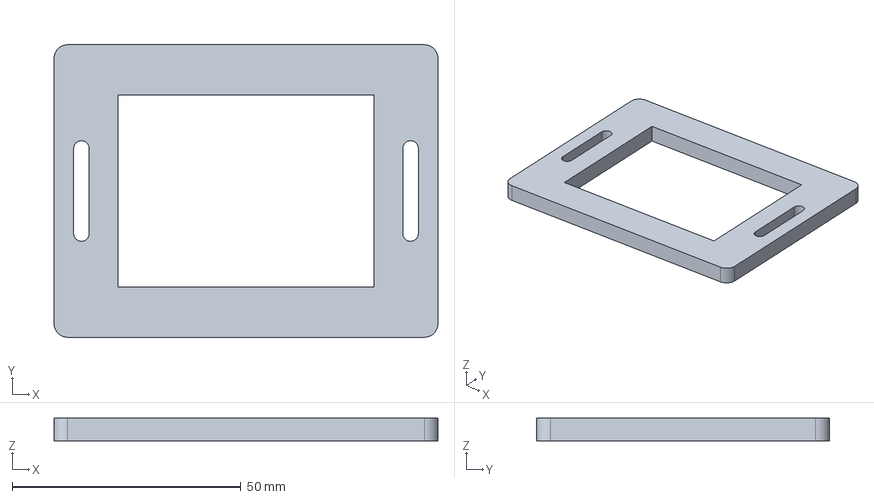
[picture p39: CAD file, 2026-10-11]
hardware/cad/step/machine/C05_ili9341_bezel.step
84.0 x 64.0 x 5.00 mm
