Normansrule/seedforge/hardware/cad/source/r3_step/T02_tail_former_right.step

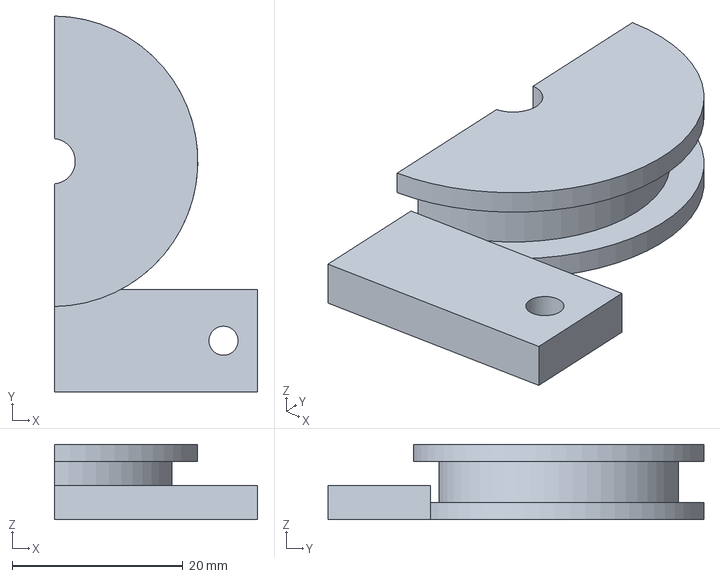
[picture p40: CAD file, 2026-10-11]
hardware/cad/source/r3_step/T02_tail_former_right.step
23.8 x 44.0 x 8.80 mm
