Normansrule/seedforge/hardware/cad/step/machine/S08_tip_mold_half_B.step

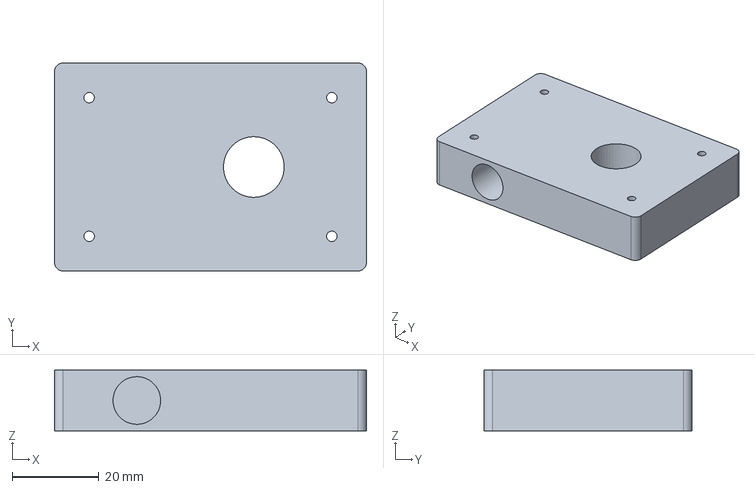
[picture p41: CAD file, 2026-10-11]
hardware/cad/step/machine/S08_tip_mold_half_B.step
72.0 x 48.0 x 14.0 mm
