Normansrule/seedforge/hardware/cad/step/reference/PR05_standard_tip_outer_reference.step

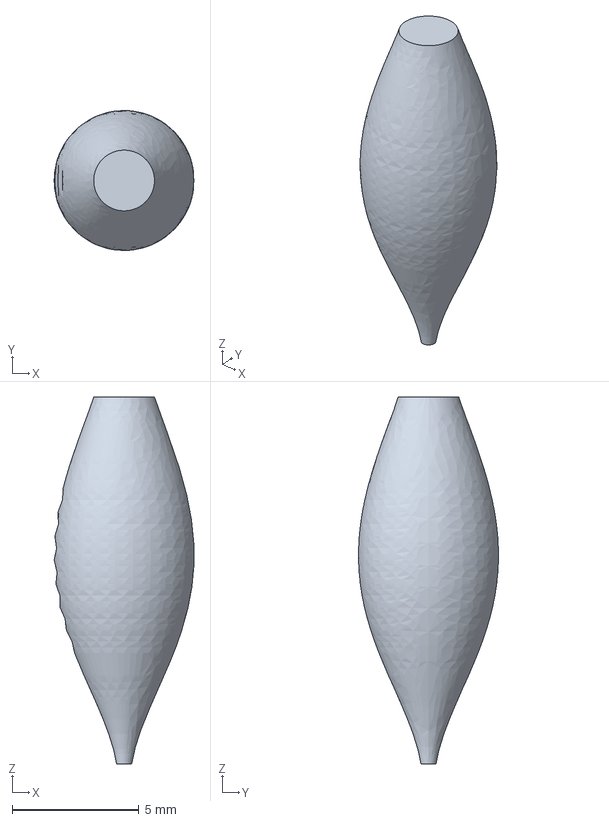
[picture p42: CAD file, 2026-10-11]
hardware/cad/step/reference/PR05_standard_tip_outer_reference.step
5.52 x 5.53 x 14.5 mm
