Normansrule/seedforge/hardware/cad/step/reference/PR21_whitebark_pine_seed_11mm_ENVELOPE.step

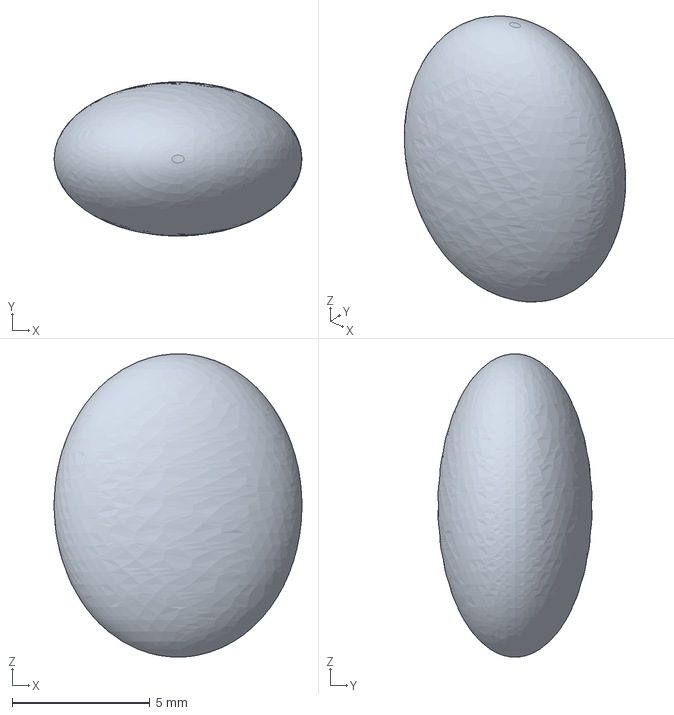
[picture p43: CAD file, 2026-10-11]
hardware/cad/step/reference/PR21_whitebark_pine_seed_11mm_ENVELOPE.step
9.00 x 5.59 x 11.0 mm
