Normansrule/seedforge/hardware/cad/step/machine/W11_lm8uu_traverse_carriage.step

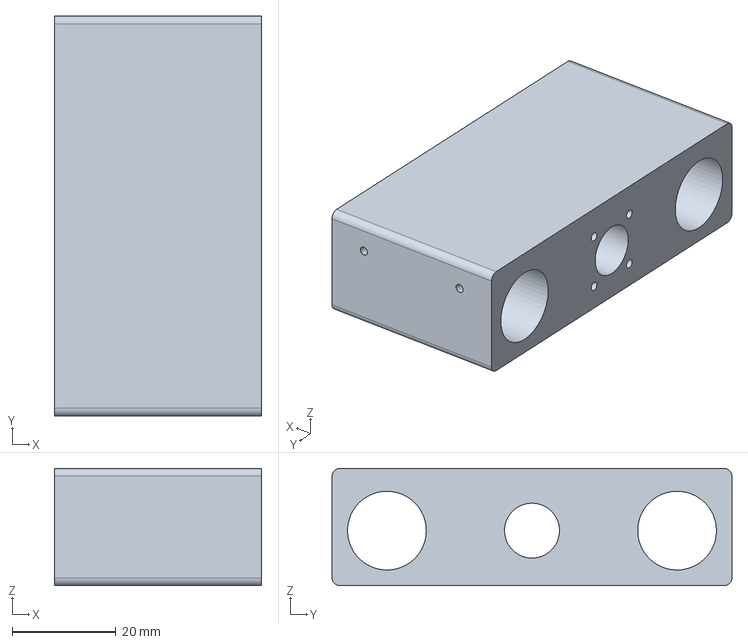
[picture p44: CAD file, 2026-10-11]
hardware/cad/step/machine/W11_lm8uu_traverse_carriage.step
40.0 x 77.2 x 22.6 mm
