Normansrule/seedforge/hardware/cad/step/reference/PR24_STANDARD_FINISHED_CARRIER_3X_DEMO_PRINT.step

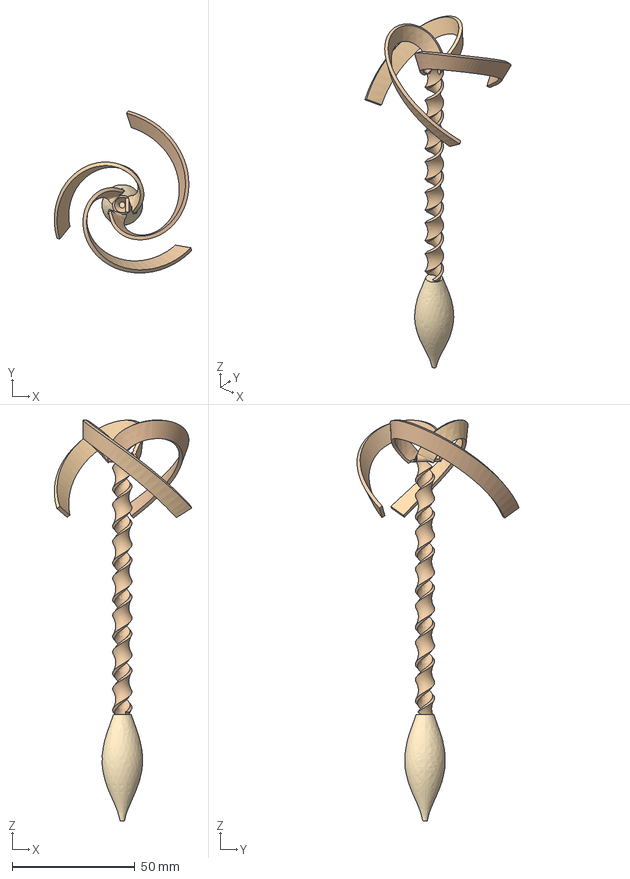
[picture p45: CAD file, 2026-10-11]
hardware/cad/step/reference/PR24_STANDARD_FINISHED_CARRIER_3X_DEMO_PRINT.step
56.0 x 66.1 x 163.4 mm
tail1
tail2
tail3
tip
seed
