Normansrule/seedforge/hardware/cad/source/r3_step/R08_z_lift_servo_mount.step

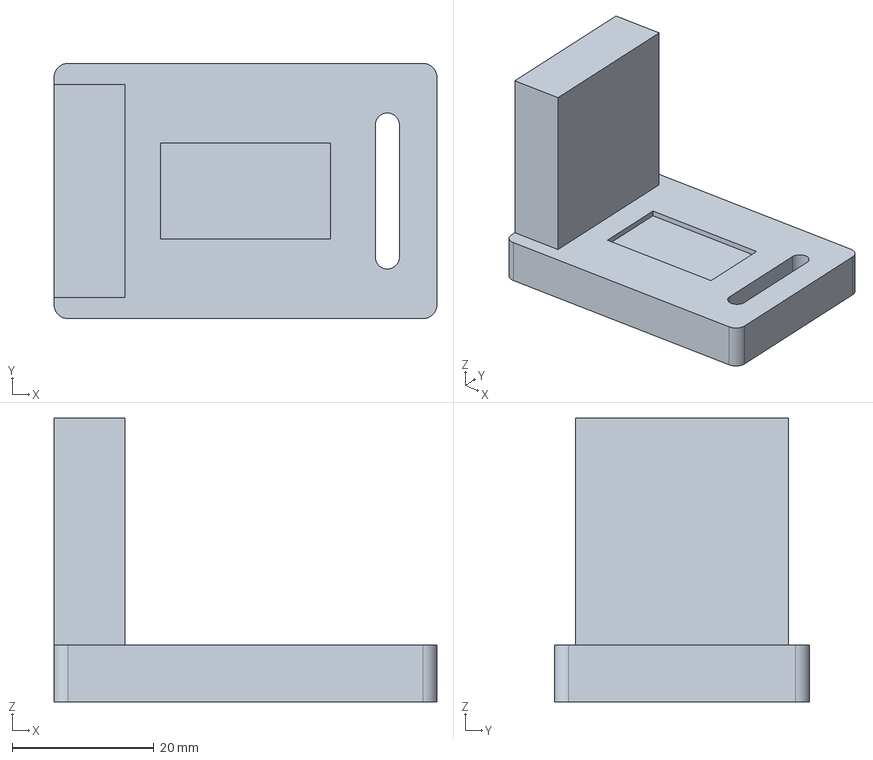
[picture p46: CAD file, 2026-10-11]
hardware/cad/source/r3_step/R08_z_lift_servo_mount.step
54.0 x 36.0 x 40.0 mm
