Normansrule/seedforge/hardware/cad/step/machine/D01_four_cell_payload_cassette.step

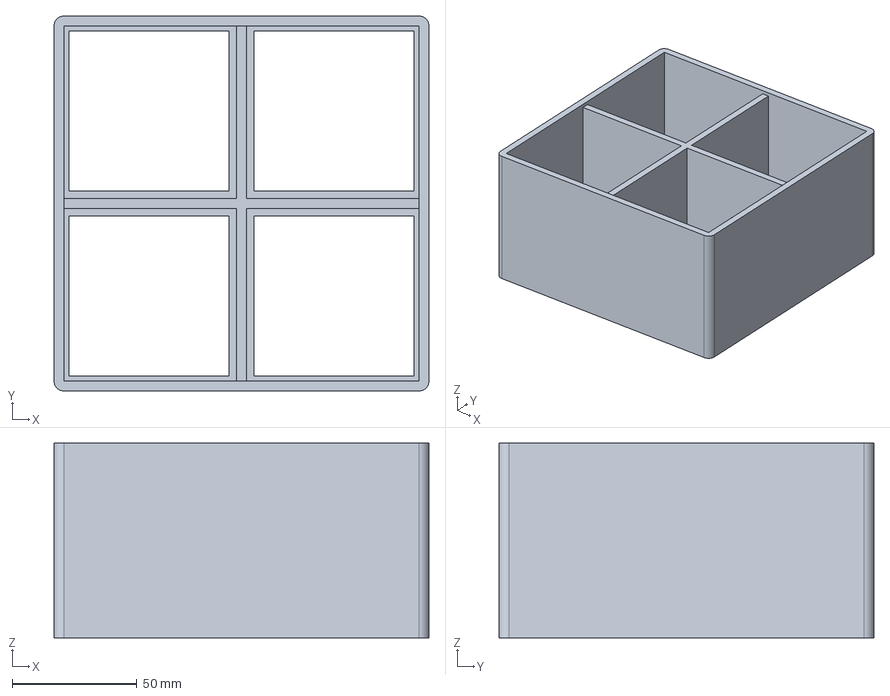
[picture p47: CAD file, 2026-10-11]
hardware/cad/step/machine/D01_four_cell_payload_cassette.step
150.0 x 150.0 x 78.0 mm
