Normansrule/seedforge/hardware/cad/step/reference/PR03_standard_tail2_29p5mm.step

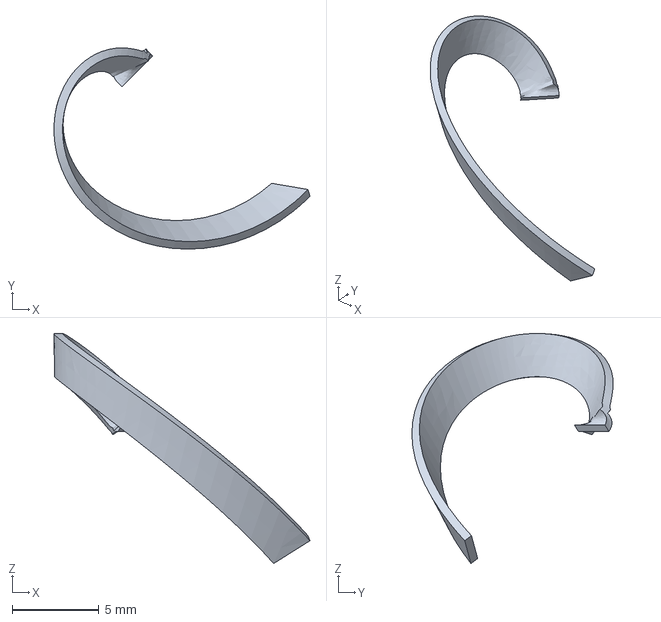
[picture p48: CAD file, 2026-10-11]
hardware/cad/step/reference/PR03_standard_tail2_29p5mm.step
14.8 x 11.6 x 13.3 mm
