Normansrule/seedforge/hardware/cad/source/r3_step/S06_syringe_plunger_carriage.step

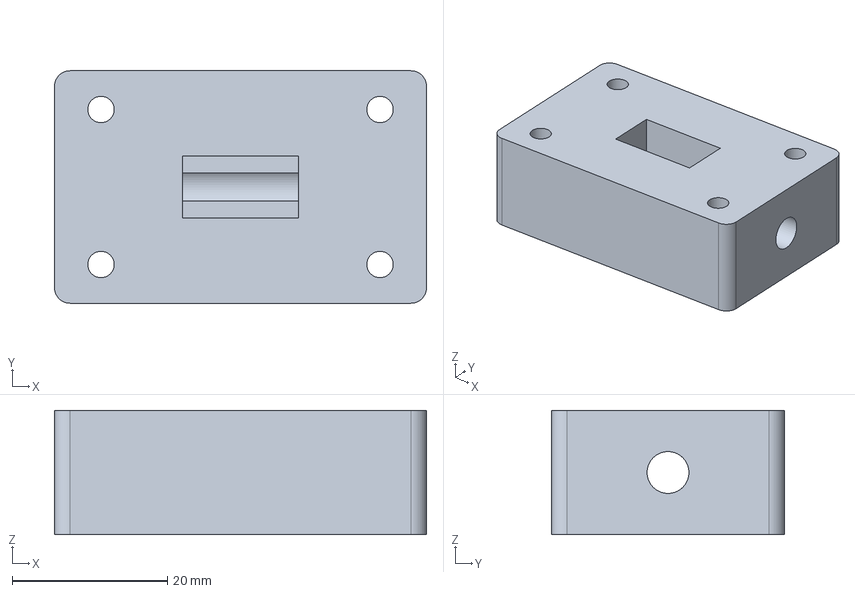
[picture p49: CAD file, 2026-10-11]
hardware/cad/source/r3_step/S06_syringe_plunger_carriage.step
48.0 x 30.0 x 16.0 mm
