Normansrule/seedforge/hardware/cad/step/machine/F06_veneer_guide_45deg_lower.step

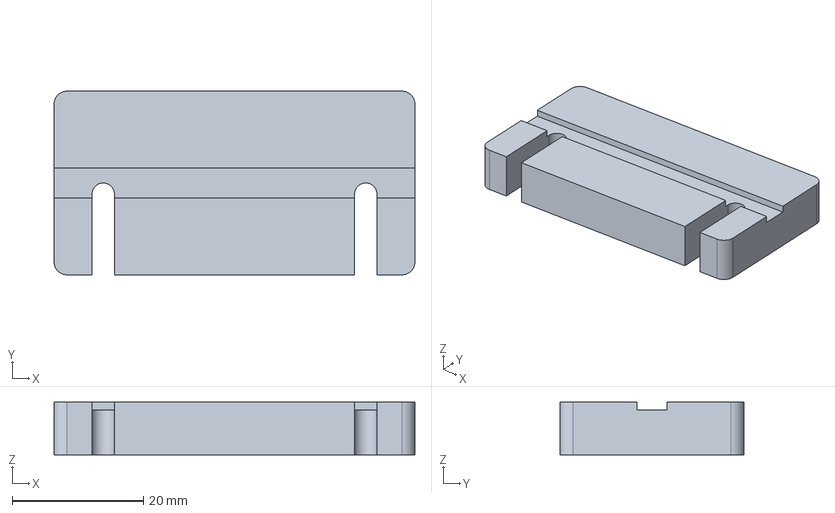
[picture p50: CAD file, 2026-10-11]
hardware/cad/step/machine/F06_veneer_guide_45deg_lower.step
55.0 x 28.0 x 8.00 mm
