Normansrule/seedforge/hardware/cad/step/reference/PR22_large_pine_tip_outer_ENVELOPE.step

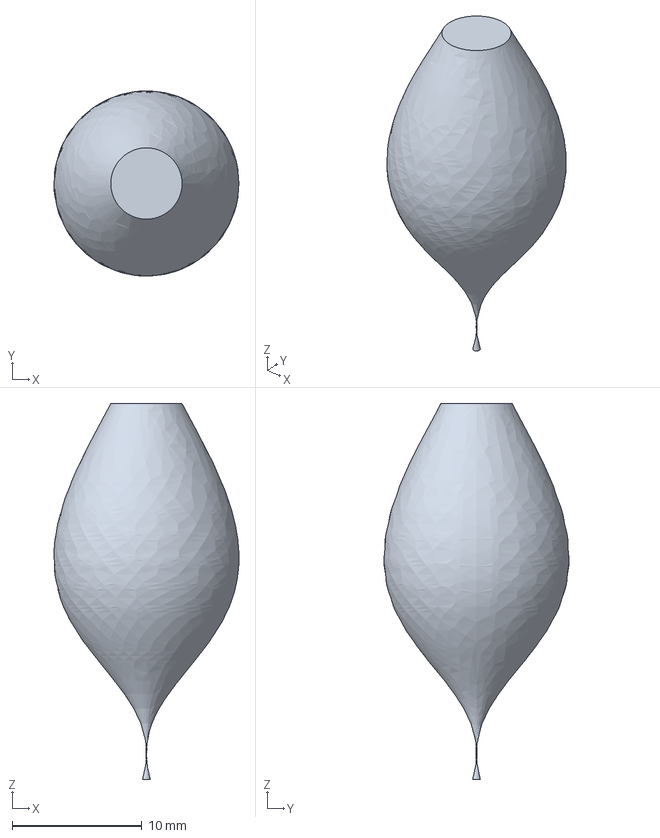
[picture p51: CAD file, 2026-10-11]
hardware/cad/step/reference/PR22_large_pine_tip_outer_ENVELOPE.step
14.3 x 14.3 x 29.0 mm
