Normansrule/seedforge/hardware/cad/step/machine/S01_seed_hopper.step

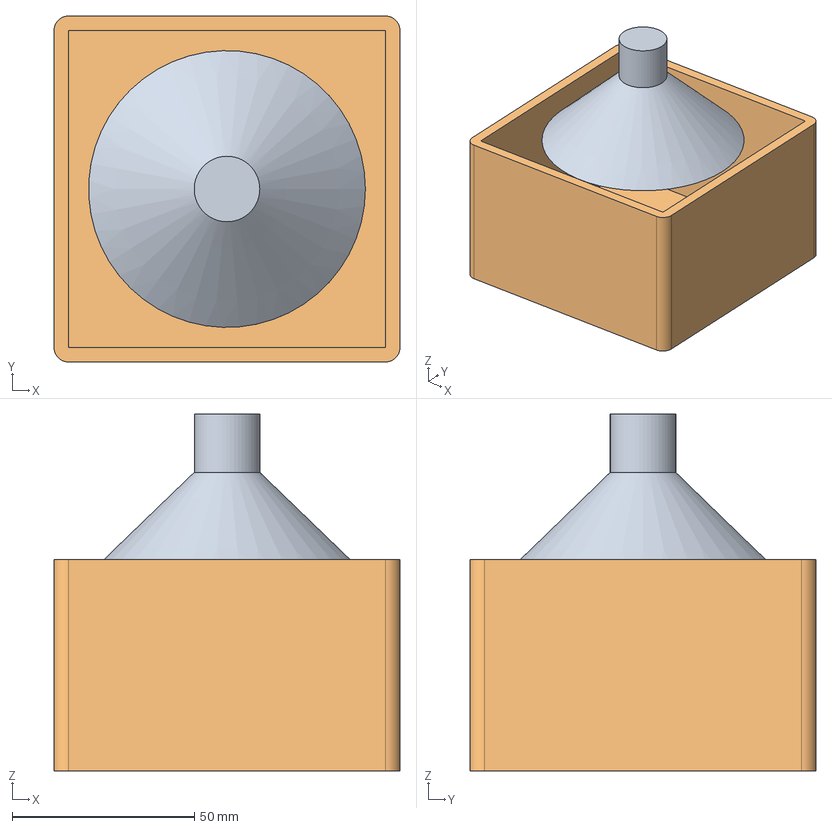
[picture p52: CAD file, 2026-10-11]
hardware/cad/step/machine/S01_seed_hopper.step
95.0 x 95.0 x 98.0 mm
