Normansrule/seedforge/hardware/cad/step/reference/PR20_LARGE_PINE_7COIL_BODY_12x0p8_on_3mm.step

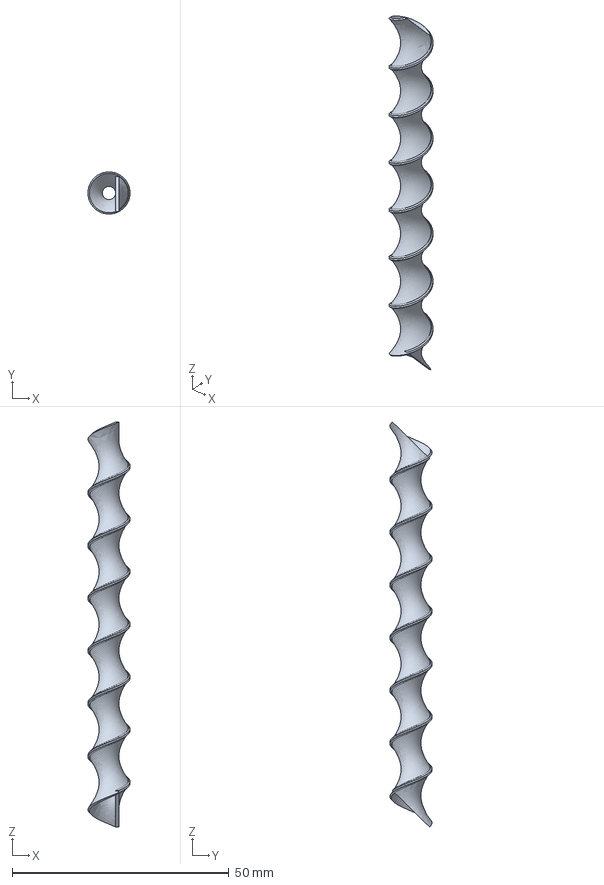
[picture p53: CAD file, 2026-10-11]
hardware/cad/step/reference/PR20_LARGE_PINE_7COIL_BODY_12x0p8_on_3mm.step
9.71 x 9.71 x 93.4 mm
