Normansrule/seedforge/hardware/cad/source/r3_step/F02_spool_stand_right.step

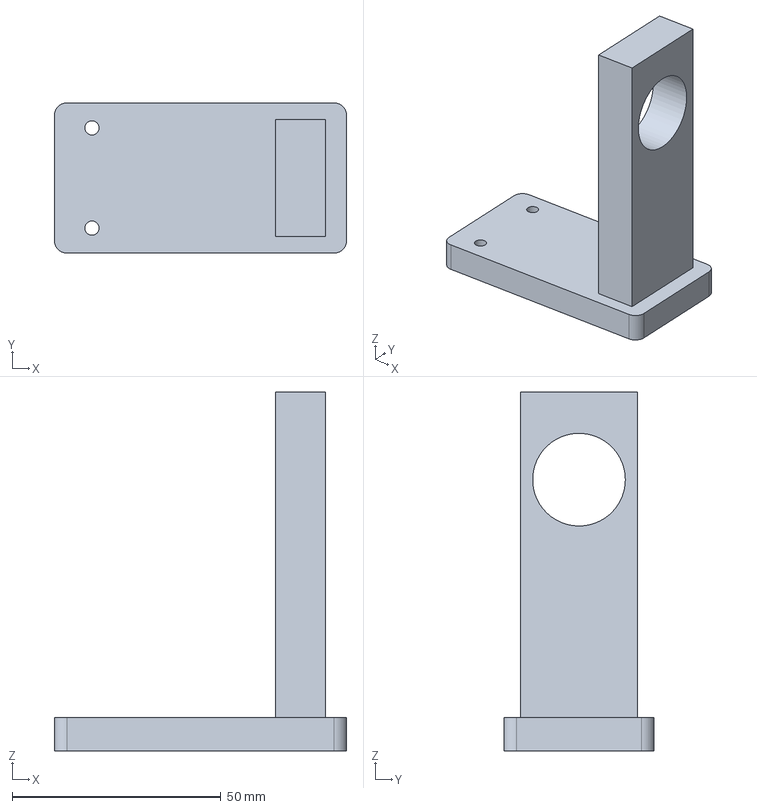
[picture p54: CAD file, 2026-10-11]
hardware/cad/source/r3_step/F02_spool_stand_right.step
70.0 x 36.0 x 86.0 mm
