Normansrule/seedforge/hardware/cad/step/machine/F11_dancer_pivot_post.step

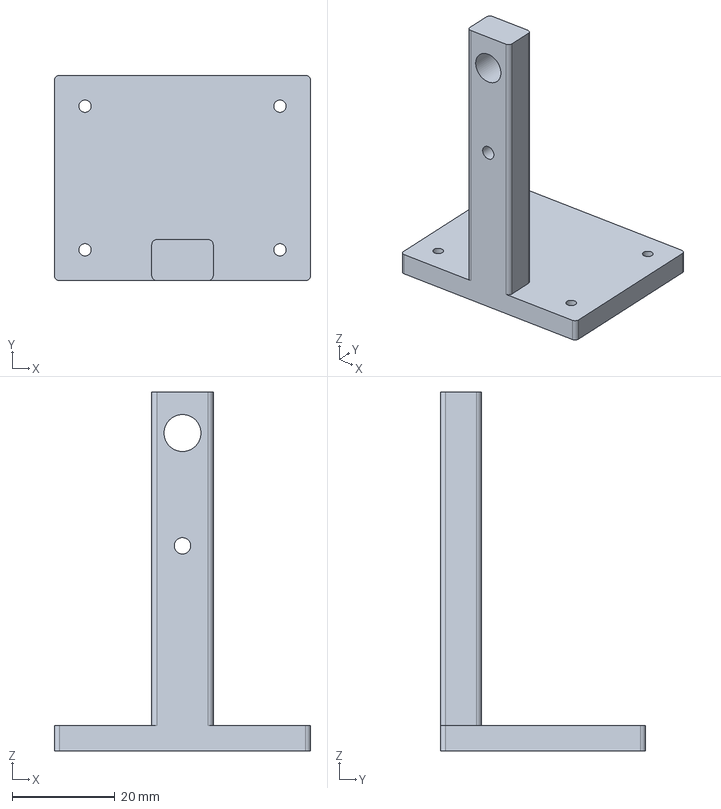
[picture p55: CAD file, 2026-10-11]
hardware/cad/step/machine/F11_dancer_pivot_post.step
50.0 x 40.0 x 70.0 mm
