Normansrule/seedforge/hardware/cad/step/reference/PR08_STANDARD_FINISHED_3TAIL_SEED_CARRIER_1TO1.step

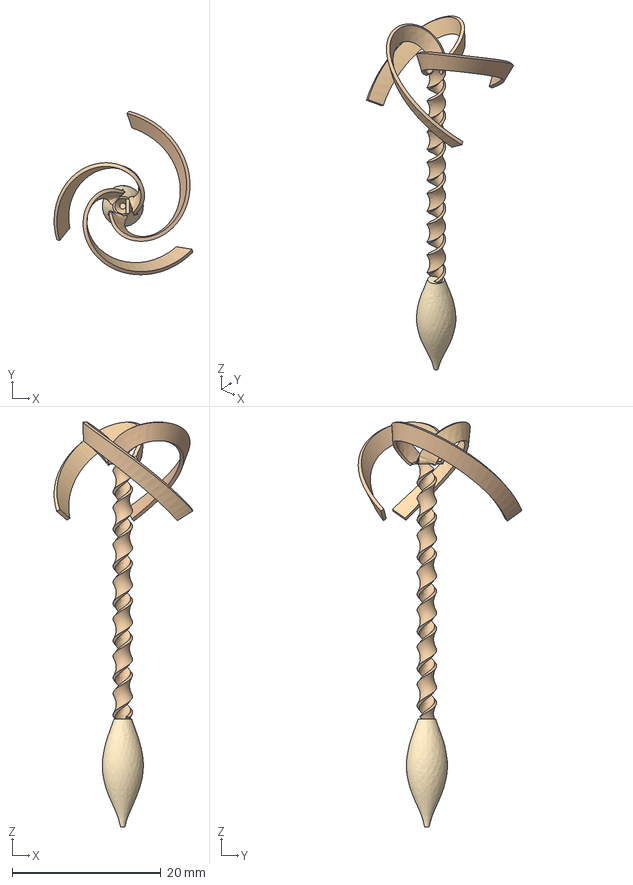
[picture p56: CAD file, 2026-10-11]
hardware/cad/step/reference/PR08_STANDARD_FINISHED_3TAIL_SEED_CARRIER_1TO1.step
18.7 x 22.0 x 54.5 mm
tail1
tail2
tail3
tip
seed
