Normansrule/seedforge/hardware/cad/step/machine/Q03_camera_led_ring_plate.step

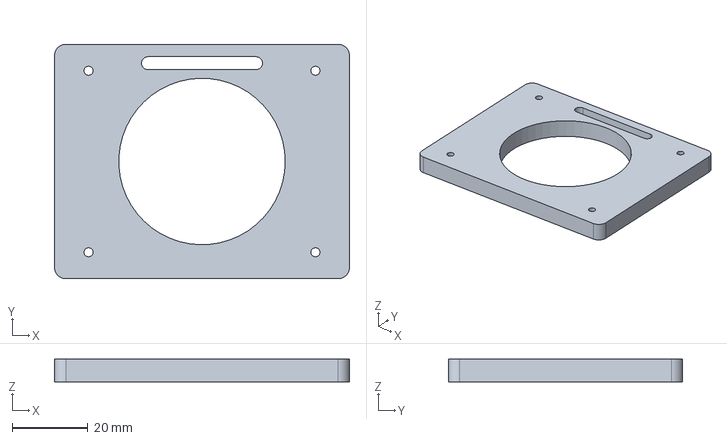
[picture p58: CAD file, 2026-10-11]
hardware/cad/step/machine/Q03_camera_led_ring_plate.step
78.0 x 62.0 x 6.00 mm
