Normansrule/seedforge/hardware/cad/step/reference/PR07_tip_hair_clearance_envelope.step

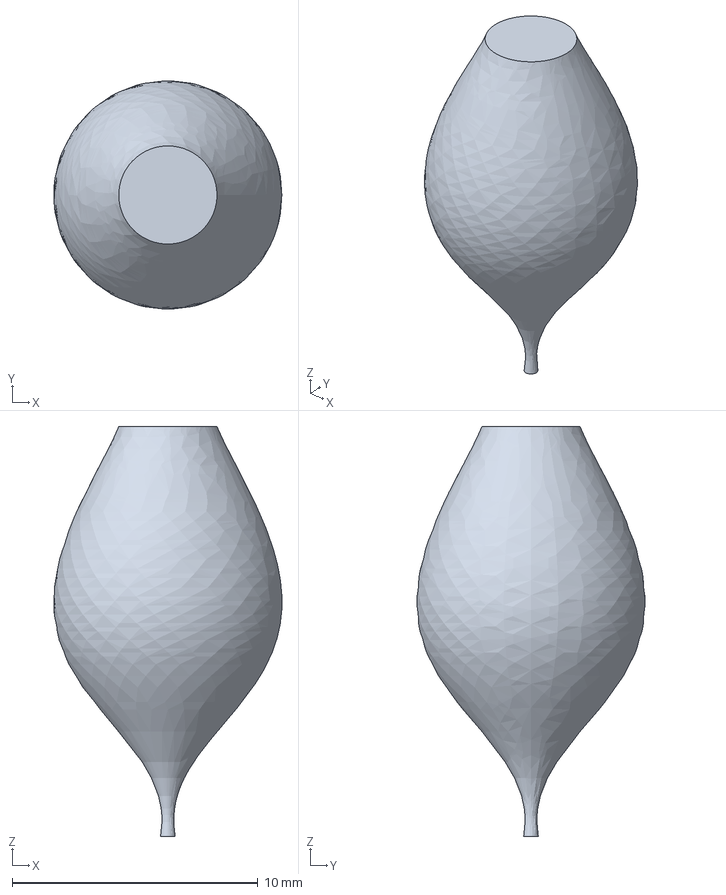
[picture p59: CAD file, 2026-10-11]
hardware/cad/step/reference/PR07_tip_hair_clearance_envelope.step
9.28 x 9.30 x 16.7 mm
