Normansrule/seedforge/hardware/cad/source/r3_step/F07_veneer_guide_lid.step

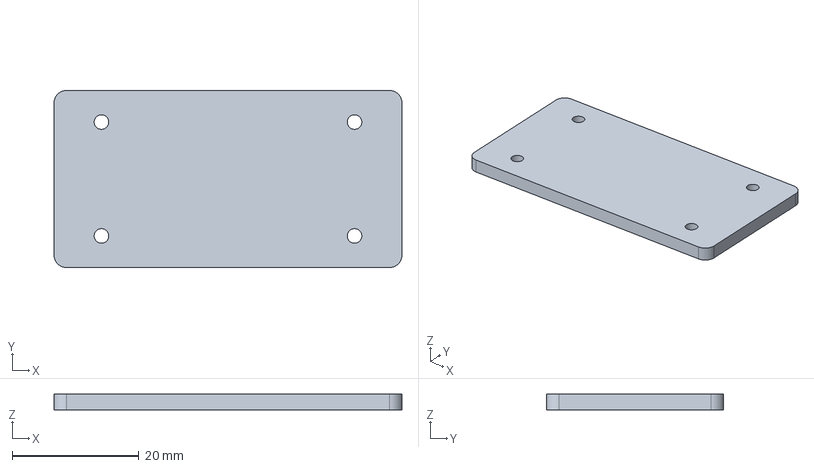
[picture p60: CAD file, 2026-10-11]
hardware/cad/source/r3_step/F07_veneer_guide_lid.step
55.0 x 28.0 x 2.50 mm
