Normansrule/seedforge/hardware/cad/step/machine/D02_single_drop_door.step

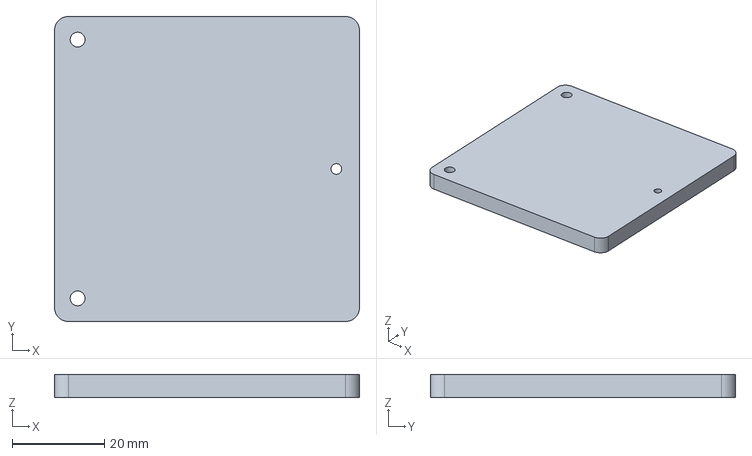
[picture p61: CAD file, 2026-10-11]
hardware/cad/step/machine/D02_single_drop_door.step
66.0 x 66.0 x 5.00 mm
