Normansrule/seedforge/hardware/cad/source/r3_step/S05_10ml_syringe_holder.step

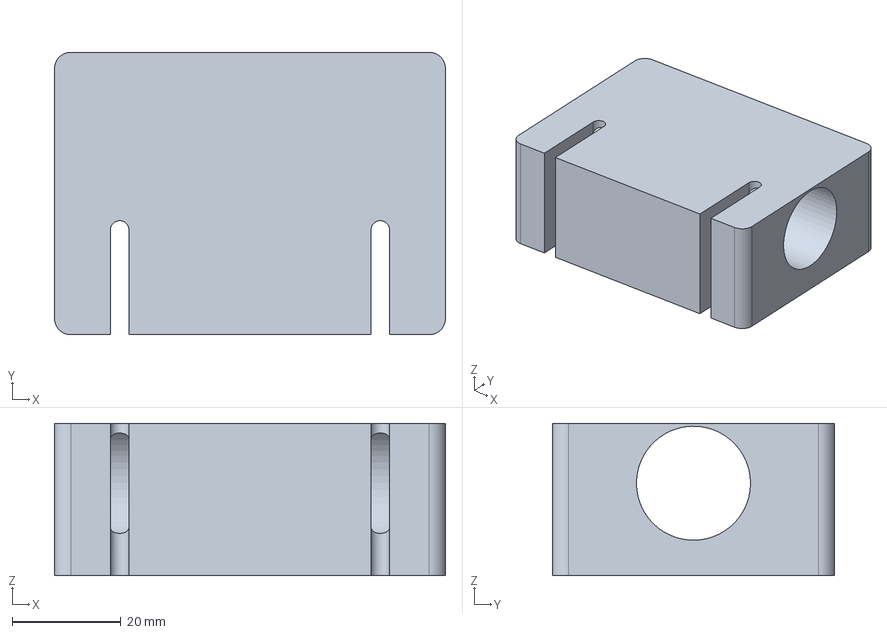
[picture p63: CAD file, 2026-10-11]
hardware/cad/source/r3_step/S05_10ml_syringe_holder.step
72.0 x 52.0 x 28.0 mm
