Normansrule/seedforge/hardware/cad/step/machine/T03_tail_sweep_shoe.step

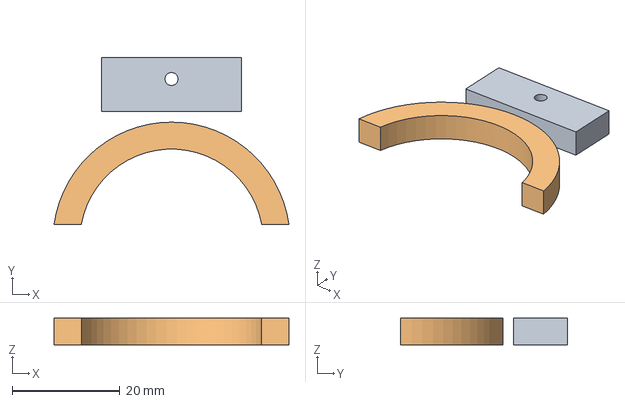
[picture p64: CAD file, 2026-10-11]
hardware/cad/step/machine/T03_tail_sweep_shoe.step
43.6 x 31.0 x 5.00 mm
