Normansrule/seedforge/hardware/cad/step/reference/PR04_standard_tail3_32p5mm.step

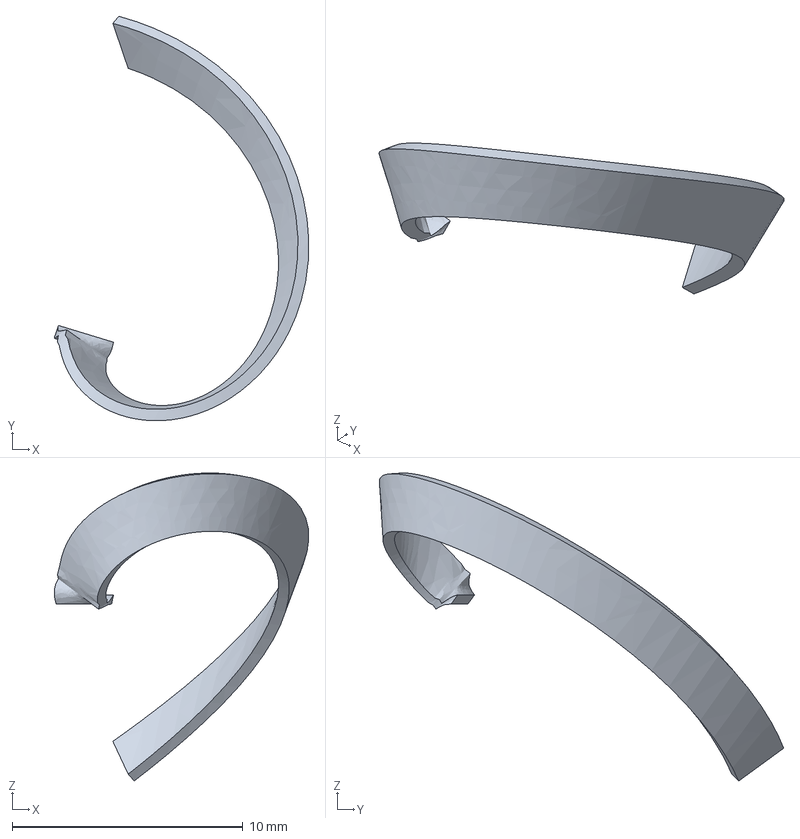
[picture p65: CAD file, 2026-10-11]
hardware/cad/step/reference/PR04_standard_tail3_32p5mm.step
11.0 x 17.5 x 13.3 mm
