Normansrule/seedforge/hardware/cad/source/r3_step/D03_payload_servo_mount.step

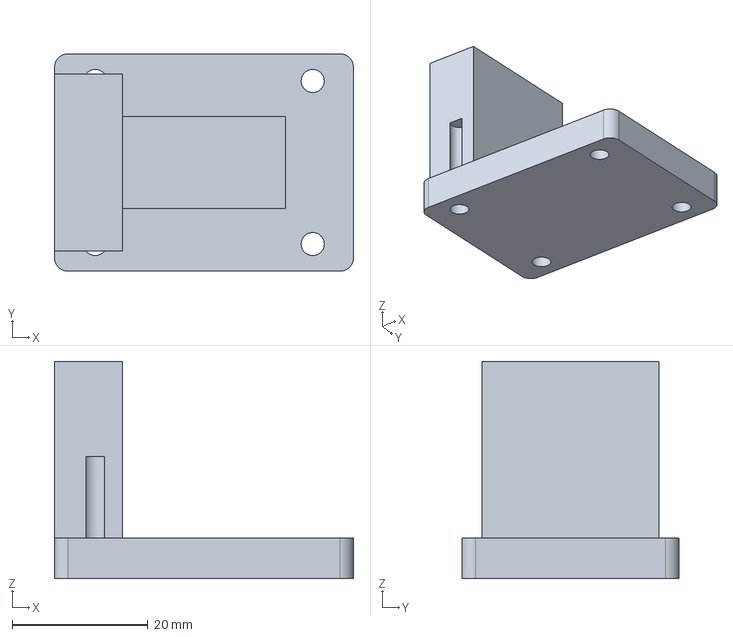
[picture p66: CAD file, 2026-10-11]
hardware/cad/source/r3_step/D03_payload_servo_mount.step
44.0 x 32.0 x 32.0 mm
