Normansrule/seedforge/hardware/cad/step/machine/W05_mandrel_end_guide.step

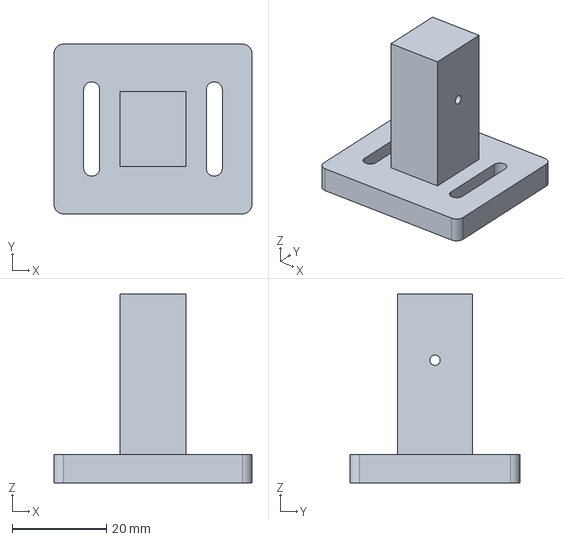
[picture p67: CAD file, 2026-10-11]
hardware/cad/step/machine/W05_mandrel_end_guide.step
42.0 x 36.0 x 40.0 mm
