Normansrule/seedforge/hardware/cad/step/reference/PR11_aux_tail_blank_29p5x2p5x0p5_reference.step

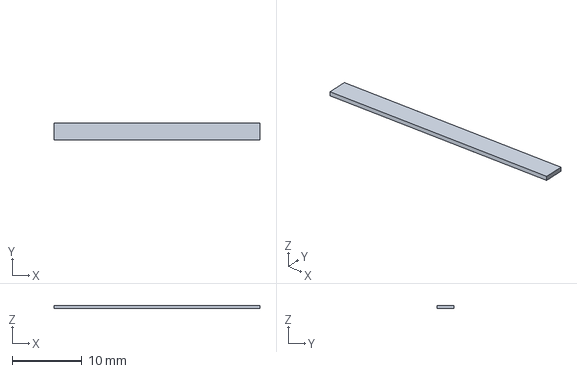
[picture p68: CAD file, 2026-10-11]
hardware/cad/step/reference/PR11_aux_tail_blank_29p5x2p5x0p5_reference.step
29.5 x 2.50 x 0.5 mm
