Normansrule/seedforge/hardware/cad/step/machine/X02_soft_clamp_jaw.step

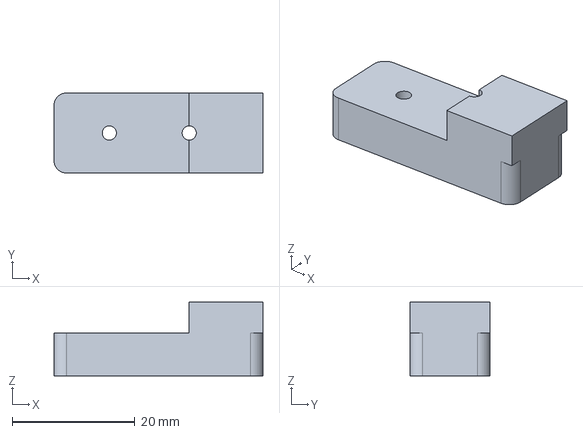
[picture p69: CAD file, 2026-10-11]
hardware/cad/step/machine/X02_soft_clamp_jaw.step
34.0 x 13.0 x 12.0 mm
