Normansrule/seedforge/hardware/cad/step/reference/MR04_0p8mm_guide_bushing.step

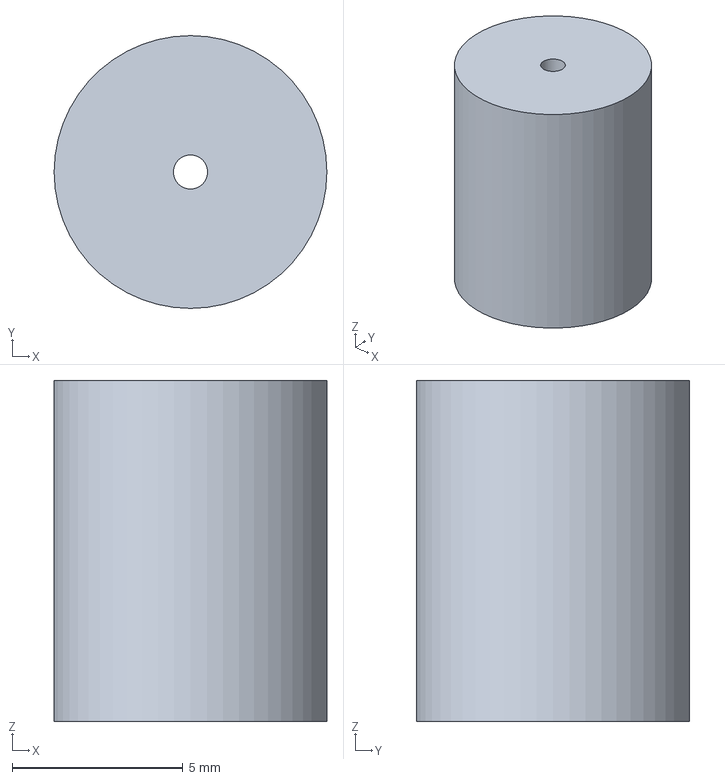
[picture p70: CAD file, 2026-10-11]
hardware/cad/step/reference/MR04_0p8mm_guide_bushing.step
8.00 x 8.00 x 10.0 mm
