Normansrule/seedforge/hardware/cad/source/r3_step/D04_payload_rail_adapter.step

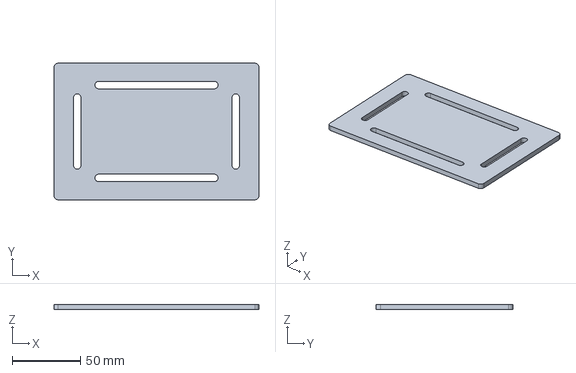
[picture p71: CAD file, 2026-10-11]
hardware/cad/source/r3_step/D04_payload_rail_adapter.step
150.0 x 100.0 x 4.00 mm
