Normansrule/seedforge/hardware/cad/step/machine/R04_vwheel_or_mgn12_carriage_adapter.step

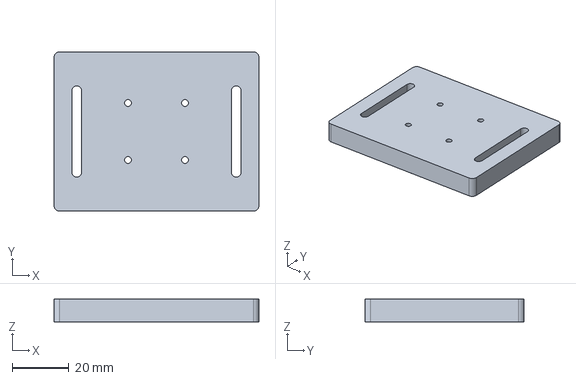
[picture p72: CAD file, 2026-10-11]
hardware/cad/step/machine/R04_vwheel_or_mgn12_carriage_adapter.step
72.0 x 56.0 x 8.00 mm
