Normansrule/seedforge/hardware/cad/step/reference/MR03_mandrel_depth_stop_M2.step

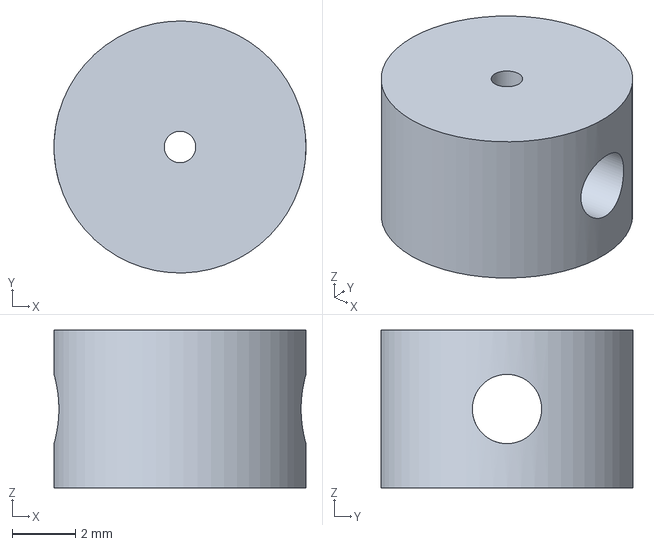
[picture p73: CAD file, 2026-10-11]
hardware/cad/step/reference/MR03_mandrel_depth_stop_M2.step
8.00 x 8.00 x 5.00 mm
