Normansrule/seedforge/hardware/cad/step/machine/T04_tail_blank_clamp.step

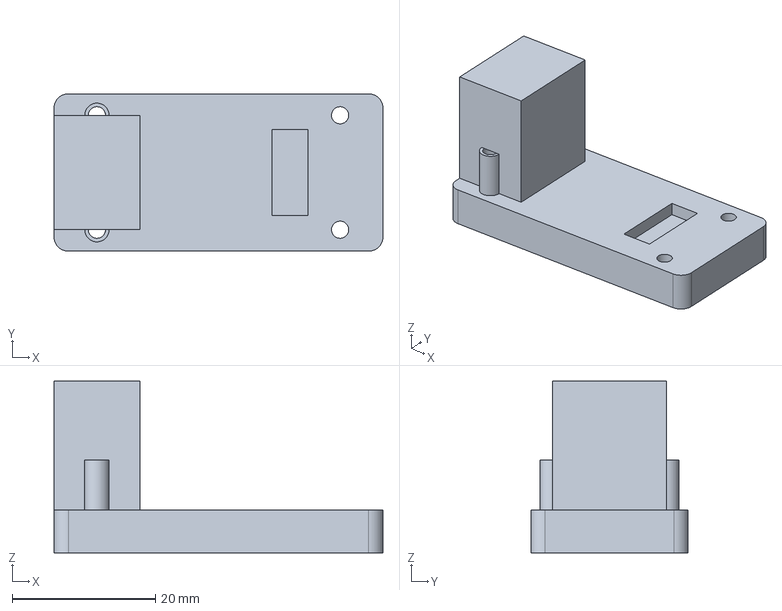
[picture p75: CAD file, 2026-10-11]
hardware/cad/step/machine/T04_tail_blank_clamp.step
46.0 x 22.0 x 24.0 mm
