Normansrule/seedforge/hardware/cad/step/reference/PR23_LARGE_PINE_BODY_TIP_SEED_REFERENCE_NO_TAILS.step

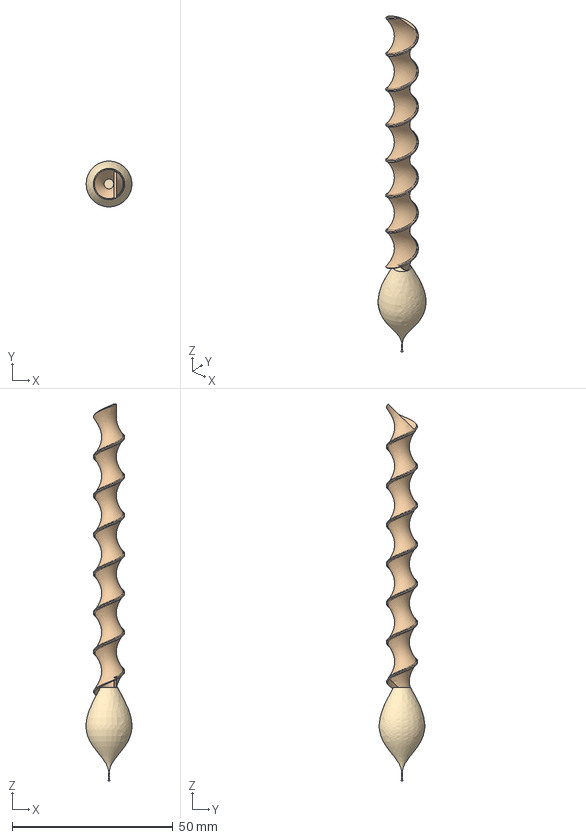
[picture p76: CAD file, 2026-10-11]
hardware/cad/step/reference/PR23_LARGE_PINE_BODY_TIP_SEED_REFERENCE_NO_TAILS.step
14.3 x 14.3 x 117.2 mm
tip
seed
