Normansrule/seedforge/hardware/cad/source/r3_step/S03_28byj_seed_indexer_mount.step

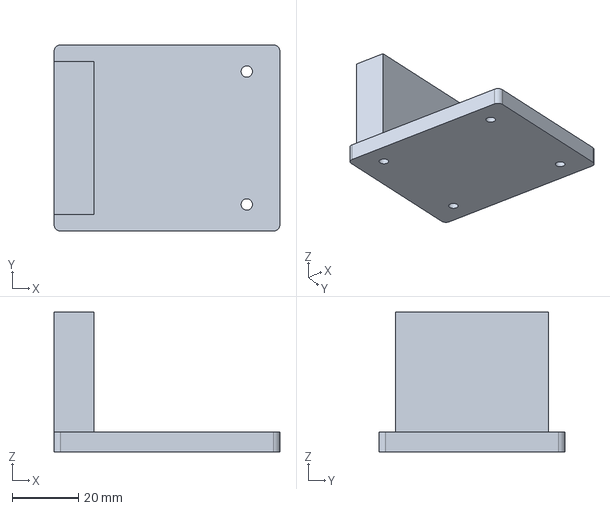
[picture p77: CAD file, 2026-10-11]
hardware/cad/source/r3_step/S03_28byj_seed_indexer_mount.step
68.0 x 56.0 x 42.0 mm
