Normansrule/seedforge/hardware/cad/step/reference/MR05_3mm_x140mm_LARGE_PINE_MANDREL_REFERENCE.step

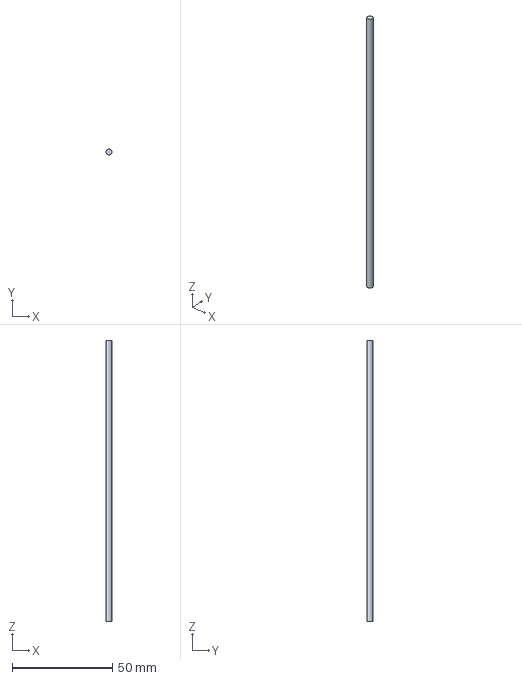
[picture p78: CAD file, 2026-10-11]
hardware/cad/step/reference/MR05_3mm_x140mm_LARGE_PINE_MANDREL_REFERENCE.step
3.00 x 3.00 x 140.0 mm
