Normansrule/seedforge/hardware/cad/source/r3_step/Z01_fit_calibration_coupon.step

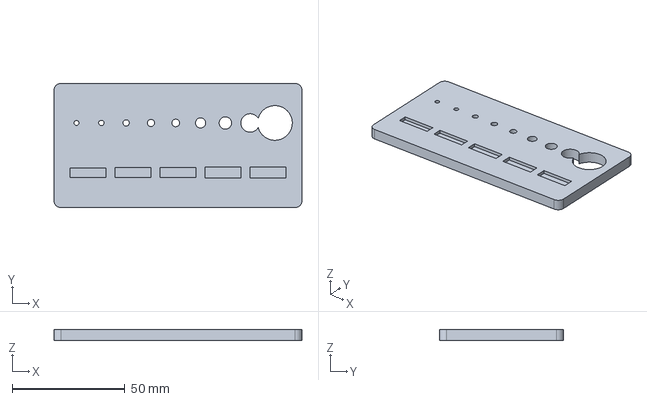
[picture p79: CAD file, 2026-10-11]
hardware/cad/source/r3_step/Z01_fit_calibration_coupon.step
110.0 x 55.0 x 5.00 mm
