Normansrule/seedforge/hardware/cad/step/machine/R02_sg90_gripper_body.step

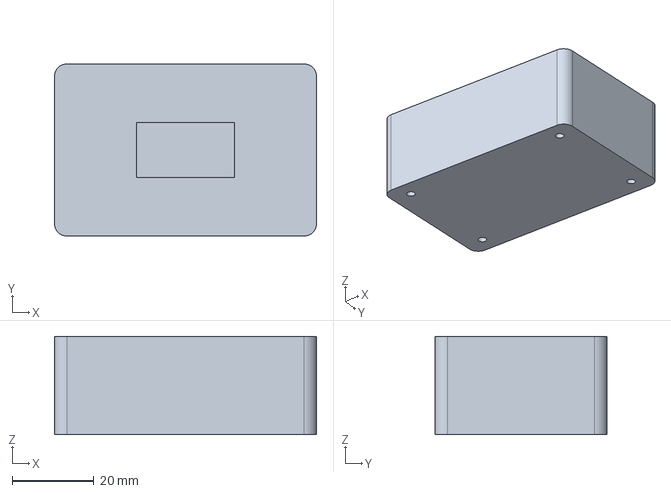
[picture p80: CAD file, 2026-10-11]
hardware/cad/step/machine/R02_sg90_gripper_body.step
64.0 x 42.0 x 24.0 mm
