Normansrule/seedforge/hardware/cad/step/reference/PR01_standard_7coil_body_2p5x0p5_on_0p8.step

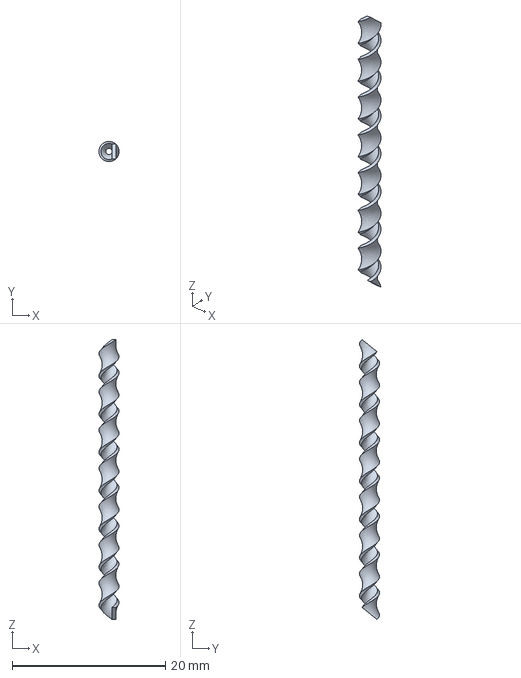
[picture p81: CAD file, 2026-10-11]
hardware/cad/step/reference/PR01_standard_7coil_body_2p5x0p5_on_0p8.step
2.64 x 2.64 x 36.6 mm
