Normansrule/seedforge/hardware/cad/source/r3_step/W07_micro_release_clamp_lower.step

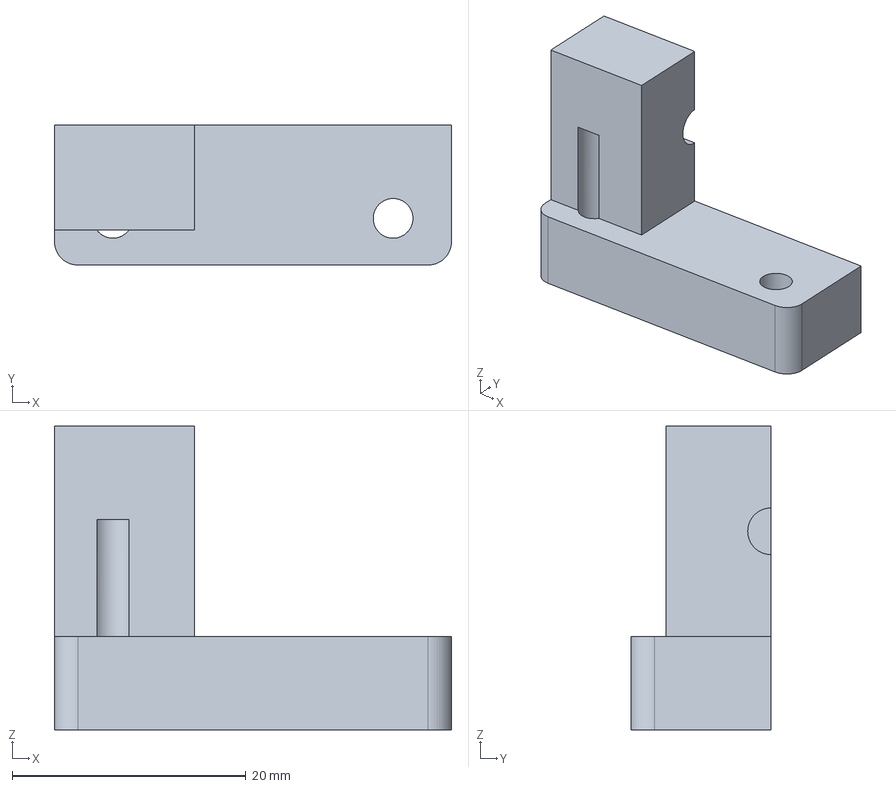
[picture p82: CAD file, 2026-10-11]
hardware/cad/source/r3_step/W07_micro_release_clamp_lower.step
34.0 x 12.0 x 26.0 mm
