Normansrule/seedforge/hardware/cad/step/reference/MR02_0p8mm_to_5mm_split_collet_INSERT.step

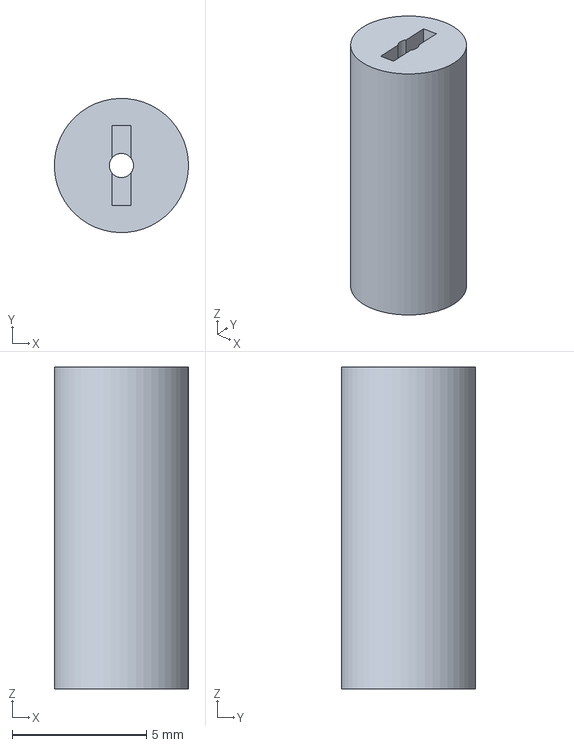
[picture p83: CAD file, 2026-10-11]
hardware/cad/step/reference/MR02_0p8mm_to_5mm_split_collet_INSERT.step
5.00 x 5.00 x 12.0 mm
