Normansrule/seedforge/hardware/cad/step/machine/F03_spool_hub.step

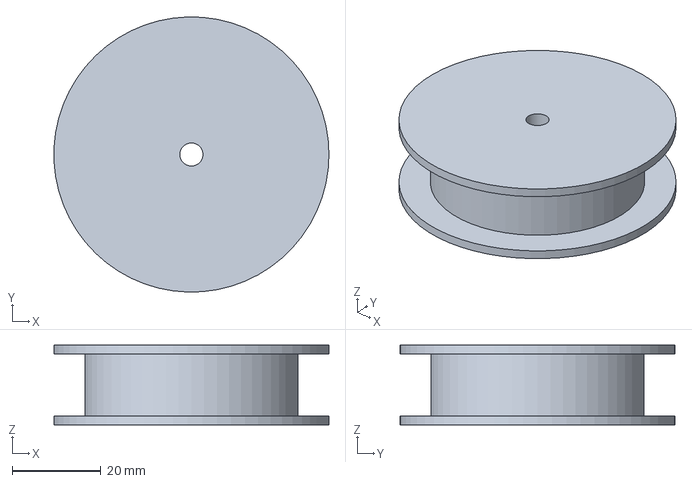
[picture p84: CAD file, 2026-10-11]
hardware/cad/step/machine/F03_spool_hub.step
62.0 x 62.0 x 18.0 mm
