Normansrule/seedforge/hardware/cad/step/reference/PR02_standard_tail1_27mm.step

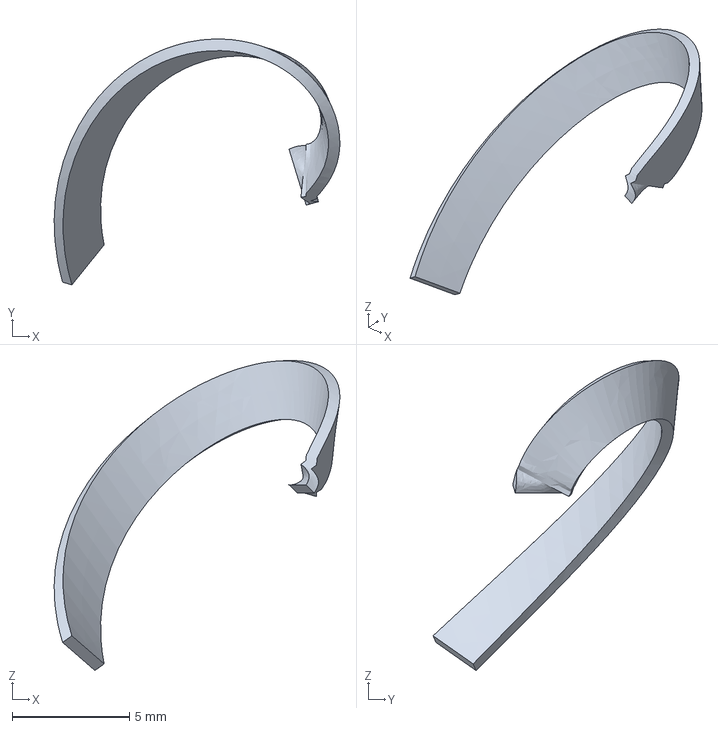
[picture p85: CAD file, 2026-10-11]
hardware/cad/step/reference/PR02_standard_tail1_27mm.step
12.2 x 10.5 x 13.2 mm
