Normansrule/seedforge/hardware/cad/source/r3_step/W06_camera_tilt_mount.step

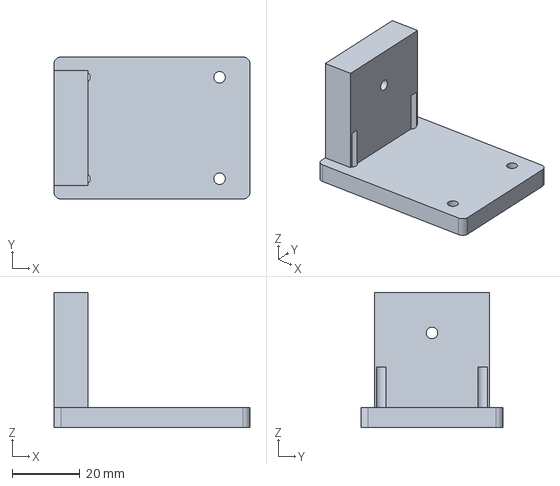
[picture p86: CAD file, 2026-10-11]
hardware/cad/source/r3_step/W06_camera_tilt_mount.step
58.0 x 42.0 x 40.0 mm
