Normansrule/seedforge/hardware/cad/step/reference/PR09_STANDARD_SEED_CARRIER_EXPLODED_1TO1.step

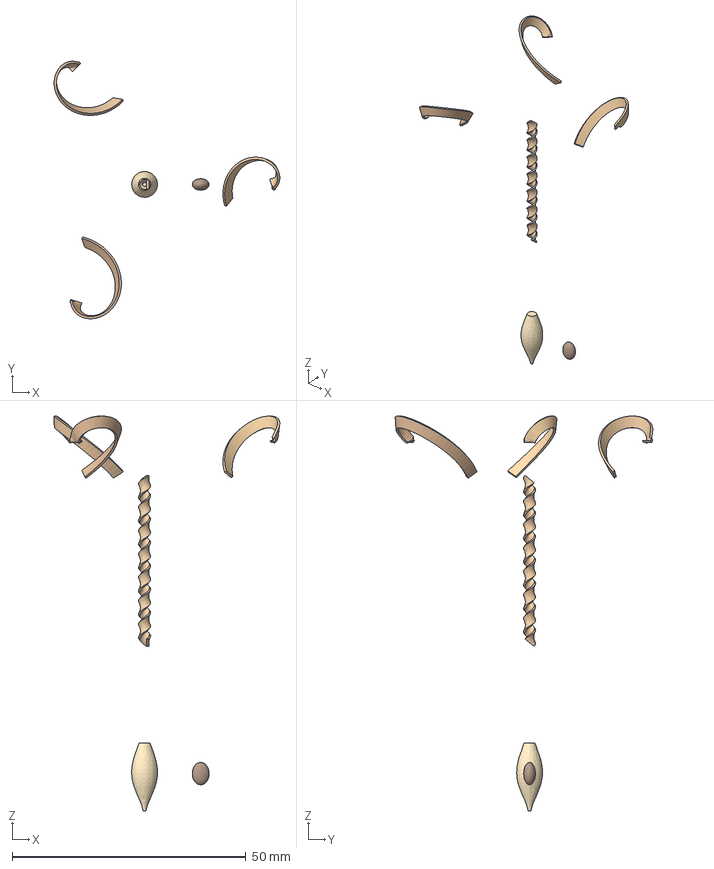
[picture p87: CAD file, 2026-10-11]
hardware/cad/step/reference/PR09_STANDARD_SEED_CARRIER_EXPLODED_1TO1.step
48.3 x 55.1 x 84.5 mm
tail1
tail2
tail3
tip
seed
