Normansrule/seedforge/hardware/cad/source/r3_step/O01_finished_seedpod_tray_12.step

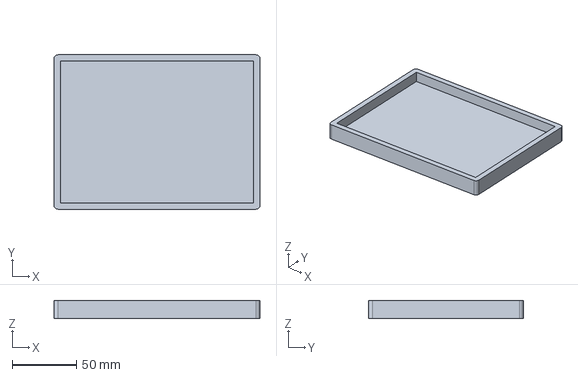
[picture p88: CAD file, 2026-10-11]
hardware/cad/source/r3_step/O01_finished_seedpod_tray_12.step
160.0 x 120.0 x 14.0 mm
