Normansrule/seedforge/hardware/cad/step/machine/Q02_120mm_usb_fan_bracket.step

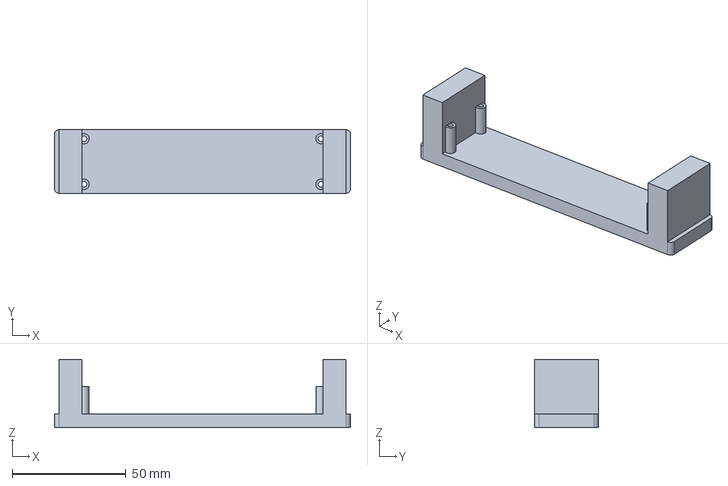
[picture p89: CAD file, 2026-10-11]
hardware/cad/step/machine/Q02_120mm_usb_fan_bracket.step
130.0 x 28.0 x 30.0 mm
