Normansrule/seedforge/hardware/cad/step/reference/MR01_0p8mm_x100mm_FORMING_MANDREL_REFERENCE.step

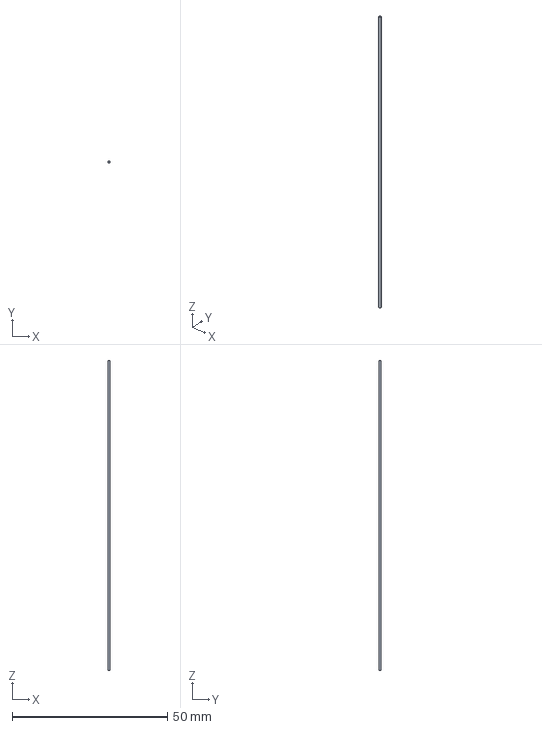
[picture p90: CAD file, 2026-10-11]
hardware/cad/step/reference/MR01_0p8mm_x100mm_FORMING_MANDREL_REFERENCE.step
0.799 x 0.8 x 100.0 mm
