Normansrule/seedforge/hardware/cad/step/machine/R03_soft_gripper_finger.step

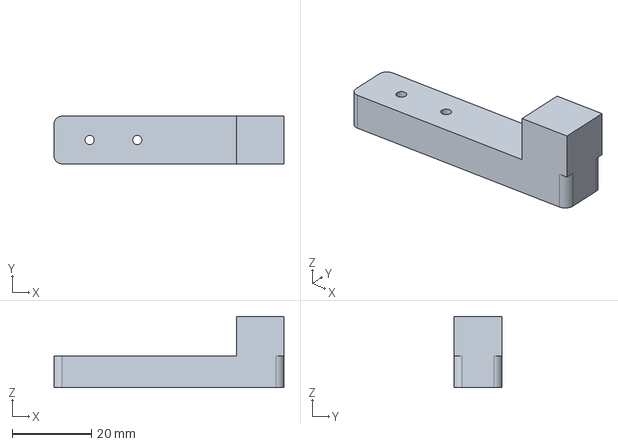
[picture p91: CAD file, 2026-10-11]
hardware/cad/step/machine/R03_soft_gripper_finger.step
58.0 x 12.0 x 18.0 mm
