Normansrule/seedforge/hardware/cad/source/r3_step/X03_guarded_shear_mount.step

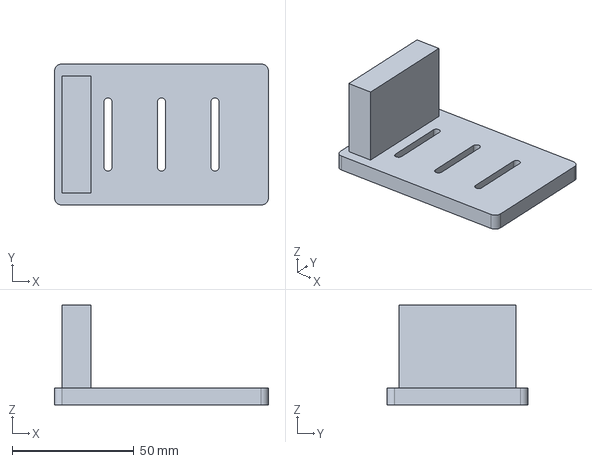
[picture p92: CAD file, 2026-10-11]
hardware/cad/source/r3_step/X03_guarded_shear_mount.step
88.0 x 58.0 x 41.0 mm
