Normansrule/seedforge/hardware/cad/step/machine/R07_xy_tool_carriage.step

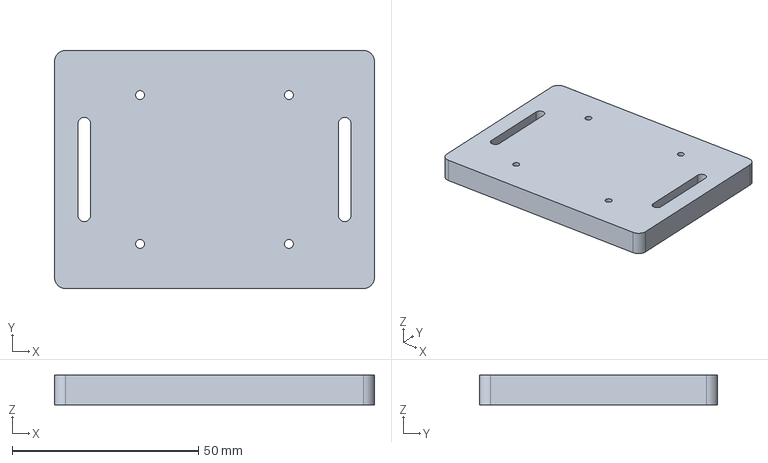
[picture p93: CAD file, 2026-10-11]
hardware/cad/step/machine/R07_xy_tool_carriage.step
86.0 x 64.0 x 8.00 mm
