Normansrule/seedforge/hardware/cad/source/r3_step/C04_electronics_vented_lid.step

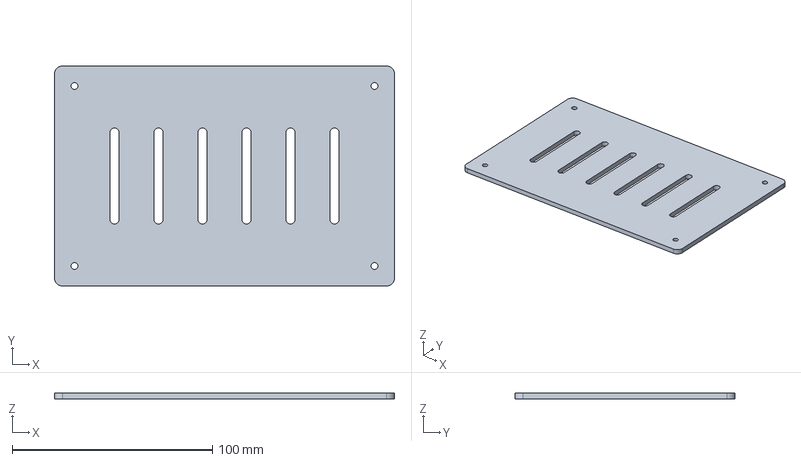
[picture p94: CAD file, 2026-10-11]
hardware/cad/source/r3_step/C04_electronics_vented_lid.step
170.0 x 110.0 x 3.00 mm
