Normansrule/seedforge/hardware/cad/step/machine/F02_spool_stand_right.step

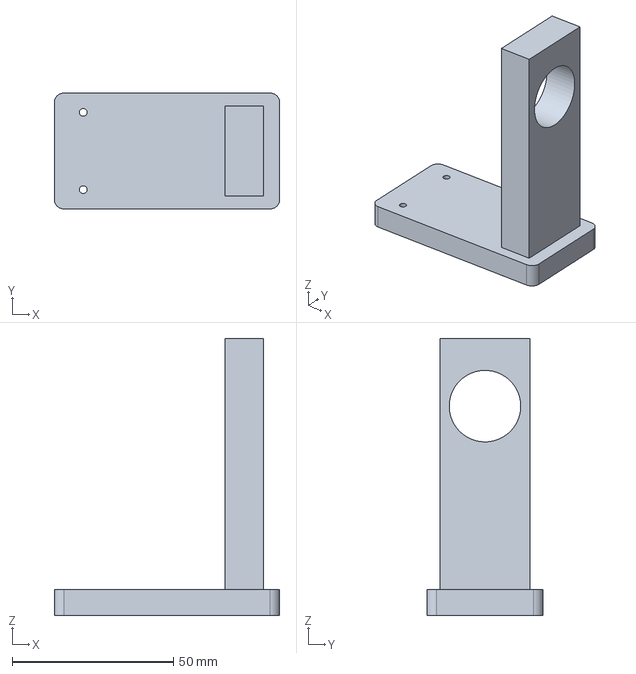
[picture p95: CAD file, 2026-10-11]
hardware/cad/step/machine/F02_spool_stand_right.step
70.0 x 36.0 x 86.0 mm
