Normansrule/seedforge/hardware/cad/source/r3_step/T04_tail_blank_clamp.step

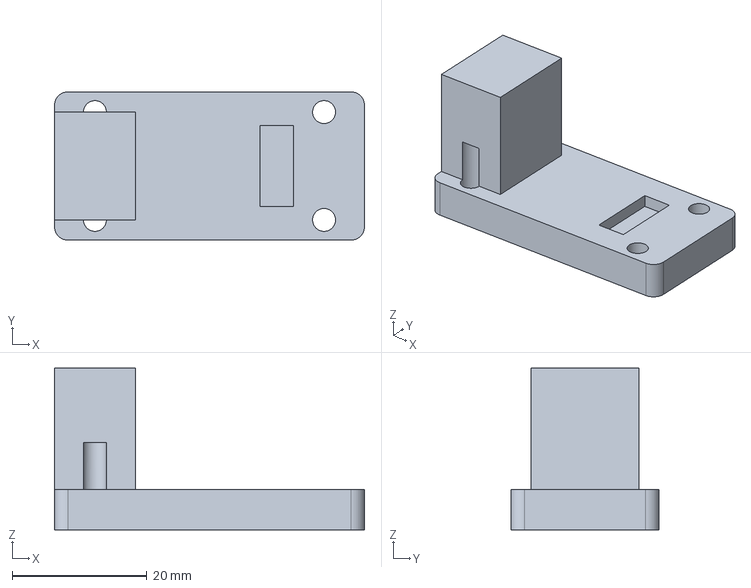
[picture p96: CAD file, 2026-10-11]
hardware/cad/source/r3_step/T04_tail_blank_clamp.step
46.0 x 22.0 x 24.0 mm
