Normansrule/seedforge/hardware/cad/source/r3_step/C01_module_base_160x120.step

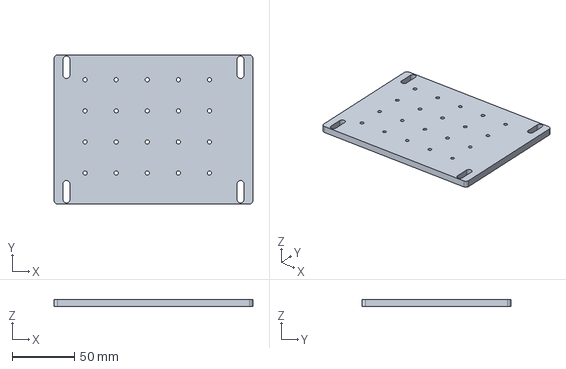
[picture p97: CAD file, 2026-10-11]
hardware/cad/source/r3_step/C01_module_base_160x120.step
160.0 x 120.0 x 6.00 mm
