Normansrule/seedforge/hardware/cad/source/r3_step/Q02_120mm_usb_fan_bracket.step

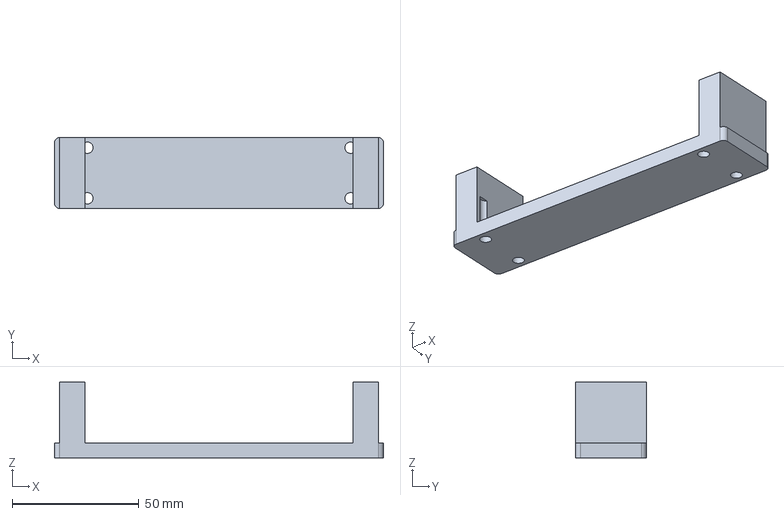
[picture p98: CAD file, 2026-10-11]
hardware/cad/source/r3_step/Q02_120mm_usb_fan_bracket.step
130.0 x 28.0 x 30.0 mm
