Normansrule/seedforge/hardware/cad/step/machine/R06_gt2_idler_corner_mount.step

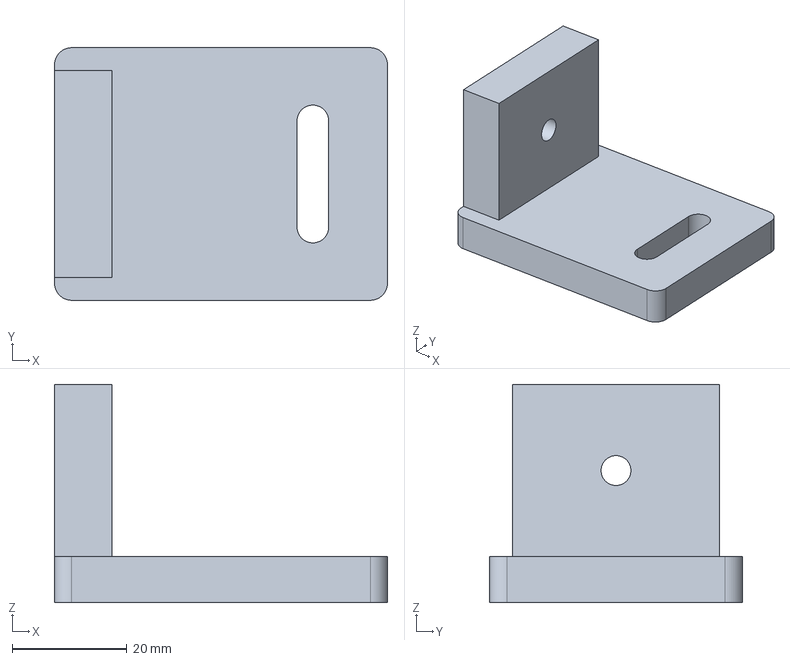
[picture p99: CAD file, 2026-10-11]
hardware/cad/step/machine/R06_gt2_idler_corner_mount.step
58.0 x 44.0 x 38.0 mm
