Normansrule/seedforge/hardware/cad/step/machine/F04_dancer_arm.step

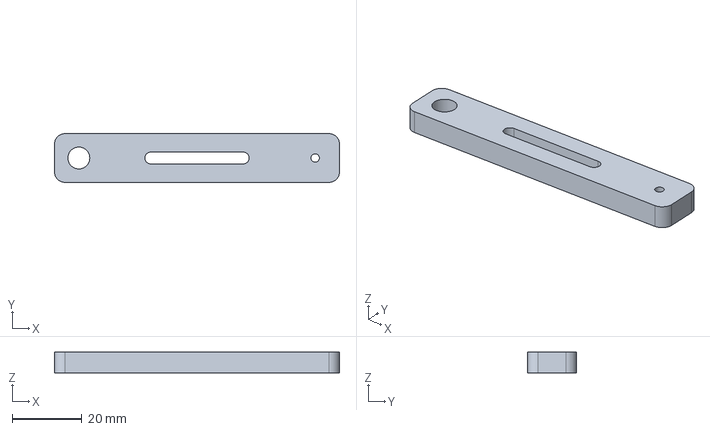
[picture p100: CAD file, 2026-10-11]
hardware/cad/step/machine/F04_dancer_arm.step
82.0 x 14.0 x 6.00 mm
