Normansrule/seedforge/hardware/cad/step/machine/W18_camera_arm.step

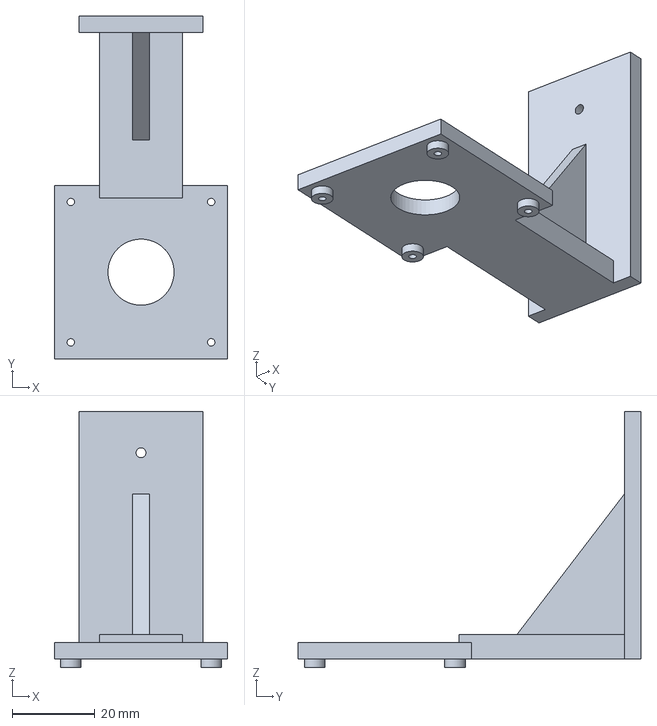
[picture p101: CAD file, 2026-10-11]
hardware/cad/step/machine/W18_camera_arm.step
42.0 x 83.0 x 62.0 mm
