Normansrule/seedforge/hardware/cad/source/r3_step/R01_gantry_tool_plate.step

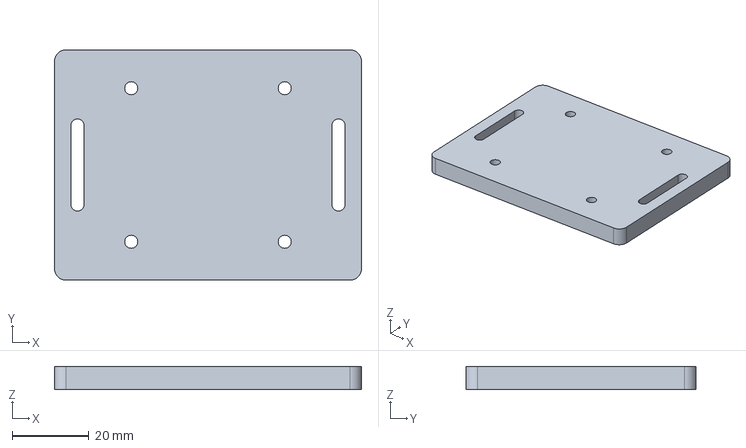
[picture p102: CAD file, 2026-10-11]
hardware/cad/source/r3_step/R01_gantry_tool_plate.step
80.0 x 60.0 x 6.00 mm
