Normansrule/seedforge/hardware/cad/step/machine/S02_seed_singulator_disk_6mm.step

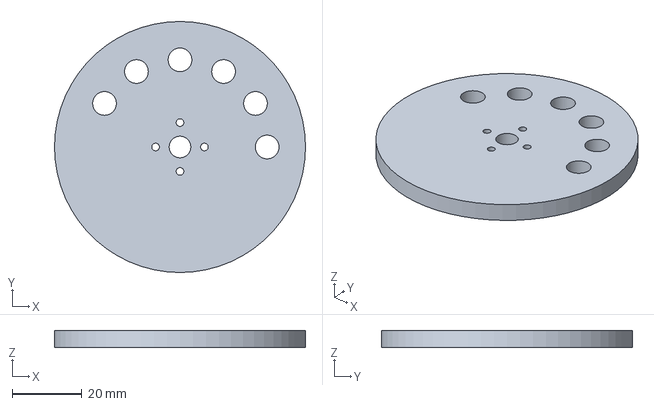
[picture p103: CAD file, 2026-10-11]
hardware/cad/step/machine/S02_seed_singulator_disk_6mm.step
72.0 x 72.0 x 5.00 mm
