Normansrule/seedforge/hardware/cad/step/machine/W09_linear_motor_end_block.step

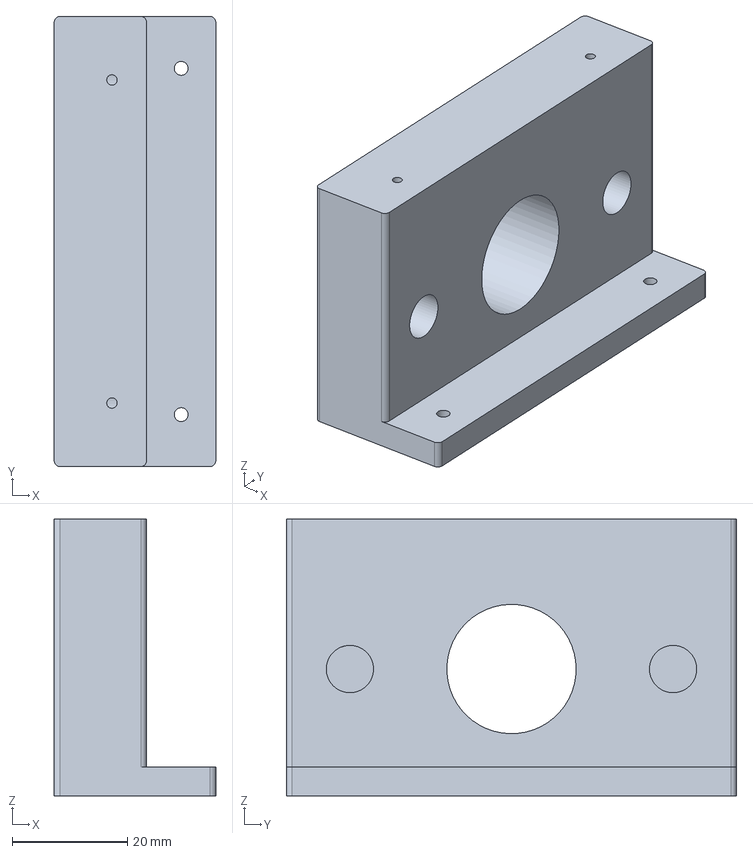
[picture p104: CAD file, 2026-10-11]
hardware/cad/step/machine/W09_linear_motor_end_block.step
28.0 x 78.0 x 48.0 mm
