Normansrule/seedforge/hardware/cad/source/r3_step/W01_nema17_rotation_mount.step

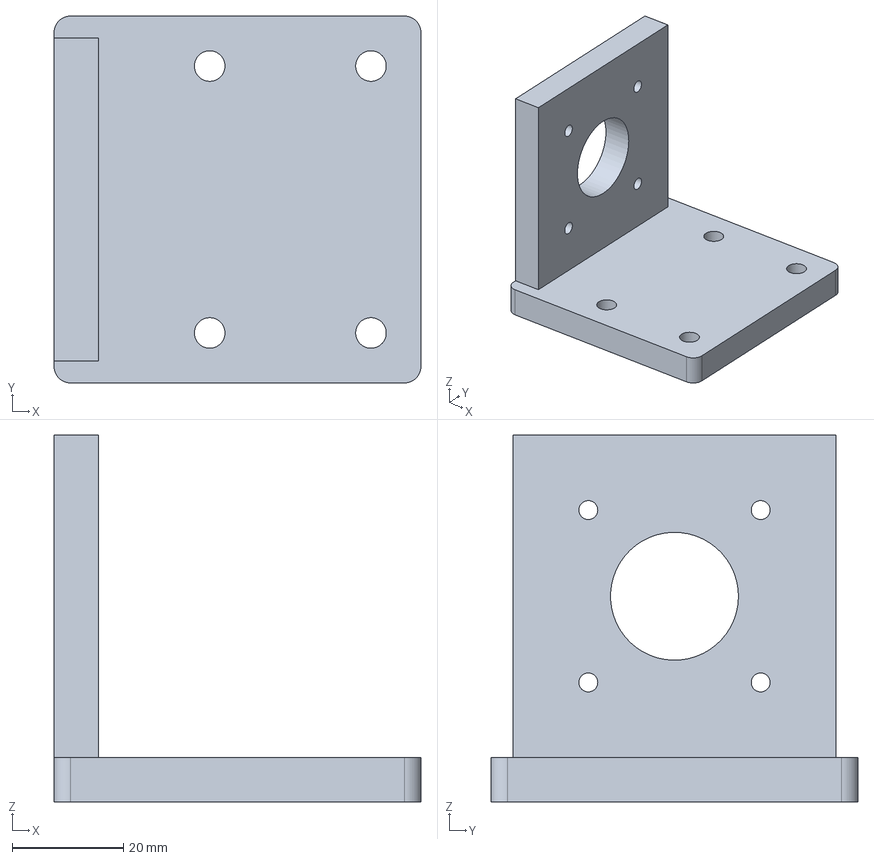
[picture p105: CAD file, 2026-10-11]
hardware/cad/source/r3_step/W01_nema17_rotation_mount.step
66.0 x 66.0 x 66.0 mm
