Normansrule/seedforge/hardware/cad/step/machine/X04_cutter_guard.step

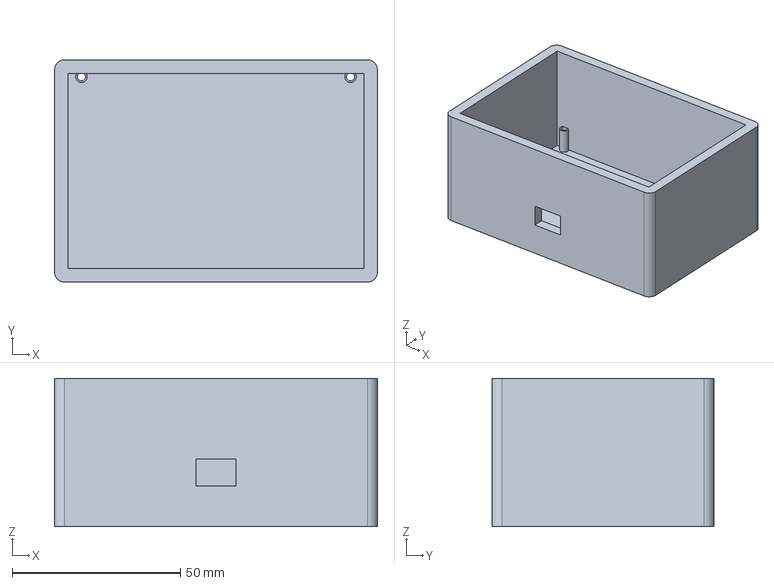
[picture p106: CAD file, 2026-10-11]
hardware/cad/step/machine/X04_cutter_guard.step
96.0 x 66.0 x 44.0 mm
