Normansrule/seedforge/hardware/cad/source/r3_step/X04_cutter_guard.step

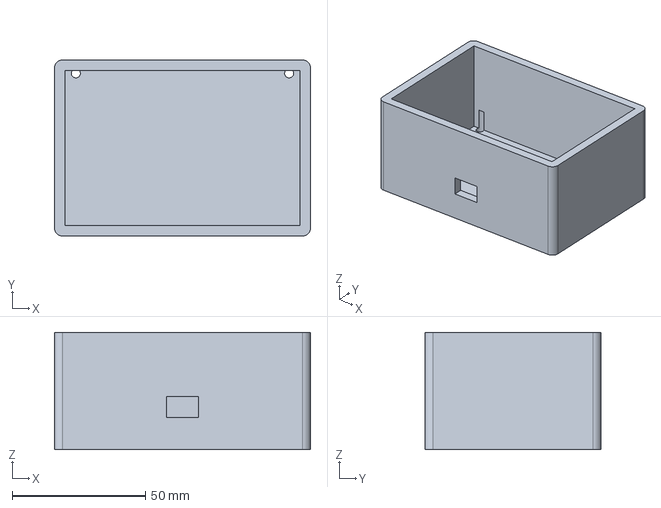
[picture p107: CAD file, 2026-10-11]
hardware/cad/source/r3_step/X04_cutter_guard.step
96.0 x 66.0 x 44.0 mm
