Normansrule/seedforge/hardware/cad/source/r3_step/Q03_camera_led_ring_plate.step

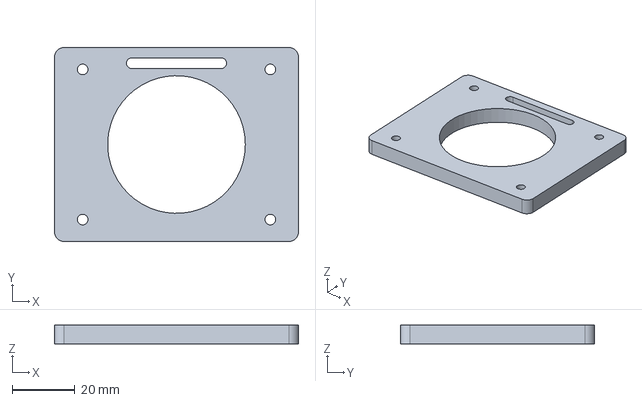
[picture p108: CAD file, 2026-10-11]
hardware/cad/source/r3_step/Q03_camera_led_ring_plate.step
78.0 x 62.0 x 6.00 mm
