Normansrule/seedforge/hardware/cad/source/r3_step/R05_gt2_nema17_corner_mount.step

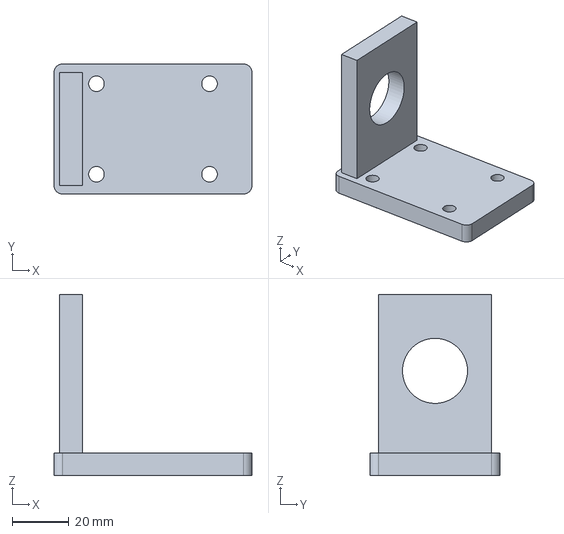
[picture p109: CAD file, 2026-10-11]
hardware/cad/source/r3_step/R05_gt2_nema17_corner_mount.step
70.0 x 46.0 x 64.0 mm
