Normansrule/seedforge/hardware/cad/step/machine/F13_load_cell_clamp_cap.step

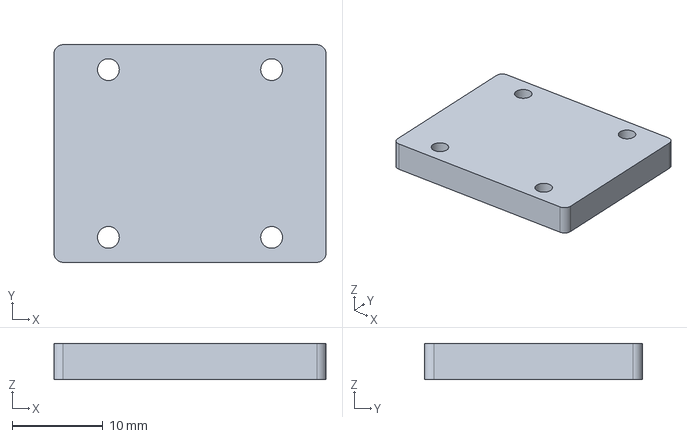
[picture p111: CAD file, 2026-10-11]
hardware/cad/step/machine/F13_load_cell_clamp_cap.step
30.0 x 24.0 x 4.00 mm
