Normansrule/seedforge/hardware/cad/step/machine/C02_cable_clip_dual.step

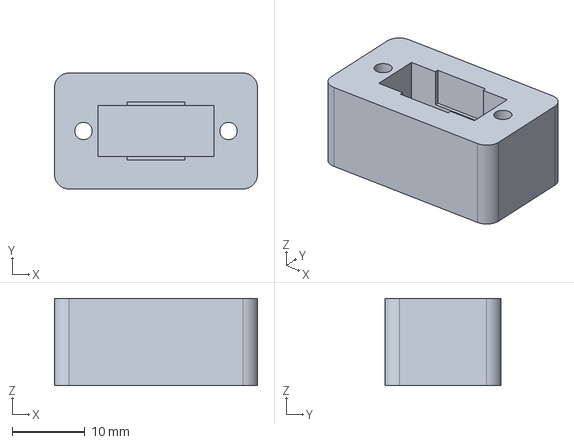
[picture p112: CAD file, 2026-10-11]
hardware/cad/step/machine/C02_cable_clip_dual.step
28.0 x 16.0 x 12.0 mm
