Normansrule/seedforge/hardware/cad/source/r3_step/Q01_free_dry_tray.step

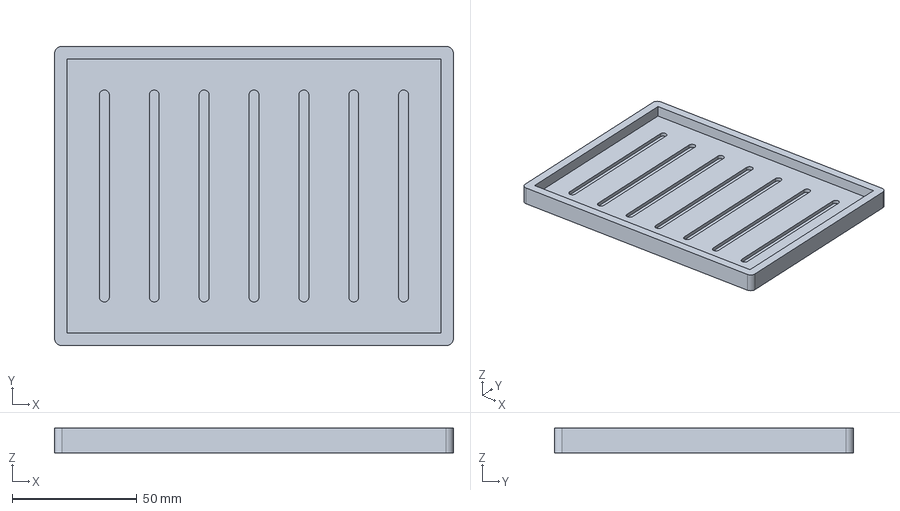
[picture p114: CAD file, 2026-10-11]
hardware/cad/source/r3_step/Q01_free_dry_tray.step
160.0 x 120.0 x 10.0 mm
