Normansrule/seedforge/hardware/cad/step/machine/W17_camera_mast_foot.step

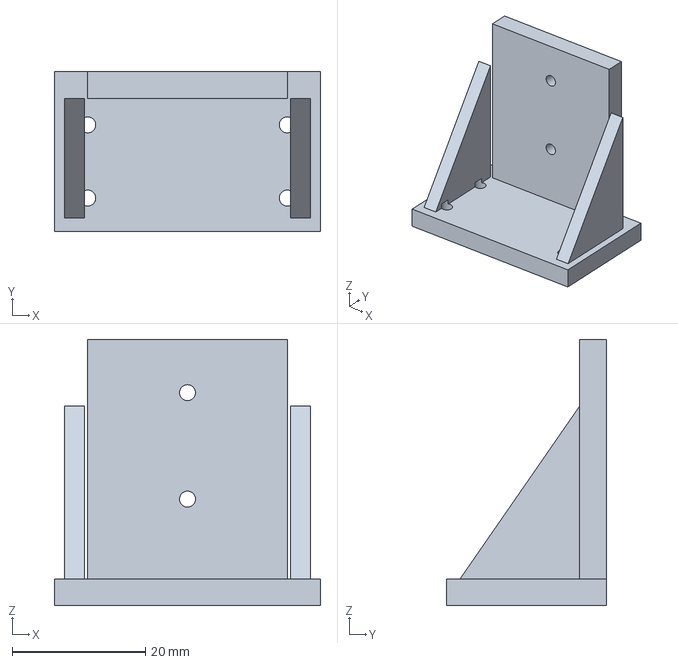
[picture p115: CAD file, 2026-10-11]
hardware/cad/step/machine/W17_camera_mast_foot.step
40.0 x 24.0 x 40.0 mm
