Normansrule/seedforge/hardware/cad/step/machine/F08_load_cell_mount.step

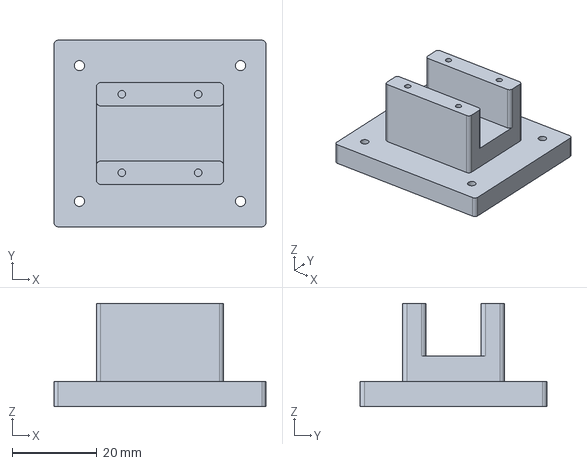
[picture p116: CAD file, 2026-10-11]
hardware/cad/step/machine/F08_load_cell_mount.step
50.0 x 44.0 x 24.4 mm
