Normansrule/seedforge/hardware/cad/step/machine/W13_w05_axis_riser_11mm.step

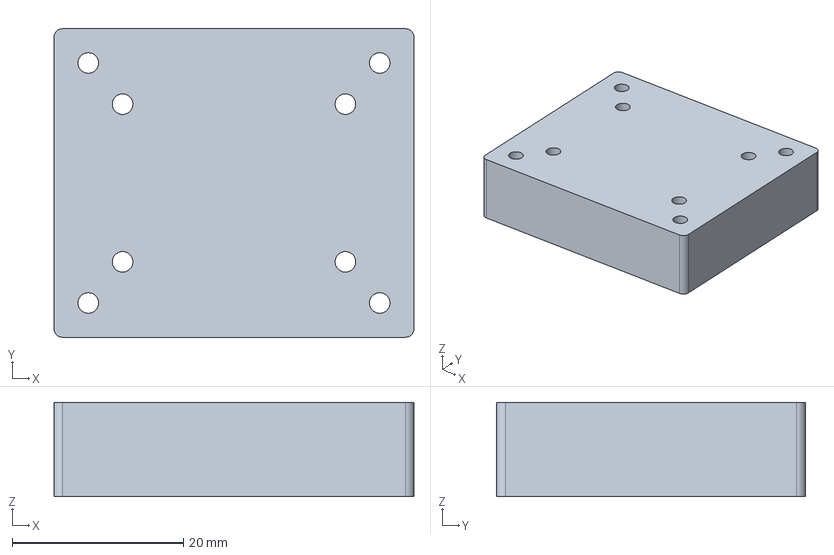
[picture p117: CAD file, 2026-10-11]
hardware/cad/step/machine/W13_w05_axis_riser_11mm.step
42.0 x 36.0 x 11.0 mm
