Normansrule/seedforge/hardware/cad/step/machine/W14_limit_switch_rod_clamp.step

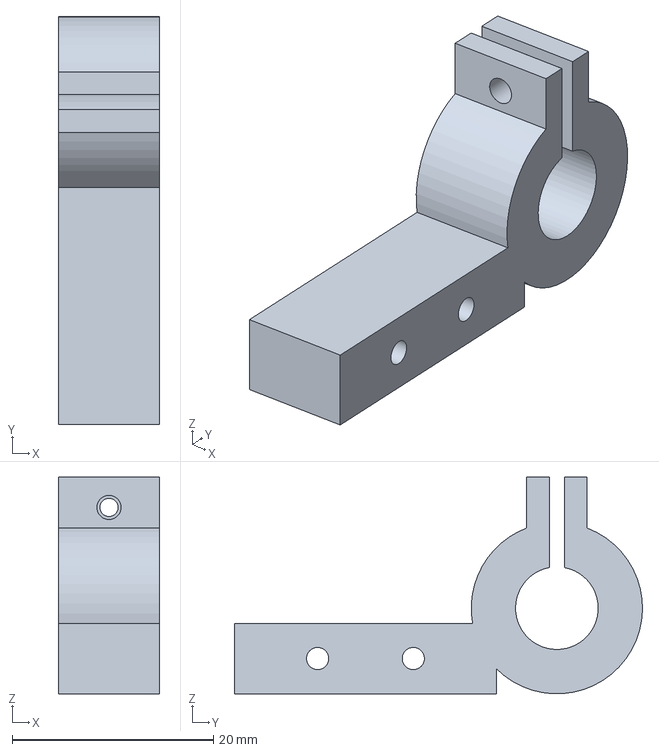
[picture p118: CAD file, 2026-10-11]
hardware/cad/step/machine/W14_limit_switch_rod_clamp.step
10.0 x 40.5 x 21.5 mm
