Normansrule/seedforge/hardware/cad/step/machine/W16_nema17_body_clamp_linear.step

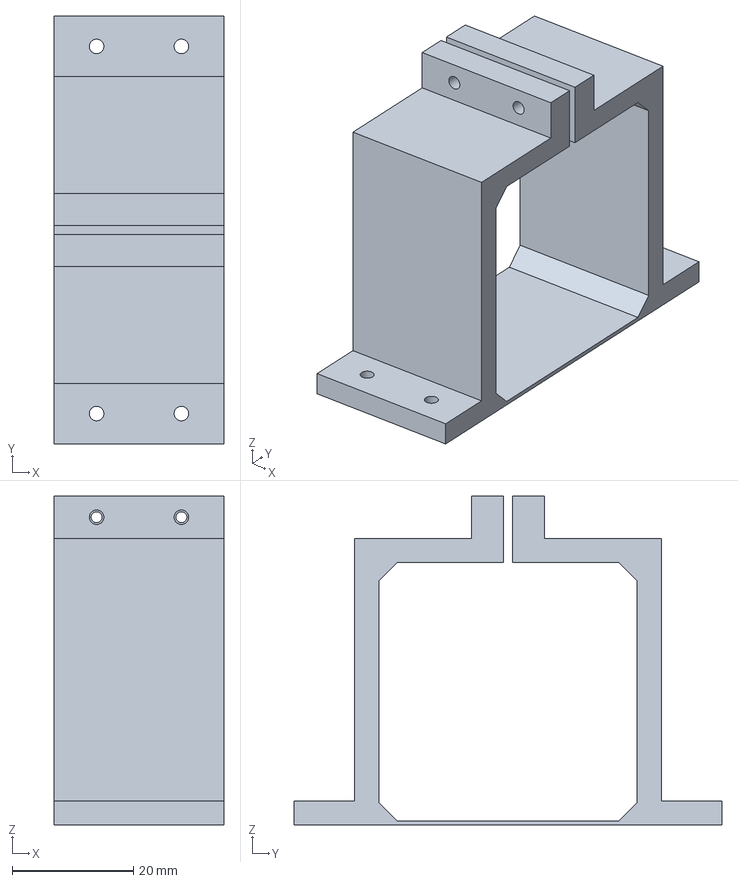
[picture p119: CAD file, 2026-10-11]
hardware/cad/step/machine/W16_nema17_body_clamp_linear.step
28.0 x 70.6 x 54.3 mm
