Normansrule/seedforge/hardware/cad/step/machine/S06_syringe_plunger_carriage.step

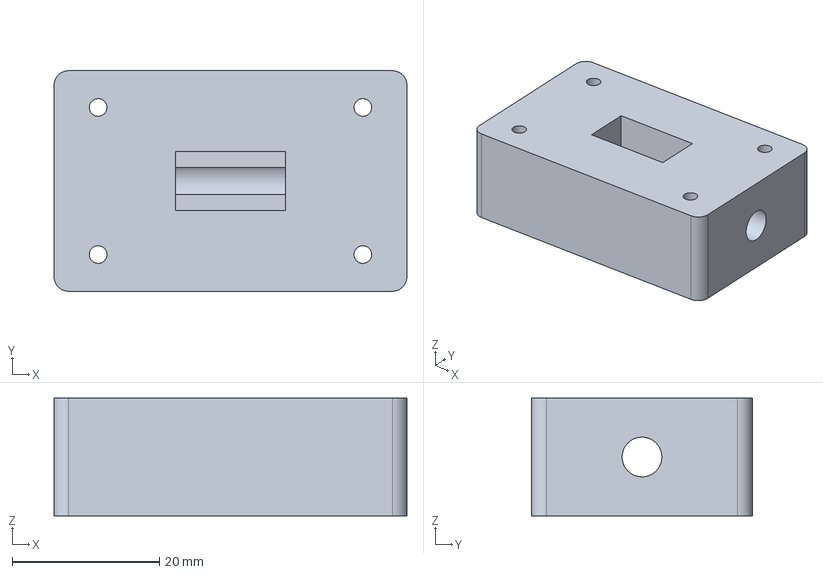
[picture p120: CAD file, 2026-10-11]
hardware/cad/step/machine/S06_syringe_plunger_carriage.step
48.0 x 30.0 x 16.0 mm
