Normansrule/seedforge/hardware/cad/step/machine/F12_sensing_roller_yoke.step

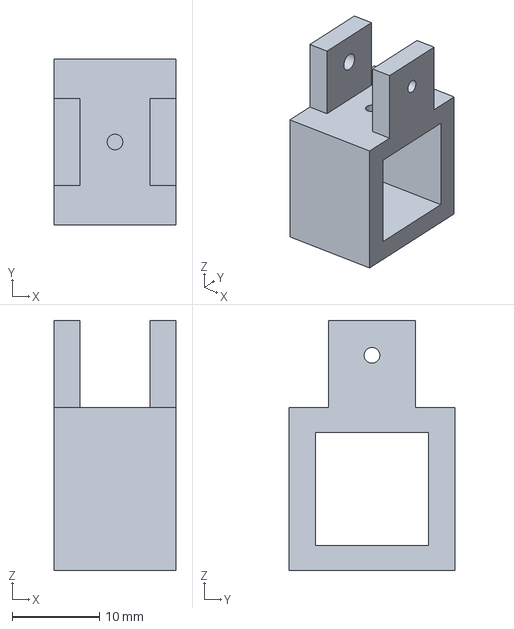
[picture p121: CAD file, 2026-10-11]
hardware/cad/step/machine/F12_sensing_roller_yoke.step
14.0 x 19.0 x 28.7 mm
