Normansrule/seedforge/hardware/cad/step/machine/W15_nema17_body_clamp_rotation.step

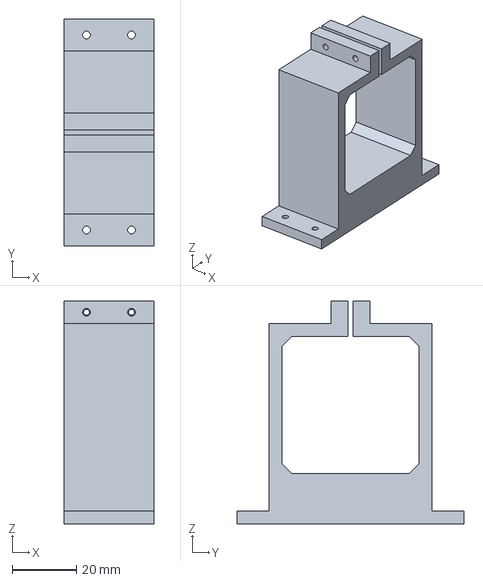
[picture p122: CAD file, 2026-10-11]
hardware/cad/step/machine/W15_nema17_body_clamp_rotation.step
28.0 x 70.6 x 69.3 mm
