Normansrule/seedforge/hardware/cad/step/machine/W02_608_mandrel_support.step

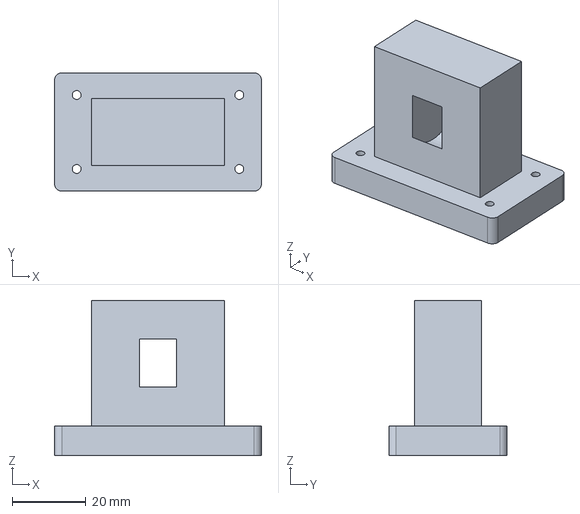
[picture p123: CAD file, 2026-10-11]
hardware/cad/step/machine/W02_608_mandrel_support.step
56.0 x 32.0 x 42.0 mm
