Normansrule/seedforge/(list of files, cad)

Other CAD files:
hardware/cad/step/machine/S04_three_tail_assembly_nest.step
hardware/cad/source/r3_step/D05_pi_zero2w_companion_plate.step
hardware/cad/source/r3_step/S07_tip_mold_half_A.step
hardware/cad/source/r3_step/W05_mandrel_end_guide.step
hardware/cad/step/machine/F09_spool_stand_left_608_bore.step
hardware/cad/step/machine/T02_tail_former_right.step
hardware/cad/source/r3_step/T03_tail_sweep_shoe.step
hardware/cad/step/machine/W03_lm8uu_linear_carriage.step
hardware/cad/source/r3_step/T01_tail_former_left.step
hardware/cad/step/machine/D04_payload_rail_adapter.step
hardware/cad/source/r3_step/D01_four_cell_payload_cassette.step
hardware/cad/step/machine/R08_z_lift_servo_mount.step
hardware/cad/source/r3_step/C05_ili9341_bezel.step
hardware/cad/step/machine/F05_dancer_roller.step
hardware/cad/source/r3_step/F01_spool_stand_left.step
hardware/cad/source/r3_step/S02_seed_singulator_disk_6mm.step
hardware/cad/step/machine/W07_micro_release_clamp_lower.step
hardware/cad/source/r3_step/S08_tip_mold_half_B.step
hardware/cad/step/machine/Z01_fit_calibration_coupon.step
hardware/cad/source/r3_step/R06_gt2_idler_corner_mount.step
hardware/cad/step/machine/C01_module_base_160x120.step
hardware/cad/source/r3_step/S01_seed_hopper.step
hardware/cad/step/machine/T01_tail_former_left.step
hardware/cad/source/r3_step/X01_sg90_clamp_mount.step
hardware/cad/step/machine/O01_finished_seedpod_tray_12.step
hardware/cad/step/machine/C04_electronics_vented_lid.step
hardware/cad/source/r3_step/W08_micro_release_clamp_upper.step
hardware/cad/step/machine/R05_gt2_nema17_corner_mount.step
hardware/cad/source/r3_step/R04_vwheel_or_mgn12_carriage_adapter.step
hardware/cad/step/machine/W10_linear_idler_end_block.step
hardware/cad/source/r3_step/F06_veneer_guide_45deg_lower.step
hardware/cad/step/machine/S07_tip_mold_half_A.step
hardware/cad/source/r3_step/F04_dancer_arm.step
hardware/cad/step/machine/S03_28byj_seed_indexer_mount.step
hardware/cad/source/r3_step/D02_single_drop_door.step
hardware/cad/source/r3_step/R03_soft_gripper_finger.step
hardware/cad/source/r3_step/F03_spool_hub.step
hardware/cad/step/machine/W08_micro_release_clamp_upper.step
hardware/cad/source/r3_step/X02_soft_clamp_jaw.step
hardware/cad/step/machine/W01_nema17_rotation_mount.step
hardware/cad/step/machine/F10_spool_hub_8mm_bore.step
hardware/cad/step/machine/X03_guarded_shear_mount.step
hardware/cad/source/r3_step/R07_xy_tool_carriage.step
hardware/cad/step/machine/C03_electronics_box.step
hardware/cad/step/machine/F01_spool_stand_left.step
hardware/cad/step/machine/R01_gantry_tool_plate.step
hardware/cad/step/machine/F07_veneer_guide_lid.step
hardware/cad/step/machine/D06_downward_camera_mount.step
hardware/cad/step/machine/W06_camera_tilt_mount.step
hardware/cad/step/machine/D03_payload_servo_mount.step
hardware/cad/step/machine/Q01_free_dry_tray.step
hardware/cad/3mf/machine/C01_module_base_160x120.3mf
hardware/cad/3mf/machine/C02_cable_clip_dual.3mf
hardware/cad/3mf/machine/C03_electronics_box.3mf
hardware/cad/3mf/machine/C04_electronics_vented_lid.3mf
hardware/cad/3mf/machine/C05_ili9341_bezel.3mf
hardware/cad/3mf/machine/D01_four_cell_payload_cassette.3mf
hardware/cad/3mf/machine/D02_single_drop_door.3mf
hardware/cad/3mf/machine/D03_payload_servo_mount.3mf
hardware/cad/3mf/machine/D04_payload_rail_adapter.3mf
hardware/cad/3mf/machine/D05_pi_zero2w_companion_plate.3mf
hardware/cad/3mf/machine/D06_downward_camera_mount.3mf
hardware/cad/3mf/machine/F01_spool_stand_left.3mf
hardware/cad/3mf/machine/F02_spool_stand_right.3mf
hardware/cad/3mf/machine/F03_spool_hub.3mf
hardware/cad/3mf/machine/F04_dancer_arm.3mf
hardware/cad/3mf/machine/F05_dancer_roller.3mf
hardware/cad/3mf/machine/F06_veneer_guide_45deg_lower.3mf
hardware/cad/3mf/machine/F07_veneer_guide_lid.3mf
hardware/cad/3mf/machine/F08_load_cell_mount.3mf
hardware/cad/3mf/machine/F09_spool_stand_left_608_bore.3mf
hardware/cad/3mf/machine/F10_spool_hub_8mm_bore.3mf
hardware/cad/3mf/machine/F11_dancer_pivot_post.3mf
hardware/cad/3mf/machine/F12_sensing_roller_yoke.3mf
hardware/cad/3mf/machine/F13_load_cell_clamp_cap.3mf
hardware/cad/3mf/machine/O01_finished_seedpod_tray_12.3mf
hardware/cad/3mf/machine/Q01_free_dry_tray.3mf
hardware/cad/3mf/machine/Q02_120mm_usb_fan_bracket.3mf
hardware/cad/3mf/machine/Q03_camera_led_ring_plate.3mf
hardware/cad/3mf/machine/R01_gantry_tool_plate.3mf
hardware/cad/3mf/machine/R02_sg90_gripper_body.3mf
hardware/cad/3mf/machine/R03_soft_gripper_finger.3mf
hardware/cad/3mf/machine/R04_vwheel_or_mgn12_carriage_adapter.3mf
hardware/cad/3mf/machine/R05_gt2_nema17_corner_mount.3mf
hardware/cad/3mf/machine/R06_gt2_idler_corner_mount.3mf
hardware/cad/3mf/machine/R07_xy_tool_carriage.3mf
hardware/cad/3mf/machine/R08_z_lift_servo_mount.3mf
hardware/cad/3mf/machine/S01_seed_hopper.3mf
hardware/cad/3mf/machine/S02_seed_singulator_disk_6mm.3mf
hardware/cad/3mf/machine/S03_28byj_seed_indexer_mount.3mf
hardware/cad/3mf/machine/S04_three_tail_assembly_nest.3mf
hardware/cad/3mf/machine/S05_10ml_syringe_holder.3mf
hardware/cad/3mf/machine/S06_syringe_plunger_carriage.3mf
hardware/cad/3mf/machine/S07_tip_mold_half_A.3mf
hardware/cad/3mf/machine/S08_tip_mold_half_B.3mf
hardware/cad/3mf/machine/T01_tail_former_left.3mf
hardware/cad/3mf/machine/T02_tail_former_right.3mf
hardware/cad/3mf/machine/T03_tail_sweep_shoe.3mf
hardware/cad/3mf/machine/T04_tail_blank_clamp.3mf
hardware/cad/3mf/machine/W01_nema17_rotation_mount.3mf
hardware/cad/3mf/machine/W02_608_mandrel_support.3mf
hardware/cad/3mf/machine/W03_lm8uu_linear_carriage.3mf
hardware/cad/3mf/machine/W04_t8_nut_carrier.3mf
hardware/cad/3mf/machine/W05_mandrel_end_guide.3mf
hardware/cad/3mf/machine/W06_camera_tilt_mount.3mf
hardware/cad/3mf/machine/W07_micro_release_clamp_lower.3mf
hardware/cad/3mf/machine/W08_micro_release_clamp_upper.3mf
hardware/cad/3mf/machine/W09_linear_motor_end_block.3mf
hardware/cad/3mf/machine/W10_linear_idler_end_block.3mf
hardware/cad/3mf/machine/W11_lm8uu_traverse_carriage.3mf
hardware/cad/3mf/machine/W12_angle_adjustable_guide_arm.3mf
hardware/cad/3mf/machine/W13_w05_axis_riser_11mm.3mf
hardware/cad/3mf/machine/W14_limit_switch_rod_clamp.3mf
hardware/cad/3mf/machine/W15_nema17_body_clamp_rotation.3mf
hardware/cad/3mf/machine/W16_nema17_body_clamp_linear.3mf
hardware/cad/3mf/machine/W17_camera_mast_foot.3mf
hardware/cad/3mf/machine/W18_camera_arm.3mf
hardware/cad/3mf/machine/X01_sg90_clamp_mount.3mf
hardware/cad/3mf/machine/X02_soft_clamp_jaw.3mf
hardware/cad/3mf/machine/X03_guarded_shear_mount.3mf
hardware/cad/3mf/machine/X04_cutter_guard.3mf
hardware/cad/3mf/machine/Z01_fit_calibration_coupon.3mf
hardware/cad/3mf/reference/MR01_0p8mm_x100mm_FORMING_MANDREL_REFERENCE.3mf
hardware/cad/3mf/reference/MR02_0p8mm_to_5mm_split_collet_INSERT.3mf
hardware/cad/3mf/reference/MR03_mandrel_depth_stop_M2.3mf
hardware/cad/3mf/reference/MR04_0p8mm_guide_bushing.3mf
hardware/cad/3mf/reference/MR05_3mm_x140mm_LARGE_PINE_MANDREL_REFERENCE.3mf
hardware/cad/3mf/reference/MR06_COMPLETE_0p8mm_MANDREL_SUBASSEMBLY_REFERENCE.3mf
hardware/cad/3mf/reference/MR07_0p8mm_MANDREL_WITH_STANDARD_7COIL_BODY_REFERENCE.3mf
hardware/cad/3mf/reference/PR01_standard_7coil_body_2p5x0p5_on_0p8.3mf
hardware/cad/3mf/reference/PR02_standard_tail1_27mm.3mf
hardware/cad/3mf/reference/PR03_standard_tail2_29p5mm.3mf
hardware/cad/3mf/reference/PR04_standard_tail3_32p5mm.3mf
hardware/cad/3mf/reference/PR05_standard_tip_outer_reference.3mf
hardware/cad/3mf/reference/PR06_standard_seed_payload_envelope.3mf
hardware/cad/3mf/reference/PR07_tip_hair_clearance_envelope.3mf
hardware/cad/3mf/reference/PR08_STANDARD_FINISHED_3TAIL_SEED_CARRIER_1TO1.3mf
hardware/cad/3mf/reference/PR09_STANDARD_SEED_CARRIER_EXPLODED_1TO1.3mf
hardware/cad/3mf/reference/PR10_primary_blank_48x2p5x0p5_reference.3mf
hardware/cad/3mf/reference/PR11_aux_tail_blank_29p5x2p5x0p5_reference.3mf
hardware/cad/3mf/reference/PR12_aux_tail_blank_32p5x2p5x0p5_reference.3mf
hardware/cad/3mf/reference/PR20_LARGE_PINE_7COIL_BODY_12x0p8_on_3mm.3mf
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
