Normansrule/seedforge/validation/README.md

# Validation

| file | use |
|---|---|
| [ACCEPTANCE_CRITERIA.md](ACCEPTANCE_CRITERIA.md) | every phase gate as a checkable table |
| [TEST_PROCEDURES.md](TEST_PROCEDURES.md) | how to run the tests behind each gate |
| [CALIBRATION_WORKSHEET.csv](CALIBRATION_WORKSHEET.csv) | calibrations C1-C14 and Phase-0 material data |
| [RUN_LOG_TEMPLATE.csv](RUN_LOG_TEMPLATE.csv) | trace columns (what `--log` writes to `trace.csv`) |
| [CARRIER_LOG_TEMPLATE.csv](CARRIER_LOG_TEMPLATE.csv) | carrier columns (what `--log` writes to `carriers.csv`) |
| [status.yaml](status.yaml) | current evidence level of each item and phase; drives the website status dashboard |

Background and evidence levels: [docs/validation.md](../docs/validation.md).
