Normansrule/seedforge/datasets/test/README.md

# datasets/test

Placeholder. See ../README.md for format and split rules. No real images yet.
