Normansrule/seedforge/datasets/validation/README.md

# datasets/validation

Placeholder. See ../README.md for format and split rules. No real images yet.
