Normansrule/seedforge/hardware/cad/QA_REPORT.md

# CAD QA report

Generated by `python tools/build_cad.py`. Do not edit by hand.

**What this report can and cannot say.** `cad_valid` means: positive volume, non-zero size, watertight and
consistently wound mesh, millimetre-plausible size and (machine parts) fits the Bambu Lab A1 Mini
180 x 180 x 180 mm envelope. It does **not** mean the part has been printed, that it fits its purchased
parts, that the mechanism works, or that the process is validated. Those columns stay
`not recorded` / `not tested` until someone fills them in from a real build.

* Machine/tooling parts: **71** (71 CAD-valid, 0 failing)
* Reference models: **24** (22 watertight)
* Machine parts with more than one disconnected body: S01, T03

## Core-cell interference check (R3.1 layout)

* Static interference between fixed parts: **0 pairs**
* Collision-free carriage-centre window (x, mm) by guide angle, sampled every 5 mm:

| guide angle (deg) | carriage x window (mm) |
|---|---|
| -60 | 60 - 120 |
| -45 | 45 - 150 |
| -30 | 45 - 150 |
| +0 | 45 - 150 |
| +30 | 45 - 150 |
| +45 | 45 - 150 |
| +60 | 85 - 150 |

Home trips at carriage x = 45 mm (firmware position 0). The checker intersects solid models of the
printed parts and nominal purchased-part proxies; real purchased parts may differ - MEASURE BEFORE FINAL FABRICATION.

## Parts

| id | status | module | qty | bbox mm | vol cm3 | watertight | bodies | A1 Mini | CAD valid |
|---|---|---|---|---|---|---|---|---|---|
| C01 | optional | C | 7 | 160.0 x 120.0 x 6.0 | 112.391 | yes | 1 | yes | yes |
| C02 | core | C | 10 | 28.0 x 16.0 x 12.0 | 4.29 | yes | 1 | yes | yes |
| C03 | core | C | 1 | 170.0 x 110.0 x 42.0 | 149.664 | yes | 1 | yes | yes |
| C04 | core | C | 1 | 170.0 x 110.0 x 3.0 | 52.195 | yes | 1 | yes | yes |
| C05 | core | C | 1 | 84.0 x 64.0 x 5.0 | 14.358 | yes | 1 | yes | yes |
| D01 | upcoming | M10 | 1 | 150.0 x 150.0 x 78.0 | 276.893 | yes | 1 | yes | yes |
| D02 | upcoming | M10 | 4 | 66.0 x 66.0 x 5.0 | 21.64 | yes | 1 | yes | yes |
| D03 | upcoming | M10 | 4 | 44.0 x 32.0 x 32.0 | 14.679 | yes | 1 | yes | yes |
| D04 | upcoming | M10 | 1 | 150.0 x 100.0 x 4.0 | 53.693 | yes | 1 | yes | yes |
| D05 | upcoming | M10 | 1 | 80.0 x 52.0 x 3.0 | 11.962 | yes | 1 | yes | yes |
| D06 | upcoming | M10 | 1 | 52.0 x 40.0 x 32.0 | 19.381 | yes | 1 | yes | yes |
| F01 | superseded | M1 | 1 | 70.0 x 36.0 x 86.0 | 46.071 | yes | 1 | yes | yes |
| F02 | core | M1 | 1 | 70.0 x 36.0 x 86.0 | 41.43 | yes | 1 | yes | yes |
| F03 | superseded | M1 | 2 | 62.0 x 62.0 x 18.0 | 28.774 | yes | 1 | yes | yes |
| F04 | core | M1 | 1 | 82.0 x 14.0 x 6.0 | 6.03 | yes | 1 | yes | yes |
| F05 | core | M1 | 2 | 30.0 x 30.0 x 10.0 | 5.237 | yes | 1 | yes | yes |
| F06 | core | M1 | 1 | 55.0 x 28.0 x 8.0 | 11.263 | yes | 1 | yes | yes |
| F07 | core | M1 | 1 | 55.0 x 28.0 x 2.5 | 3.8 | yes | 1 | yes | yes |
| F08 | core | M1 | 1 | 50.0 x 44.0 x 24.4 | 21.366 | yes | 1 | yes | yes |
| F09 | core | M1 | 1 | 70.0 x 36.0 x 86.0 | 42.744 | yes | 1 | yes | yes |
| F10 | core | M1 | 2 | 62.0 x 62.0 x 18.0 | 28.584 | yes | 1 | yes | yes |
| F11 | core | M1 | 1 | 50.0 x 40.0 x 70.0 | 15.7 | yes | 1 | yes | yes |
| F12 | core | M1 | 1 | 14.0 x 19.0 x 28.7 | 3.18 | yes | 1 | yes | yes |
| F13 | core | M1 | 1 | 30.0 x 24.0 x 4.0 | 2.804 | yes | 1 | yes | yes |
| O01 | upcoming | M8 | 2 | 160.0 x 120.0 x 14.0 | 120.191 | yes | 1 | yes | yes |
| Q01 | upcoming | M5 | 4 | 160.0 x 120.0 x 10.0 | 88.211 | yes | 1 | yes | yes |
| Q02 | upcoming | M5 | 1 | 130.0 x 28.0 x 30.0 | 35.524 | yes | 1 | yes | yes |
| Q03 | superseded | M7 | 1 | 78.0 x 62.0 x 6.0 | 19.108 | yes | 1 | yes | yes |
| R01 | upcoming | M9 | 1 | 80.0 x 60.0 x 6.0 | 27.696 | yes | 1 | yes | yes |
| R02 | upcoming | M9 | 1 | 64.0 x 42.0 x 24.0 | 57.521 | yes | 1 | yes | yes |
| R03 | upcoming | M9 | 2 | 58.0 x 12.0 x 18.0 | 6.914 | yes | 1 | yes | yes |
| R04 | upcoming | M9 | 1 | 72.0 x 56.0 x 8.0 | 30.383 | yes | 1 | yes | yes |
| R05 | upcoming | M9 | 2 | 70.0 x 46.0 x 64.0 | 39.538 | yes | 1 | yes | yes |
| R06 | upcoming | M9 | 2 | 58.0 x 44.0 x 38.0 | 29.938 | yes | 1 | yes | yes |
| R07 | upcoming | M9 | 1 | 86.0 x 64.0 x 8.0 | 42.342 | yes | 1 | yes | yes |
| R08 | upcoming | M9 | 1 | 54.0 x 36.0 x 40.0 | 24.222 | yes | 1 | yes | yes |
| S01 | needs repair | M6 | 1 | 95.0 x 95.0 x 98.0 | 180.159 | yes | 2 | yes | yes |
| S02 | upcoming | M6 | 1 | 72.0 x 72.0 x 5.0 | 19.023 | yes | 1 | yes | yes |
| S03 | upcoming | M6 | 1 | 68.0 x 56.0 x 42.0 | 42.482 | yes | 1 | yes | yes |
| S04 | upcoming | M6 | 1 | 116.0 x 116.0 x 8.0 | 80.576 | yes | 1 | yes | yes |
| S05 | upcoming | M6 | 1 | 72.0 x 52.0 x 28.0 | 76.471 | yes | 1 | yes | yes |
| S06 | upcoming | M6 | 1 | 48.0 x 30.0 x 16.0 | 20.714 | yes | 1 | yes | yes |
| S07 | experimental | M6 | 2 | 72.0 x 48.0 x 14.0 | 43.651 | yes | 1 | yes | yes |
| S08 | experimental | M6 | 2 | 72.0 x 48.0 x 14.0 | 43.651 | yes | 1 | yes | yes |
| T01 | upcoming | M4 | 2 | 23.8 x 44.0 x 8.8 | 4.253 | yes | 1 | yes | yes |
| T02 | upcoming | M4 | 2 | 23.8 x 44.0 x 8.8 | 4.253 | yes | 1 | yes | yes |
| T03 | needs repair | M4 | 1 | 43.59 x 31.0 x 5.0 | 2.657 | yes | 2 | yes | yes |
| T04 | upcoming | M4 | 2 | 46.0 x 22.0 x 24.0 | 9.279 | yes | 1 | yes | yes |
| W01 | core | M2 | 1 | 66.0 x 66.0 x 66.0 | 58.088 | yes | 1 | yes | yes |
| W02 | optional | M2 | 1 | 56.0 x 32.0 x 42.0 | 32.698 | yes | 1 | yes | yes |
| W03 | superseded | M2 | 1 | 90.0 x 70.0 x 30.0 | 75.803 | yes | 1 | yes | yes |
| W04 | superseded | M2 | 1 | 50.0 x 42.0 x 28.0 | 29.138 | yes | 1 | yes | yes |
| W05 | core | M2 | 1 | 42.0 x 36.0 x 40.0 | 15.828 | yes | 1 | yes | yes |
| W06 | superseded | M7 | 1 | 58.0 x 42.0 x 40.0 | 25.926 | yes | 1 | yes | yes |
| W07 | experimental | M3 | 1 | 34.0 x 12.0 x 26.0 | 5.046 | yes | 1 | yes | yes |
| W08 | experimental | M3 | 1 | 34.0 x 12.0 x 26.0 | 5.046 | yes | 1 | yes | yes |
| W09 | core | M2 | 1 | 28.0 x 78.0 x 48.0 | 56.82 | yes | 1 | yes | yes |
| W10 | core | M2 | 1 | 28.0 x 78.0 x 48.0 | 59.645 | yes | 1 | yes | yes |
| W11 | core | M2 | 1 | 40.0 x 77.2 x 22.6 | 51.529 | yes | 1 | yes | yes |
| W12 | core | M1/M2 | 1 | 157.13 x 76.6 x 14.25 | 30.17 | yes | 1 | yes | yes |
| W13 | core | M2 | 1 | 42.0 x 36.0 x 11.0 | 16.225 | yes | 1 | yes | yes |
| W14 | core | M2 | 2 | 10.0 x 40.5 x 21.5 | 3.549 | yes | 1 | yes | yes |
| W15 | core | M2 | 1 | 28.0 x 70.6 x 69.3 | 41.941 | yes | 1 | yes | yes |
| W16 | core | M2 | 1 | 28.0 x 70.6 x 54.3 | 20.689 | yes | 1 | yes | yes |
| W17 | core | M7 | 1 | 40.0 x 24.0 x 40.0 | 9.451 | yes | 1 | yes | yes |
| W18 | core | M7 | 1 | 42.0 x 83.0 x 62.0 | 19.836 | yes | 1 | yes | yes |
| X01 | core | M3 | 1 | 68.0 x 44.0 x 32.0 | 32.705 | yes | 1 | yes | yes |
| X02 | core | M3 | 2 | 34.0 x 13.0 x 12.0 | 3.781 | yes | 1 | yes | yes |
| X03 | core | M3 | 1 | 88.0 x 58.0 x 41.0 | 53.168 | yes | 1 | yes | yes |
| X04 | core | M3 | 1 | 96.0 x 66.0 x 44.0 | 73.921 | yes | 1 | yes | yes |
| Z01 | core | Z | 1 | 110.0 x 55.0 x 5.0 | 28.142 | yes | 1 | yes | yes |
| MR01 | reference | reference |  | 0.8 x 0.8 x 100.0 | 0.05 | yes | 1 | yes | yes |
| MR02 | experimental print | reference |  | 5.0 x 5.0 x 12.0 | 0.219 | yes | 1 | yes | yes |
| MR03 | reference | reference |  | 8.0 x 8.0 x 5.0 | 0.219 | yes | 1 | yes | yes |
| MR04 | reference | reference |  | 8.0 x 8.0 x 10.0 | 0.494 | yes | 1 | yes | yes |
| MR05 | reference | reference |  | 3.0 x 3.0 x 140.0 | 0.989 | yes | 1 | yes | yes |
| MR06 | reference | reference |  | 12.0 x 12.0 x 124.0 | 2.529 | yes | 3 | yes | yes |
| MR07 | reference | reference |  | 2.64 x 2.64 x 100.79 | 0.107 | yes | 2 | yes | yes |
| PR01 | reference | reference |  | 2.64 x 2.64 x 36.58 | 0.056 | yes | 1 | yes | yes |
| PR02 | reference | reference |  | 12.18 x 10.48 x 13.21 | 0.034 | yes | 1 | yes | yes |
| PR03 | reference | reference |  | 14.77 x 11.61 x 13.27 | 0.037 | yes | 1 | yes | yes |
| PR04 | reference | reference |  | 11.02 x 17.51 x 13.34 | 0.04 | yes | 1 | yes | yes |
| PR05 | reference | reference |  | 5.51 x 5.53 x 14.5 | 0.191 | yes | 1 | yes | yes |
| PR06 | reference | reference |  | 3.6 x 2.5 x 4.8 | 0.022 | yes | 1 | yes | yes |
| PR07 | reference | reference |  | 9.28 x 9.26 x 16.7 | 0.557 | yes | 1 | yes | yes |
| PR08 | reference | reference |  | 18.67 x 22.02 x 54.48 | 0.38 | yes | 6 | yes | yes |
| PR09 | reference | reference |  | 48.28 x 55.1 x 84.48 | 0.38 | yes | 6 | yes | yes |
| PR10 | reference | reference |  | 48.0 x 2.5 x 0.5 | 0.06 | yes | 1 | yes | yes |
| PR11 | reference | reference |  | 29.5 x 2.5 x 0.5 | 0.037 | yes | 1 | yes | yes |
| PR12 | reference | reference |  | 32.5 x 2.5 x 0.5 | 0.041 | yes | 1 | yes | yes |
| PR20 | reference | reference |  | 9.72 x 9.72 x 93.41 | 1.143 | yes | 1 | yes | yes |
| PR21 | reference | reference |  | 9.0 x 5.51 x 11.0 | 0.288 | yes | 1 | yes | yes |
| PR22 | reference | reference |  | 14.26 x 14.25 x 29.0 | 2.165 | NO | 2 | yes | n/a |
| PR23 | reference | reference |  | 14.26 x 14.25 x 117.21 | 3.597 | NO | 4 | yes | n/a |
| PR24 | demo print | reference |  | 56.01 x 66.05 x 163.44 | 10.268 | yes | 6 | yes | yes |
