Normansrule/seedforge/archive/seedforge-r3-package/docs/QA.txt

Unique parts: 55
STL/STEP/3MF present for all parts.
Watertight STL and <=180 mm check errors: 0
