Normansrule/seedforge/archive/seedforge-r3-package/cad/paper_reference/QA_reference_models.txt

MR01_0p8mm_x100mm_FORMING_MANDREL_REFERENCE.stl: watertight=False, faces=332, bbox_mm=[0.8, 0.8, 100.0]
MR02_0p8mm_to_5mm_split_collet_INSERT.stl: watertight=False, faces=702, bbox_mm=[5.0, 5.0, 12.0]
MR03_mandrel_depth_stop_M2.stl: watertight=False, faces=1640, bbox_mm=[8.0, 8.0, 5.0]
MR04_0p8mm_guide_bushing.stl: watertight=False, faces=672, bbox_mm=[8.0, 8.0, 10.0]
MR05_3mm_x140mm_LARGE_PINE_MANDREL_REFERENCE.stl: watertight=False, faces=332, bbox_mm=[3.0, 3.0, 140.0]
MR06_COMPLETE_0p8mm_MANDREL_SUBASSEMBLY_REFERENCE.stl: watertight=False, faces=2658, bbox_mm=[12.0, 12.0, 124.0]
MR07_0p8mm_MANDREL_WITH_STANDARD_7COIL_BODY_REFERENCE.stl: watertight=False, faces=24970, bbox_mm=[2.644, 2.644, 100.791]
PR01_standard_7coil_body_2p5x0p5_on_0p8.stl: watertight=False, faces=55558, bbox_mm=[2.644, 2.644, 36.582]
PR02_standard_tail1_27mm.stl: watertight=False, faces=20914, bbox_mm=[12.177, 10.482, 13.214]
PR03_standard_tail2_29p5mm.stl: watertight=False, faces=18022, bbox_mm=[14.77, 11.607, 13.271]
PR04_standard_tail3_32p5mm.stl: watertight=False, faces=17272, bbox_mm=[11.023, 17.512, 13.338]
PR05_standard_tip_outer_reference.stl: watertight=False, faces=3692, bbox_mm=[5.509, 5.532, 14.5]
PR06_standard_seed_payload_envelope.stl: watertight=False, faces=3208, bbox_mm=[3.6, 2.496, 4.8]
PR07_tip_hair_clearance_envelope.stl: watertight=False, faces=3314, bbox_mm=[9.276, 9.255, 16.7]
PR08_STANDARD_FINISHED_3TAIL_SEED_CARRIER_1TO1.stl: watertight=False, faces=118666, bbox_mm=[18.667, 22.019, 54.479]
PR09_STANDARD_SEED_CARRIER_EXPLODED_1TO1.stl: watertight=False, faces=115980, bbox_mm=[48.278, 55.105, 84.48]
PR10_primary_blank_48x2p5x0p5_reference.stl: watertight=False, faces=12, bbox_mm=[48.0, 2.5, 0.5]
PR11_aux_tail_blank_29p5x2p5x0p5_reference.stl: watertight=False, faces=12, bbox_mm=[29.5, 2.5, 0.5]
PR12_aux_tail_blank_32p5x2p5x0p5_reference.stl: watertight=False, faces=12, bbox_mm=[32.5, 2.5, 0.5]
PR20_LARGE_PINE_7COIL_BODY_12x0p8_on_3mm.stl: watertight=False, faces=107034, bbox_mm=[9.715, 9.715, 93.413]
PR21_whitebark_pine_seed_11mm_ENVELOPE.stl: watertight=False, faces=3730, bbox_mm=[9.0, 5.511, 11.0]
PR22_large_pine_tip_outer_ENVELOPE.stl: watertight=False, faces=11076, bbox_mm=[14.265, 14.249, 29.0]
PR23_LARGE_PINE_BODY_TIP_SEED_REFERENCE_NO_TAILS.stl: watertight=False, faces=121840, bbox_mm=[14.265, 14.249, 117.206]
