Normansrule/seedforge/archive/seedforge-r3-package/r3_validation/CALIBRATION_WORKSHEET.csv

field | value
run_id
date
operator
material_lot
species_or_payload
recipe | EECS149_CLASS or PAPER_REFERENCE
veneer_width_wet_mm
veneer_thickness_wet_mm
veneer_width_dry_mm
veneer_thickness_dry_mm
mandrel_diameter_mm | 0.8
mandrel_runout_mm
target_active_turns | 7
sacrificial_turn_allowance | 1 total starting point
stepper_full_steps_rev | 200
microstep_setting | 16
rotation_microsteps_rev | 3200
lead_screw_lead_mm_rev | 8
linear_microsteps_mm | 400
commanded_pitch_mm_rev
measured_pitch_mm_rev
guide_angle_deg
target_tension_N
high_tension_trip_N
break_tension_N
camera_pixels_per_mm
camera_max_gap_mm
camera_max_overlap_mm
body_length_dry_mm
coil_outer_diameter_dry_mm
tail_1_pass
tail_2_pass
tail_3_pass
tip_pass
seed_present_pass
final_qa_pass
notes
