Normansrule/seedforge/releases/RELEASE_NOTES.md

SeedForge v0.3.0-alpha (engineering revision R3.1) - first public release.

**Status: designed, CAD-checked, firmware compile-tested, software unit-tested. Not yet physically validated.**

Bundles:
* `..._PHASE1_PRINTS.zip` - print these first (start with Z01), see the build guide
* `..._SEED_REFERENCE_CAD.zip` - reference carrier models (reconstructed reference, not functional prints)
* `..._DOCUMENTATION.zip` - docs, figures and the static website
* `..._COMPLETE.zip` - the whole repository at this tag

Read docs/getting-started.md and docs/safety.md before building. See CHANGELOG.md for details and
docs/validation.md for what remains to be tested.
