Normansrule/seedforge/firmware/esp32/seedforge_bridge/secrets.example.h

// Copy to secrets.h (git-ignored) to enable Wi-Fi TCP on port 3333.
// Use a lab network you control; the protocol has no authentication.
#pragma once
#define SF_WIFI_SSID "your-lab-network"
#define SF_WIFI_PASSWORD "your-password"
