Normansrule/seedforge/(notices)

Notices in the files:
README.md:
License: MIT / CERN-OHL-S-2.0 / CC BY-SA 4.0
